DMFX-1/Hardware/README.md

# Hardware
Digital Multi FX Hardware:

DMFX-1 => Motherboard
DMFX-2 => Mezzanine board
Meca => Mechanics
  3D Models => 3D models for electronics 

- Block diagram (image, SVG)
- 3D models (FreeCad, STEP)
- Schematics (Eagle CAD, PDF) 
- PCB layout (Eagle CAD, gerbers)
- BoM (Excel, CSV, text)
