DMFX-1/Hardware/DMFX-2/readme-en.txt

DMFX-2 v1.0
Manufacturing info:

Bill of Materials:              DMFX-2 v1.0_BoM.xls

Assembly drawing Top:           DMFX-2 v1.0_assytop.pdf
Assembly Drawing Bottom:        DMFX-2 v1.0_assybot.pdf

Pick & Place Top:               DMFX-2 v1.0.mnt
Pick & Place Bottom:            DMFX-2 v1.0.mnb

Silkscreen Top:                 DMFX-2 v1.0_silkscreen_top.PLC
Silkscreen Bottom:              DMFX-2 v1.0_silkscreen_bottom.PLS

Solder Paste Top:               DMFX-2 v1.0_paste_top.PMC
Solder Paste Bottom:            DMFX-2 v1.0_paste_bottom.PMS

Solder Mask Top:                DMFX-2 v1.0_soldermask_top.STC
Solder Mask Bottom :            DMFX-2 v1.0_soldermask_bottom.STS

Signal Top layer:               DMFX-2 v1.0_signal_top.CMP
Signal layer 2:                 DMFX-2 v1.0_signal_lay2.COP
Signal layer 3:                 DMFX-2 v1.0_signal_lay3.COP
Signal layer 4:                 DMFX-2 v1.0_signal_lay4.COP
Signal layer 5:                 DMFX-2 v1.0_signal_lay5.COP
Signal Bottom layer:            DMFX-2 v1.0_signal_bottom.SOL

Drilling:                       DMFX-2 v1.0_drilling.DRD
Milling:                        DMFX-2 v1.0_milling.MIL

Photoplotter Info: *.gpi
