DMFX-1/Hardware/DMFX_block diagram.png

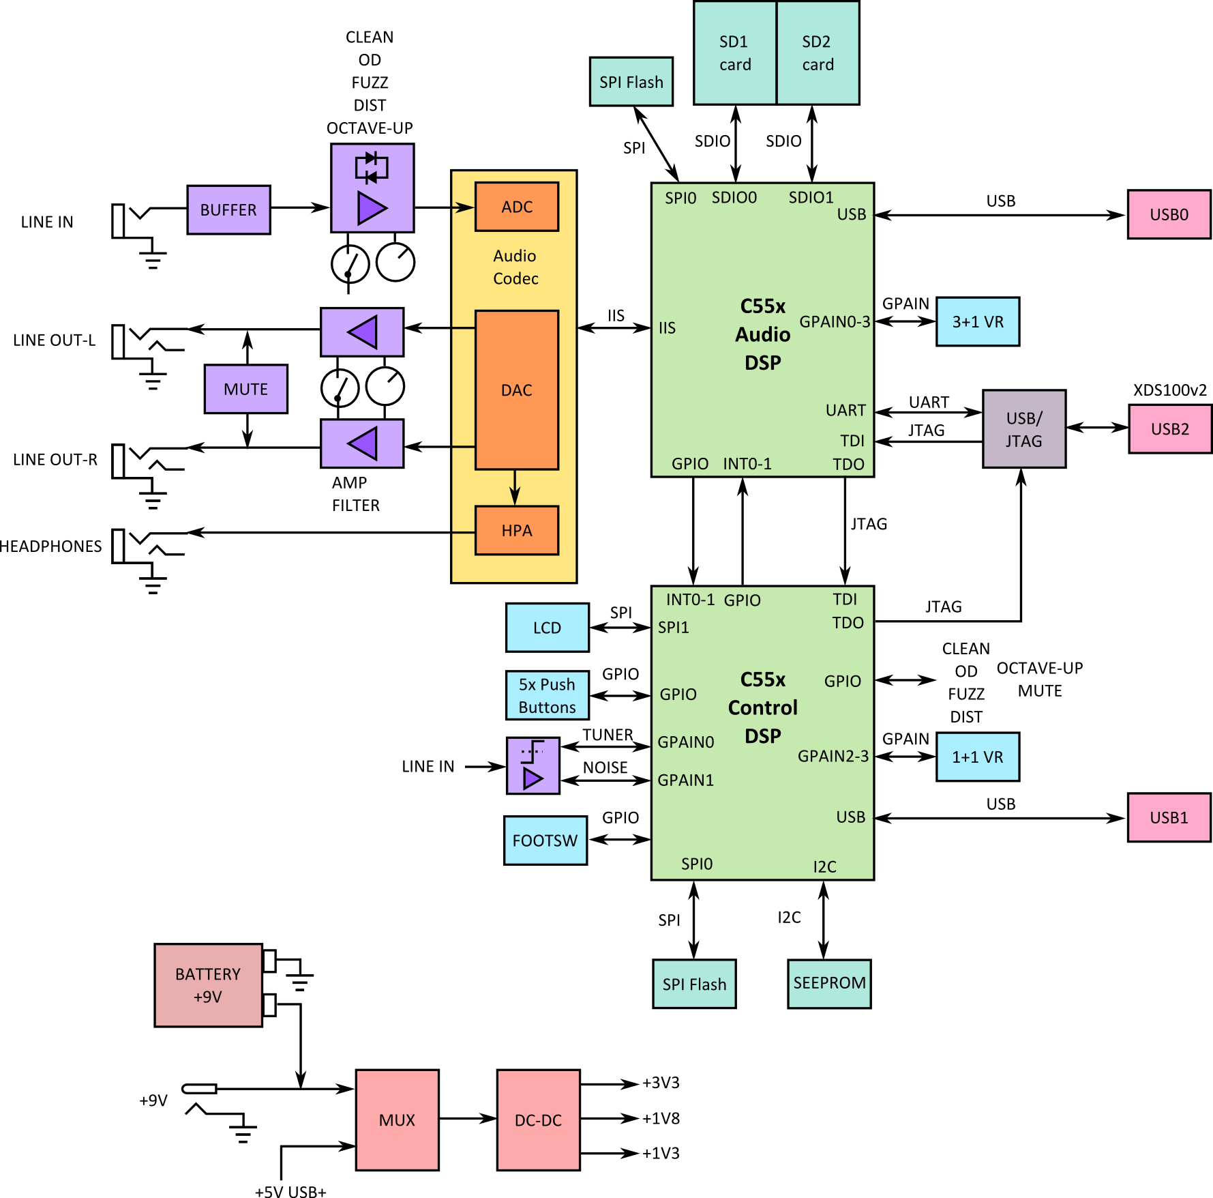
DMFX_block diagram.png
