DMFX-1/Hardware/Meca/3D models/DMFX v1.0-iso1.png

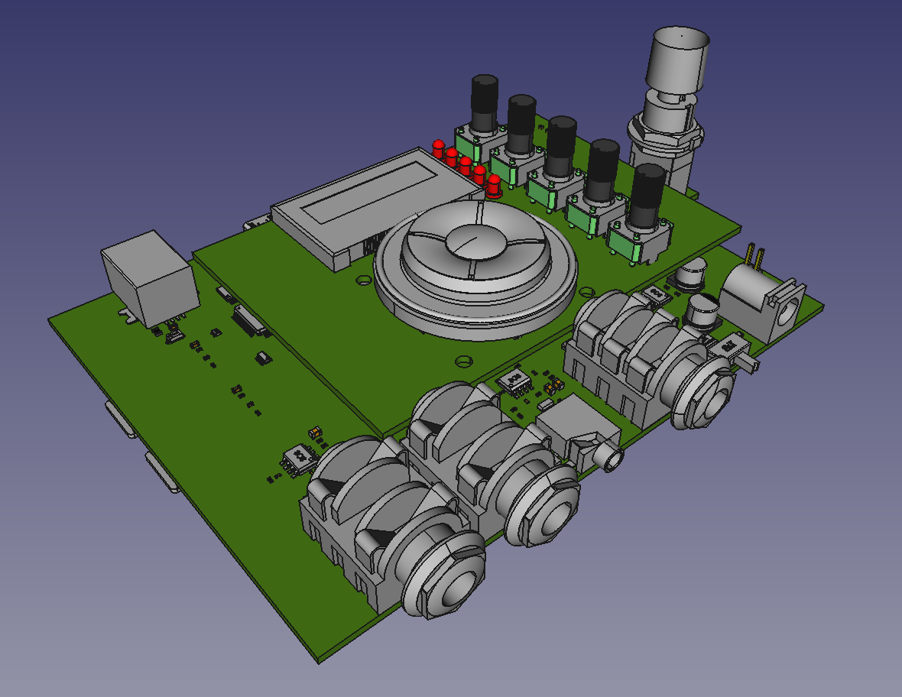
Meca/3D models/DMFX v1.0-iso1.png
