DMFX-1/Hardware/Meca/3D models/DMFX v1.0-iso2.png

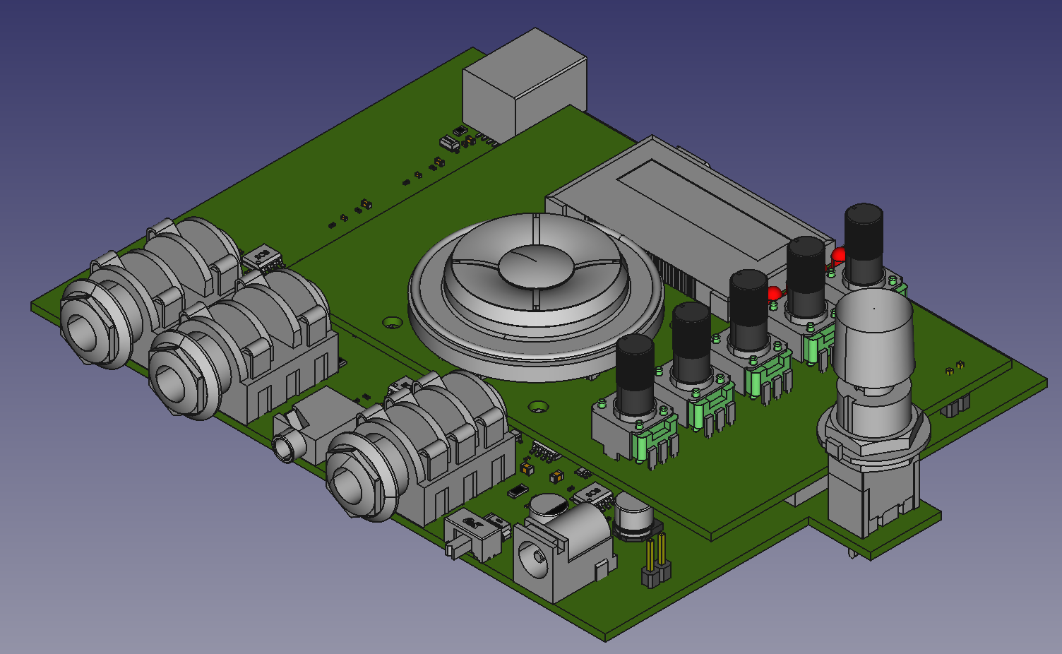
Meca/3D models/DMFX v1.0-iso2.png
