DMFX-1/Hardware/Meca/3D models/DMFX v1.0-left.PNG

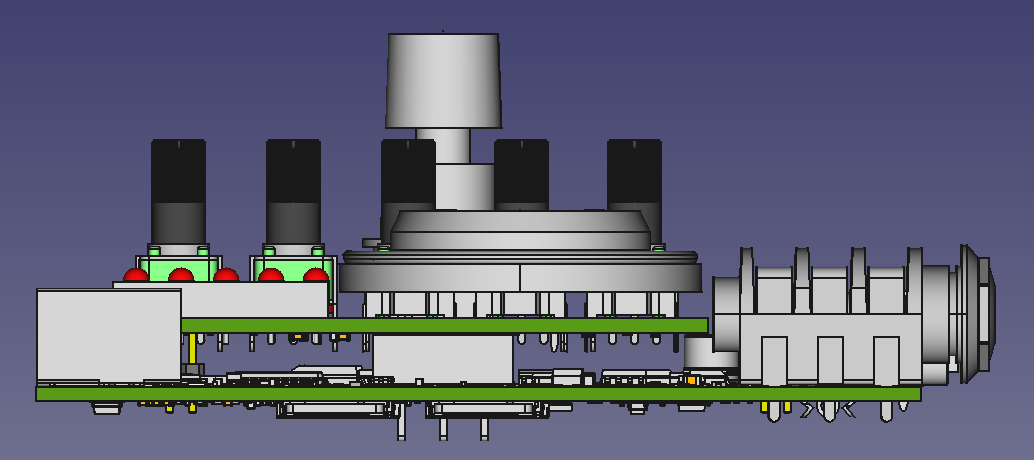
Meca/3D models/DMFX v1.0-left.PNG
