DMFX-1/Hardware/Meca/3D models/DMFX v1.0_rear.PNG

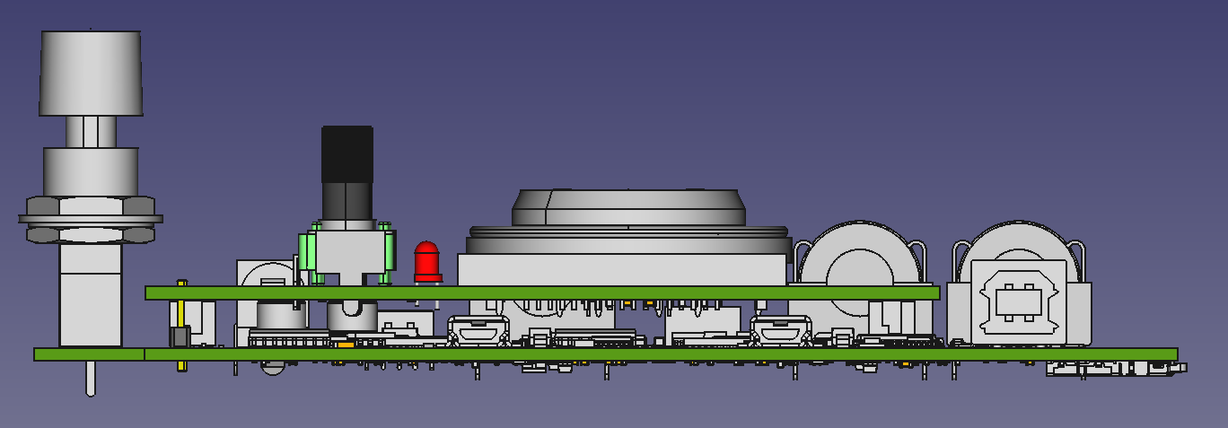
Meca/3D models/DMFX v1.0_rear.PNG
