DMFX-1/Hardware/DFMX-1_2_BoM.xls

Sheet: Eagle BoM
# | Digi-Key Part No. | Manufacturer Name | Mfr Part No. | Customer Reference | Qty1 | Qty2 | Qty3
1 | 160-1140-ND | Lite-On | LTL-4222N | led007 | 5 | 25 | 125
2 | 160-1435-1-ND | Lite-On | LTST-C190KGKT | led005 | 2 | 10 | 50
3 | 160-1456-1-ND | Lite-On | LTST-C230KGKT | led006 | 1 | 5 | 25
4 | 1SMA5920BT3GOSCT-ND | ON Semiconductor | 1SMA5920BT3G | diodez004 | 2 | 10 | 50
5 | 296-13405-1-ND | Texas Instruments | TPS3803-01DCKR | icvdet001 | 1 | 5 | 25
6 | 296-14854-1-ND | Texas Instruments | SN74HC4066DR | icmux002 | 1 | 5 | 25
7 | 296-14908-1-ND | Texas Instruments | SN74LVC1G3157DBVR | icmux001 | 1 | 5 | 25
8 | 296-15807-1-ND | Texas Instruments | TPS73201DBVT | icreg007 | 1 | 5 | 25
9 | 296-21883-1-ND | Texas Instruments | TPD2E001DRLR | tvs002 | 1 | 5 | 25
10 | 296-27589-1-ND | Texas Instruments | CDCLVC1108PWR | icbuf001 | 1 | 5 | 25
11 | 296-29560-ND | Texas Instruments | TMS320C5535AZHH10 | icdsp001 | 2 | 10 | 50
12 | 296-32298-1-ND | Texas Instruments | SN74LVC1G175DBVT | iclog003 | 1 | 5 | 25
13 | 296-32391-1-ND | Texas Instruments | TLV320AIC3204IRHBT | icacdc001 | 1 | 5 | 25
14 | 296-37302-1-ND | Texas Instruments | TPS562209DDCT | icreg006 | 2 | 10 | 50
15 | 296-41312-1-ND | Texas Instruments | LME49721MAX/NOPB | icopamp005 | 5 | 25 | 125
16 | 296-9121-1-ND | Texas Instruments | SN74CBTLV3245APWR | iclog002 | 1 | 5 | 25
17 | 296-9571-1-ND | Texas Instruments | LMV358IDR | icopamp004 | 1 | 5 | 25
18 | 2N7002ET1GOSCT-ND | ON Semiconductor | 2N7002ET1G | mos003 | 3 | 15 | 75
19 | 338-1805-1-ND | CornellDubilier | AVE107M25X16T-F | capelec001 | 2 | 10 | 50
20 | 490-10024-1-ND | Murata | GRM155R70J105KA12D | capcer047 | 22 | 110 | 550
21 | 490-1014-1-ND | Murata | BLM18AG601SN1D | fer007 | 12 | 60 | 300
22 | 490-10487-1-ND | Murata | GRM188R7YA105KA12D | capcer067 | 8 | 40 | 200
23 | 490-10516-1-ND | Murata | GRM21BR71A106KA73L | capcer053 | 9 | 45 | 225
24 | 490-1054-1-ND | Murata | BLM21PG221SN1D | fer005 | 3 | 15 | 75
25 | 490-1056-1-ND | Murata | BLM31PG121SN1L | fer002 | 3 | 15 | 75
26 | 490-10684-1-ND | Murata | GRM1555C1H221FA01D | capcer063 | 3 | 15 | 75
27 | 490-10702-1-ND | Murata | GRM155R71H473KE14D | capcer058 | 1 | 5 | 25
28 | 490-10758-1-ND | Murata | GRM32ER71E226ME15L | capcer066 | 2 | 10 | 50
29 | 490-1312-1-ND | Murata | GRM155R71E103KA01D | capcer050 | 20 | 100 | 500
30 | 490-3242-1-ND | Murata | GRM1555C1H821JA01D | capcer065 | 1 | 5 | 25
31 | 490-3295-1-ND | Murata | GRM188R71C474KA88D | capcer046 | 2 | 10 | 50
32 | 490-3297-1-ND | Murata | GRM188R60J475KE19D | capcer048 | 2 | 10 | 50
33 | 490-4002-1-ND | Murata | BLM15HD601SN1D | fer004 | 1 | 5 | 25
34 | 490-4519-1-ND | Murata | GRM155R60J225ME15D | capcer045 | 1 | 5 | 25
35 | 490-5309-1-ND | Murata | GRM31CR71A226KE15L | capcer056 | 3 | 15 | 75
36 | 490-5418-1-ND | Murata | GRM155R71C224KA12D | capcer062 | 1 | 5 | 25
37 | 490-6186-1-ND | Murata | GRM1555C1H100FA01D | capcer051 | 4 | 20 | 100
38 | 490-6241-1-ND | Murata | GRM1555C1H470FA01D | capcer059 | 1 | 5 | 25
39 | 490-6327-1-ND | Murata | GRM155R71C104JA88D | capcer042 | 91 | 455 | 2275
40 | 490-6345-1-ND | Murata | GRM155R71E333KA88J | capcer057 | 1 | 5 | 25
41 | 490-6349-1-ND | Murata | GRM155R71H102JA01J | capcer043 | 8 | 40 | 200
42 | 490-6356-1-ND | Murata | GRM155R71H183KA12D | capcer054 | 1 | 5 | 25
43 | 490-6359-1-ND | Murata | GRM155R71H222JA01J | capcer044 | 6 | 30 | 150
44 | 490-6365-1-ND | Murata | GRM155R71H822KA88D | capcer049 | 1 | 5 | 25
45 | 490-6985-1-ND | Murata | NFM3DPC223R1H3L | fer001 | 1 | 5 | 25
46 | 490-7201-1-ND | Murata | GRM188R61C106MA73D | capcer052 | 19 | 95 | 475
47 | 490-7303-1-ND | Murata | GRM1555C2A220JA01D | capcer055 | 3 | 15 | 75
48 | 490-7753-1-ND | Murata | GRM1555C1H101FA01J | capcer060 | 10 | 50 | 250
49 | 490-8186-1-ND | Murata | GRM1555C1H151GA01D | capcer061 | 2 | 10 | 50
50 | 490-8262-1-ND | Murata | GRM155R72A681KA01D | capcer064 | 1 | 5 | 25
51 | 490-9703-1-ND | Murata | BLM21AG151SN1D | fer006 | 2 | 10 | 50
52 | 535-9784-1-ND | Abracon LLC | ASDM1-12.000MHZ-LC-T | osc0001 | 1 | 5 | 25
53 | 609-1550-ND | FCI | 87024-610LF | con0019 | 2 | 10 | 50
54 | 609-1553-ND | FCI | 87409-110LF | con015 | 2 | 10 | 50
55 | 609-4700-1-ND | FCI | 10033526-N3212LF | con018 | 2 | 10 | 50
56 | 679-2576-ND | MEC Switches | 5ETH935 | sw0010 | 4 | 20 | 100
57 | 679-2608-ND | MEC Switches | 1ZW0913611806 | sw0007 | 1 | 5 | 25
58 | 679-2609-ND | MEC Switches | 1ZZ09 | sw0008 | 1 | 5 | 25
59 | 679-2610-ND | MEC Switches | 1ZY | sw0007 | 1 | 5 | 25
60 | 679-2612-ND | MEC Switches | 5GTH935 | sw0009 | 1 | 5 | 25
61 | 728-1064-1-ND | Seiko Instruments | SSPT7F-12.5PF20-R | xtal001 | 2 | 10 | 50
62 | 768-1024-1-ND | FTDI | FT2232HL-REEL | icif001 | 1 | 5 | 25
63 | 952-1768-ND | Harwin | M701-370442 | con017 | 1 | 5 | 25
64 | AT24C64D-SSHM-TCT-ND | Atmel | AT24C64D-SSHM-T | icmem001 | 1 | 5 | 25
65 | AT93C46D-TH-TCT-ND | Atmel | AT93C46D-TH-T | icmem003 | 1 | 5 | 25
66 | ATCC-211B-010-107M-TCT-ND | Abracon LLC | ATCC-211B-010-107M-T | captant002 | 2 | 10 | 50
67 | BAT54LT1GOSCT-ND | ON Semiconductor | BAT54LT1G | diodes005 | 1 | 5 | 25
68 | BAT54SLT1GOSCT-ND | ON Semiconductor | BAT54SLT1G | diodes004 | 2 | 10 | 50
69 | CKN9559-ND | C&K Components | OS102011MA1QN1 | sw0006 | 1 | 5 | 25
70 | CP1-3515SJCT-ND | CUI | SJ1-3515-SMT-TR | con016 | 1 | 5 | 25
71 | CP-202A-ND | CUI | PJ-202A | con014 | 1 | 5 | 25
72 | HR1942CT-ND | Hirose | DM3BT-DSF-PEJS | con013 | 2 | 10 | 50
73 | MB2011SB1W03-DA-ND | NKK Switches | MB2011SB1W03-DA | sw0005 | 1 | 5 | 25
74 | MBR0520LT1GOSCT-ND | ON Semiconductor | MBR0520LT1G | diodes006 | 4 | 20 | 100
75 | MMBF4393CT-ND | Fairchild Semiconductor | MMBF4393 | jfet001 | 1 | 5 | 25
76 | MUN2214T1GOSCT-ND | ON Semiconductor | MUN2214T1G | bjtp001 | 6 | 30 | 150
77 | NHD-C12832A1Z-NSW-BBW-3V3-ND | Newhaven Display Intl | NHD-C12832A1Z-NSW-BBW-3V3 | lcd001 | 1 | 5 | 25
78 | P0.0ACT-ND | Panasonic | ERJ-6GEY0R00V | res104 | 5 | 25 | 125
79 | P0.0JCT-ND | Panasonic | ERJ-2GE0R00X | res074 | 40 | 200 | 1000
80 | P1.00KLCT-ND | Panasonic | ERJ-2RKF1001X | res077 | 9 | 45 | 225
81 | P1.00MLCT-ND | Panasonic | ERJ-2RKF1004X | res076 | 2 | 10 | 50
82 | P1.30KLCT-ND | Panasonic | ERJ-2RKF1301X | res075 | 2 | 10 | 50
83 | P10.0KLCT-ND | Panasonic | ERJ-2RKF1002X | res083 | 64 | 320 | 1600
84 | P10.0LCT-ND | Panasonic | ERJ-2RKF10R0X | res082 | 8 | 40 | 200
85 | P100KLCT-ND | Panasonic | ERJ-2RKF1003X | res095 | 16 | 80 | 400
86 | P100LCT-ND | Panasonic | ERJ-2RKF1000X | res094 | 1 | 5 | 25
87 | P12.0KLCT-ND | Panasonic | ERJ-2RKF1202X | res084 | 8 | 40 | 200
88 | P13.7KLCT-ND | Panasonic | ERJ-2RKF1372X | res085 | 1 | 5 | 25
89 | P15.0KLCT-ND | Panasonic | ERJ-2RKF1502X | res086 | 1 | 5 | 25
90 | P18.0KLCT-ND | Panasonic | ERJ-2RKF1802X | res087 | 1 | 5 | 25
91 | P180KLCT-ND | Panasonic | ERJ-2RKF1803X | res096 | 3 | 15 | 75
92 | P2.00KLCT-ND | Panasonic | ERJ-2RKF2001X | res079 | 2 | 10 | 50
93 | P2.20KLCT-ND | Panasonic | ERJ-2RKF2201X | res078 | 3 | 15 | 75
94 | P20.5KLCT-ND | Panasonic | ERJ-2RKF2052X | res088 | 1 | 5 | 25
95 | P22.0KLCT-ND | Panasonic | ERJ-2RKF2202X | res089 | 2 | 10 | 50
96 | P220KLCT-ND | Panasonic | ERJ-2RKF2203X | res098 | 2 | 10 | 50
97 | P220LCT-ND | Panasonic | ERJ-2RKF2200X | res097 | 8 | 40 | 200
98 | P243KLCT-ND | Panasonic | ERJ-2RKF2433X | res099 | 1 | 5 | 25
99 | P33.0KLCT-ND | Panasonic | ERJ-2RKF3302X | res091 | 1 | 5 | 25
100 | P33.0LCT-ND | Panasonic | ERJ-2RKF33R0X | res105 | 8 | 40 | 200
101 | P33.2KLCT-ND | Panasonic | ERJ-2RKF3322X | res090 | 1 | 5 | 25
102 | P330LCT-ND | Panasonic | ERJ-2RKF3300X | res100 | 2 | 10 | 50
103 | P3C3503-ND | Panasonic | EVU-F2AF30B54 | pot010 | 5 | 25 | 125
104 | P4.70KHCT-ND | Panasonic | ERJ-3EKF4701V | res027 | 1 | 5 | 25
105 | P4.70KLCT-ND | Panasonic | ERJ-2RKF4701X | res080 | 7 | 35 | 175
106 | P47.0KLCT-ND | Panasonic | ERJ-2RKF4702X | res092 | 4 | 20 | 100
107 | P470LCT-ND | Panasonic | ERJ-2RKF4700X | res101 | 2 | 10 | 50
108 | P56.0KLCT-ND | Panasonic | ERJ-2RKF5602X | res093 | 1 | 5 | 25
109 | P560LCT-ND | Panasonic | ERJ-2RKF5600X | res102 | 1 | 5 | 25
110 | P680KLCT-ND | Panasonic | ERJ-2RKF6803X | res103 | 1 | 5 | 25
111 | P8.20KLCT-ND | Panasonic | ERJ-2RKF8201X | res081 | 2 | 10 | 50
112 | S1G-FDICT-ND | Diodes Inc. | S1G-13-F | diode0005 | 1 | 5 | 25
113 | SRN3015-2R2MCT-ND | Bourns | SRN3015-2R2M | ind005 | 1 | 5 | 25
114 | SRN3015-3R3MCT-ND | Bourns | SRN3015-3R3M | ind006 | 1 | 5 | 25
115 | W25Q64FVSFIG-ND | Winbond Electronics | W25Q64FVSFIG | icmem002 | 2 | 10 | 50

Sheet: Digikey BoM
Index | Quantité | Référence | Description | Prix unitaire | Montant
1 | 2 | 296-29560-ND (http://www.digikey.fr/scripts/DkSearch/dksus.dll?Detail&itemSeq=175391608&uq=635716863592282284) | IC DSP FIXED-POINT 144BGA | 12.80000 | 25.6 | TRUE | 25.6
2 | 2 | 728-1064-1-ND (http://www.digikey.fr/scripts/DkSearch/dksus.dll?Detail&itemSeq=175391607&uq=635716863592282284) | CRYSTAL 32.7680KHZ 12.5PF SMD | 0.62000 | 1.24 | TRUE | 1.24
3 | 1 | 296-9571-1-ND (http://www.digikey.fr/scripts/DkSearch/dksus.dll?Detail&itemSeq=175391604&uq=635716863592282284) | IC OPAMP GP 1MHZ RRO 8SOIC | 0.78000 | 0.78 | TRUE | 0.78
4 | 5 | 296-41312-1-ND (http://www.digikey.fr/scripts/DkSearch/dksus.dll?Detail&itemSeq=175391601&uq=635716863592282284) | IC OPAMP AUDIO 20MHZ RRO 8SOIC | 1.83000 | 9.15 | TRUE | 9.15
5 | 1 | MB2011SB1W03-DA-ND (http://www.digikey.fr/scripts/DkSearch/dksus.dll?Detail&itemSeq=175391597&uq=635716863592282284) | SWITCH PUSHBUTTON SPDT 6A 125V | 7.23000 | 7.23 | TRUE | 7.23
6 | 1 | 296-9121-1-ND (http://www.digikey.fr/scripts/DkSearch/dksus.dll?Detail&itemSeq=175391596&uq=635716863592282284) | IC LV OCTAL FET BUS SW 20-TSSOP | 0.92000 | 0.92 | TRUE | 0.92
7 | 1 | 296-32391-1-ND (http://www.digikey.fr/scripts/DkSearch/dksus.dll?Detail&itemSeq=175391590&uq=635716863592282284) | IC STEREO AUDIO CODEC 1.8V 32QFN | 6.42000 | 6.42 | TRUE | 6.42
8 | 1 | 296-27589-1-ND (http://www.digikey.fr/scripts/DkSearch/dksus.dll?Detail&itemSeq=175391611&uq=635716863592282284) | IC CLK BUFFER 1:8 250MHZ 16TSSOP | 4.44000 | 4.44 | TRUE | 4.44
9 | 1 | 535-9784-1-ND (http://www.digikey.fr/scripts/DkSearch/dksus.dll?Detail&itemSeq=175391609&uq=635716863592282284) | OSC MEMS 12.000MHZ CMOS SMD | 1.80000 | 1.8 | TRUE | 1.8
10 | 1 | 296-14908-1-ND (http://www.digikey.fr/scripts/DkSearch/dksus.dll?Detail&itemSeq=175391605&uq=635716863592282284) | IC SWITCH SPDT SOT23-6 | 0.38000 | 0.38 | TRUE | 0.38
11 | 2 | 296-37302-1-ND (http://www.digikey.fr/scripts/DkSearch/dksus.dll?Detail&itemSeq=175391602&uq=635716863592282284) | IC REG BUCK ADJ 2A SYNC SOT-23-6 | 1.57000 | 3.14 | TRUE | 3.14
12 | 1 | 296-15807-1-ND (http://www.digikey.fr/scripts/DkSearch/dksus.dll?Detail&itemSeq=175391598&uq=635716863592282284) | IC REG LDO ADJ 0.25A SOT23-5 | 1.65000 | 1.65 | TRUE | 1.65
13 | 1 | AT24C64D-SSHM-TCT-ND (http://www.digikey.fr/scripts/DkSearch/dksus.dll?Detail&itemSeq=175391593&uq=635716863592282284) | IC EEPROM 64KBIT 1MHZ 8SOIC | 0.57000 | 0.57 | TRUE | 0.57
14 | 2 | W25Q64FVSFIG-ND (http://www.digikey.fr/scripts/DkSearch/dksus.dll?Detail&itemSeq=175391589&uq=635716863592282284) | IC FLASH 64MBIT 104MHZ 16SOIC | 1.10000 | 2.2 | TRUE | 2.2
15 | 1 | 296-32298-1-ND (http://www.digikey.fr/scripts/DkSearch/dksus.dll?Detail&itemSeq=175391587&uq=635716863592282284) | IC D-TYPE POS TRG SNGL SOT23-6 | 0.82000 | 0.82 | TRUE | 0.82
16 | 1 | 296-21883-1-ND (http://www.digikey.fr/scripts/DkSearch/dksus.dll?Detail&itemSeq=175391610&uq=635716863592282284) | TVS DIODE 5.5VWM 100VC SOT5 | 0.60000 | 0.6 | TRUE | 0.6
17 | 1 | 768-1024-1-ND (http://www.digikey.fr/scripts/DkSearch/dksus.dll?Detail&itemSeq=175391606&uq=635716863592282284) | IC USB HS DUAL UART/FIFO 64-LQFP | 6.57000 | 6.57 | TRUE | 6.57
18 | 1 | 296-13405-1-ND (http://www.digikey.fr/scripts/DkSearch/dksus.dll?Detail&itemSeq=175391603&uq=635716863592282284) | IC VOLT DETECTOR ADJ/1.5V SC70-5 | 0.85000 | 0.85 | TRUE | 0.85
19 | 1 | AT93C46D-TH-TCT-ND (http://www.digikey.fr/scripts/DkSearch/dksus.dll?Detail&itemSeq=175391600&uq=635716863592282284) | IC EEPROM 1KBIT 2MHZ 8TSSOP | 0.29000 | 0.29 | TRUE | 0.29
20 | 1 | CKN9559-ND (http://www.digikey.fr/scripts/DkSearch/dksus.dll?Detail&itemSeq=175391594&uq=635716863592282284) | SWITCH SLIDE SPDT 100MA 12V | 0.42000 | 0.42 | TRUE | 0.42
21 | 6 | MUN2214T1GOSCT-ND (http://www.digikey.fr/scripts/DkSearch/dksus.dll?Detail&itemSeq=175391592&uq=635716863592282284) | TRANS PREBIAS NPN 230MW SC59 | 0.16000 | 0.96 | TRUE | 0.96
22 | 3 | 2N7002ET1GOSCT-ND (http://www.digikey.fr/scripts/DkSearch/dksus.dll?Detail&itemSeq=175391588&uq=635716863592282284) | MOSFET N-CH 60V 260MA SOT-23 | 0.15000 | 0.45 | TRUE | 0.45
23 | 1 | MMBF4393CT-ND (http://www.digikey.fr/scripts/DkSearch/dksus.dll?Detail&itemSeq=175391583&uq=635716863592282284) | JFET N-CH 30V 350MW SOT23 | 0.55000 | 0.55 | TRUE | 0.55
24 | 1 | 490-4002-1-ND (http://www.digikey.fr/scripts/DkSearch/dksus.dll?Detail&itemSeq=175391599&uq=635716863592282284) | FILTER CHIP 600 OHM 300MA 0402 | 0.23000 | 0.23 | TRUE | 0.23
25 | 3 | 490-1054-1-ND (http://www.digikey.fr/scripts/DkSearch/dksus.dll?Detail&itemSeq=175391595&uq=635716863592282284) | FERRITE CHIP 220 OHM 0805 | 0.11000 | 0.33 | TRUE | 0.33
26 | 2 | HR1942CT-ND (http://www.digikey.fr/scripts/DkSearch/dksus.dll?Detail&itemSeq=175391591&uq=635716863592282284) | CONN MICRO SD CARD PUSH-PUSH R/A | 2.50000 | 5 | TRUE | 5
27 | 1 | CP-202A-ND (http://www.digikey.fr/scripts/DkSearch/dksus.dll?Detail&itemSeq=175391585&uq=635716863592282284) | CONN POWER JACK 2.1MM PCB | 0.91000 | 0.91 | TRUE | 0.91
28 | 2 | 609-1553-ND (http://www.digikey.fr/scripts/DkSearch/dksus.dll?Detail&itemSeq=175391584&uq=635716863592282284) | CONN HEADER 20POS .050 VERT SMD | 2.07000 | 4.14 | TRUE | 4.14
29 | 1 | CP1-3515SJCT-ND (http://www.digikey.fr/scripts/DkSearch/dksus.dll?Detail&itemSeq=175391582&uq=635716863592282284) | CONN JACK STEREO 5POS 3.5MM SMD | 1.68000 | 1.68 | TRUE | 1.68
30 | 1 | 952-1768-ND (http://www.digikey.fr/scripts/DkSearch/dksus.dll?Detail&itemSeq=175391578&uq=635716863592282284) | 00B B SINGLE SMT HORIZ CONNECTOR | 1.33000 | 1.33 | TRUE | 1.33
31 | 2 | 609-4700-1-ND (http://www.digikey.fr/scripts/DkSearch/dksus.dll?Detail&itemSeq=175391575&uq=635716863592282284) | CONN MINI USB RCPT RA TYPE B SMD | 0.70000 | 1.4 | TRUE | 1.4
32 | 1 | 296-14854-1-ND (http://www.digikey.fr/scripts/DkSearch/dksus.dll?Detail&itemSeq=175391586&uq=635716863592282284) | IC SWITCH QUAD 1X1 14SOIC | 0.46000 | 0.46 | TRUE | 0.46
33 | 3 | 490-1056-1-ND (http://www.digikey.fr/scripts/DkSearch/dksus.dll?Detail&itemSeq=175391580&uq=635716863592282284) | FERRITE CHIP 120 OHM 3500MA 1206 | 0.30000 | 0.9 | TRUE | 0.9
34 | 4 | 490-9703-1-ND (http://www.digikey.fr/scripts/DkSearch/dksus.dll?Detail&itemSeq=175391577&uq=635716863592282284) | FERRITE CHIP 150 OHM 0805 | 0.15000 | 0.6 | TRUE | 0.6
35 | 16 | 490-1014-1-ND (http://www.digikey.fr/scripts/DkSearch/dksus.dll?Detail&itemSeq=175391573&uq=635716863592282284) | FERRITE CHIP 600 OHM 500MA 0603 | 0.07700 | 1.23 | TRUE | 1.232
36 | 2 | 160-1435-1-ND (http://www.digikey.fr/scripts/DkSearch/dksus.dll?Detail&itemSeq=175391581&uq=635716863592282284) | LED GREEN CLEAR 0603 SMD | 0.27000 | 0.54 | TRUE | 0.54
37 | 1 | 160-1456-1-ND (http://www.digikey.fr/scripts/DkSearch/dksus.dll?Detail&itemSeq=175391576&uq=635716863592282284) | LED GREEN CLEAR 1206 REV MT SMD | 0.36000 | 0.36 | TRUE | 0.36
38 | 1 | S1G-FDICT-ND (http://www.digikey.fr/scripts/DkSearch/dksus.dll?Detail&itemSeq=175391570&uq=635716863592282284) | DIODE GEN PURP 400V 1A SMA | 0.26000 | 0.26 | TRUE | 0.26
39 | 2 | BAT54SLT1GOSCT-ND (http://www.digikey.fr/scripts/DkSearch/dksus.dll?Detail&itemSeq=175391567&uq=635716863592282284) | DIODE ARRAY SCHOTTKY 30V SOT23-3 | 0.20000 | 0.4 | TRUE | 0.4
40 | 1 | BAT54LT1GOSCT-ND (http://www.digikey.fr/scripts/DkSearch/dksus.dll?Detail&itemSeq=175391579&uq=635716863592282284) | DIODE SCHOTTKY 30V 200MA SOT23-3 | 0.20000 | 0.2 | TRUE | 0.2
41 | 4 | MBR0520LT1GOSCT-ND (http://www.digikey.fr/scripts/DkSearch/dksus.dll?Detail&itemSeq=175391574&uq=635716863592282284) | DIODE SCHOTTKY 20V 500MA SOD123 | 0.34000 | 1.36 | TRUE | 1.36
42 | 2 | 1SMA5920BT3GOSCT-ND (http://www.digikey.fr/scripts/DkSearch/dksus.dll?Detail&itemSeq=175391569&uq=635716863592282284) | DIODE ZENER 6.2V 1.5W SMA | 0.44000 | 0.88 | TRUE | 0.88
43 | 1 | 490-6985-1-ND (http://www.digikey.fr/scripts/DkSearch/dksus.dll?Detail&itemSeq=175391565&uq=635716863592438285) | FILTER LC HIGH FREQ 22000PF 1206 | 0.64000 | 0.64 | TRUE | 0.64
44 | 60 | P0.0JCT-ND (http://www.digikey.fr/scripts/DkSearch/dksus.dll?Detail&itemSeq=175391571&uq=635716863592438285) | RES SMD 0.0 OHM JUMPER 1/10W | 0.01360 | 0.82 | TRUE | 0.816
45 | 2 | P1.30KLCT-ND (http://www.digikey.fr/scripts/DkSearch/dksus.dll?Detail&itemSeq=175391566&uq=635716863592438285) | RES SMD 1.3K OHM 1% 1/10W 0402 | 0.10000 | 0.2 | TRUE | 0.2
46 | 2 | P1.00MLCT-ND (http://www.digikey.fr/scripts/DkSearch/dksus.dll?Detail&itemSeq=175391563&uq=635716863592438285) | RES SMD 1M OHM 1% 1/10W 0402 | 0.10000 | 0.2 | TRUE | 0.2
47 | 50 | P1.00KLCT-ND (http://www.digikey.fr/scripts/DkSearch/dksus.dll?Detail&itemSeq=175391559&uq=635716863592438285) | RES SMD 1K OHM 1% 1/10W 0402 | 0.01460 | 0.73 | TRUE | 0.73
48 | 3 | P2.20KLCT-ND (http://www.digikey.fr/scripts/DkSearch/dksus.dll?Detail&itemSeq=175391568&uq=635716863592438285) | RES SMD 2.2K OHM 1% 1/10W 0402 | 0.10000 | 0.3 | TRUE | 0.3
49 | 2 | P2.00KLCT-ND (http://www.digikey.fr/scripts/DkSearch/dksus.dll?Detail&itemSeq=175391564&uq=635716863592438285) | RES SMD 2K OHM 1% 1/10W 0402 | 0.10000 | 0.2 | TRUE | 0.2
50 | 50 | P4.70KLCT-ND (http://www.digikey.fr/scripts/DkSearch/dksus.dll?Detail&itemSeq=175391561&uq=635716863592438285) | RES SMD 4.7K OHM 1% 1/10W 0402 | 0.01460 | 0.73 | TRUE | 0.73
51 | 2 | P8.20KLCT-ND (http://www.digikey.fr/scripts/DkSearch/dksus.dll?Detail&itemSeq=175391557&uq=635716863592438285) | RES SMD 8.2K OHM 1% 1/10W 0402 | 0.10000 | 0.2 | TRUE | 0.2
52 | 50 | P10.0LCT-ND (http://www.digikey.fr/scripts/DkSearch/dksus.dll?Detail&itemSeq=175391562&uq=635716863592438285) | RES SMD 10 OHM 1% 1/10W 0402 | 0.01460 | 0.73 | TRUE | 0.73
53 | 64 | P10.0KLCT-ND (http://www.digikey.fr/scripts/DkSearch/dksus.dll?Detail&itemSeq=175391558&uq=635716863592438285) | RES SMD 10K OHM 1% 1/10W 0402 | 0.01460 | 0.88 | TRUE | 0.9344
54 | 50 | P12.0KLCT-ND (http://www.digikey.fr/scripts/DkSearch/dksus.dll?Detail&itemSeq=175391553&uq=635716863592438285) | RES SMD 12K OHM 1% 1/10W 0402 | 0.01460 | 0.73 | TRUE | 0.73
55 | 1 | P13.7KLCT-ND (http://www.digikey.fr/scripts/DkSearch/dksus.dll?Detail&itemSeq=175391549&uq=635716863592438285) | RES SMD 13.7K OHM 1% 1/10W 0402 | 0.10000 | 0.1 | TRUE | 0.1
56 | 1 | P15.0KLCT-ND (http://www.digikey.fr/scripts/DkSearch/dksus.dll?Detail&itemSeq=175391560&uq=635716863592438285) | RES SMD 15K OHM 1% 1/10W 0402 | 0.10000 | 0.1 | TRUE | 0.1
57 | 1 | P18.0KLCT-ND (http://www.digikey.fr/scripts/DkSearch/dksus.dll?Detail&itemSeq=175391554&uq=635716863592438285) | RES SMD 18K OHM 1% 1/10W 0402 | 0.10000 | 0.1 | TRUE | 0.1
58 | 1 | P20.5KLCT-ND (http://www.digikey.fr/scripts/DkSearch/dksus.dll?Detail&itemSeq=175391550&uq=635716863592438285) | RES SMD 20.5K OHM 1% 1/10W 0402 | 0.10000 | 0.1 | TRUE | 0.1
59 | 2 | P22.0KLCT-ND (http://www.digikey.fr/scripts/DkSearch/dksus.dll?Detail&itemSeq=175391546&uq=635716863592438285) | RES SMD 22K OHM 1% 1/10W 0402 | 0.10000 | 0.2 | TRUE | 0.2
60 | 1 | P33.2KLCT-ND (http://www.digikey.fr/scripts/DkSearch/dksus.dll?Detail&itemSeq=175391556&uq=635716863592438285) | RES SMD 33.2K OHM 1% 1/10W 0402 | 0.10000 | 0.1 | TRUE | 0.1
61 | 1 | P33.0KLCT-ND (http://www.digikey.fr/scripts/DkSearch/dksus.dll?Detail&itemSeq=175391552&uq=635716863592438285) | RES SMD 33K OHM 1% 1/10W 0402 | 0.10000 | 0.1 | TRUE | 0.1
62 | 4 | P47.0KLCT-ND (http://www.digikey.fr/scripts/DkSearch/dksus.dll?Detail&itemSeq=175391548&uq=635716863592438285) | RES SMD 47K OHM 1% 1/10W 0402 | 0.10000 | 0.4 | TRUE | 0.4
63 | 1 | P56.0KLCT-ND (http://www.digikey.fr/scripts/DkSearch/dksus.dll?Detail&itemSeq=175391545&uq=635716863592438285) | RES SMD 56K OHM 1% 1/10W 0402 | 0.10000 | 0.1 | TRUE | 0.1
64 | 1 | P100LCT-ND (http://www.digikey.fr/scripts/DkSearch/dksus.dll?Detail&itemSeq=175391555&uq=635716863592438285) | RES SMD 100 OHM 1% 1/10W 0402 | 0.10000 | 0.1 | TRUE | 0.1
65 | 50 | P100KLCT-ND (http://www.digikey.fr/scripts/DkSearch/dksus.dll?Detail&itemSeq=175391551&uq=635716863592438285) | RES SMD 100K OHM 1% 1/10W 0402 | 0.01460 | 0.73 | TRUE | 0.73
66 | 3 | P180KLCT-ND (http://www.digikey.fr/scripts/DkSearch/dksus.dll?Detail&itemSeq=175391544&uq=635716863592438285) | RES SMD 180K OHM 1% 1/10W 0402 | 0.10000 | 0.3 | TRUE | 0.3
67 | 50 | P220LCT-ND (http://www.digikey.fr/scripts/DkSearch/dksus.dll?Detail&itemSeq=175391541&uq=635716863592438285) | RES SMD 220 OHM 1% 1/10W 0402 | 0.10000 | 0.3 | TRUE | 5
68 | 2 | P220KLCT-ND (http://www.digikey.fr/scripts/DkSearch/dksus.dll?Detail&itemSeq=175391547&uq=635716863592438285) | RES SMD 220K OHM 1% 1/10W 0402 | 0.10000 | 0.2 | TRUE | 0.2
69 | 1 | P243KLCT-ND (http://www.digikey.fr/scripts/DkSearch/dksus.dll?Detail&itemSeq=175391543&uq=635716863592438285) | RES SMD 243K OHM 1% 1/10W 0402 | 0.10000 | 0.1 | TRUE | 0.1
70 | 2 | P330LCT-ND (http://www.digikey.fr/scripts/DkSearch/dksus.dll?Detail&itemSeq=175391539&uq=635716863592438285) | RES SMD 330 OHM 1% 1/10W 0402 | 0.10000 | 0.2 | TRUE | 0.2
71 | 2 | P470LCT-ND (http://www.digikey.fr/scripts/DkSearch/dksus.dll?Detail&itemSeq=175391535&uq=635716863592438285) | RES SMD 470 OHM 1% 1/10W 0402 | 0.10000 | 0.2 | TRUE | 0.2
72 | 2 | P560LCT-ND (http://www.digikey.fr/scripts/DkSearch/dksus.dll?Detail&itemSeq=175391537&uq=635716863592438285) | RES SMD 560 OHM 1% 1/10W 0402 | 0.10000 | 0.2 | TRUE | 0.2
73 | 1 | P680KLCT-ND (http://www.digikey.fr/scripts/DkSearch/dksus.dll?Detail&itemSeq=175391533&uq=635716863592438285) | RES SMD 680K OHM 1% 1/10W 0402 | 0.10000 | 0.1 | TRUE | 0.1
74 | 1 | P4.70KHCT-ND (http://www.digikey.fr/scripts/DkSearch/dksus.dll?Detail&itemSeq=175391542&uq=635716863592438285) | RES SMD 4.7K OHM 1% 1/10W 0603 | 0.10000 | 0.1 | TRUE | 0.1
75 | 6 | P0.0ACT-ND (http://www.digikey.fr/scripts/DkSearch/dksus.dll?Detail&itemSeq=175391538&uq=635716863592438285) | RES SMD 0.0 OHM JUMPER 1/8W 0805 | 0.10000 | 0.6 | TRUE | 0.6
76 | 100 | 490-6327-1-ND (http://www.digikey.fr/scripts/DkSearch/dksus.dll?Detail&itemSeq=175391534&uq=635716863592438285) | CAP CER 0.1UF 16V 5% X7R 0402 | 0.01400 | 1.4 | TRUE | 1.4
77 | 10 | 490-6349-1-ND (http://www.digikey.fr/scripts/DkSearch/dksus.dll?Detail&itemSeq=175391530&uq=635716863592438285) | CAP CER 1000PF 50V 5% X7R 0402 | 0.01200 | 0.12 | TRUE | 0.12
78 | 10 | 490-6359-1-ND (http://www.digikey.fr/scripts/DkSearch/dksus.dll?Detail&itemSeq=175391540&uq=635716863592438285) | CAP CER 2200PF 50V 5% X7R 0402 | 0.01600 | 0.16 | TRUE | 0.16
79 | 1 | 490-4519-1-ND (http://www.digikey.fr/scripts/DkSearch/dksus.dll?Detail&itemSeq=175391536&uq=635716863592438285) | CAP CER 2.2UF 6.3V 20% X5R 0402 | 0.24000 | 0.24 | TRUE | 0.24
80 | 2 | 490-3295-1-ND (http://www.digikey.fr/scripts/DkSearch/dksus.dll?Detail&itemSeq=175391532&uq=635716863592438285) | CAP CER 0.47UF 16V 10% X7R 0603 | 0.21000 | 0.42 | TRUE | 0.42
81 | 50 | 490-10024-1-ND (http://www.digikey.fr/scripts/DkSearch/dksus.dll?Detail&itemSeq=175391528&uq=635716863592438285) | CAP CER 1UF 6.3V 10% 0402 | 0.04020 | 2.01 | TRUE | 2.01
82 | 1 | SRN3015-2R2MCT-ND (http://www.digikey.fr/scripts/DkSearch/dksus.dll?Detail&itemSeq=175391531&uq=635716863592438285) | FIXED IND 2.2UH 1.8A 72 MOHM SMD | 0.35000 | 0.35 | TRUE | 0.35
83 | 1 | SRN3015-3R3MCT-ND (http://www.digikey.fr/scripts/DkSearch/dksus.dll?Detail&itemSeq=175391527&uq=635716863592438285) | FIXED IND 3.3UH 1.6A 112 MOHM | 0.35000 | 0.35 | TRUE | 0.35
84 | 2 | 490-3297-1-ND (http://www.digikey.fr/scripts/DkSearch/dksus.dll?Detail&itemSeq=175391529&uq=635716863592438285) | CAP CER 4.7UF 6.3V 10% X5R 0603 | 0.24000 | 0.48 | TRUE | 0.48
85 | 1 | 490-6365-1-ND (http://www.digikey.fr/scripts/DkSearch/dksus.dll?Detail&itemSeq=175391525&uq=635716863592438285) | CAP CER 8200PF 50V 10% X7R 0402 | 0.10000 | 0.1 | TRUE | 0.1
86 | 20 | 490-1312-1-ND (http://www.digikey.fr/scripts/DkSearch/dksus.dll?Detail&itemSeq=175391526&uq=635716863592438285) | CAP CER 10000PF 25V 10% X7R 0402 | 0.02200 | 0.44 | TRUE | 0.44
87 | 10 | 490-6186-1-ND (http://www.digikey.fr/scripts/DkSearch/dksus.dll?Detail&itemSeq=175391521&uq=635716863592438285) | CAP CER 10PF 50V 1% NP0 0402 | 0.04200 | 0.42 | TRUE | 0.42
88 | 25 | 490-7201-1-ND (http://www.digikey.fr/scripts/DkSearch/dksus.dll?Detail&itemSeq=175391524&uq=635716863592438285) | CAP CER 10UF 16V 20% X5R 0603 | 0.14000 | 3.5 | TRUE | 3.5
89 | 10 | 490-10516-1-ND (http://www.digikey.fr/scripts/DkSearch/dksus.dll?Detail&itemSeq=175391520&uq=635716863592438285) | CAP CER 10UF 10V 10% X7R 0805 | 0.12400 | 1.24 | TRUE | 1.24
90 | 1 | 490-6356-1-ND (http://www.digikey.fr/scripts/DkSearch/dksus.dll?Detail&itemSeq=175391522&uq=635716863592438285) | CAP CER 0.018UF 50V 10% X7R 0402 | 0.10000 | 0.1 | TRUE | 0.1
91 | 3 | 490-7303-1-ND (http://www.digikey.fr/scripts/DkSearch/dksus.dll?Detail&itemSeq=175391517&uq=635716863592594286) | CAP CER 22PF 100V 5% NP0 0402 | 0.10000 | 0.3 | TRUE | 0.3
92 | 5 | 490-5309-1-ND (http://www.digikey.fr/scripts/DkSearch/dksus.dll?Detail&itemSeq=175391523&uq=635716863592594286) | CAP CER 22UF 10V 10% X7R 1206 | 0.50000 | 2.5 | TRUE | 2.5
93 | 50 | P33.0LCT-ND (http://www.digikey.fr/scripts/DkSearch/dksus.dll?Detail&itemSeq=175391519&uq=635716863592594286) | RES SMD 33 OHM 1% 1/10W 0402 | 0.01460 | 0.73 | TRUE | 0.73
94 | 1 | 490-6345-1-ND (http://www.digikey.fr/scripts/DkSearch/dksus.dll?Detail&itemSeq=175391518&uq=635716863592594286) | CAP CER 0.033UF 25V 10% X7R 0402 | 0.10000 | 0.1 | TRUE | 0.1
95 | 1 | 490-10702-1-ND (http://www.digikey.fr/scripts/DkSearch/dksus.dll?Detail&itemSeq=175391515&uq=635716863592594286) | CAP CER 0.047UF 50V 10% X7R 0402 | 0.10000 | 0.1 | TRUE | 0.1
96 | 1 | 490-6241-1-ND (http://www.digikey.fr/scripts/DkSearch/dksus.dll?Detail&itemSeq=175391516&uq=635716863592594286) | CAP CER 47PF 50V 1% NP0 0402 | 0.10000 | 0.1 | TRUE | 0.1
97 | 10 | 490-7753-1-ND (http://www.digikey.fr/scripts/DkSearch/dksus.dll?Detail&itemSeq=175391512&uq=635716863592594286) | CAP CER 100PF 50V 1% NP0 0402 | 0.05300 | 0.53 | TRUE | 0.53
98 | 2 | ATCC-211B-010-107M-TCT-ND (http://www.digikey.fr/scripts/DkSearch/dksus.dll?Detail&itemSeq=175391514&uq=635716863592594286) | TANT CAP 100.0UF 10.0V 20% | 1.11000 | 2.22 | TRUE | 2.22
99 | 2 | 338-1805-1-ND (http://www.digikey.fr/scripts/DkSearch/dksus.dll?Detail&itemSeq=175391513&uq=635716863592594286) | CAP ALUM 100UF 20% 25V SMD | 0.41000 | 0.82 | TRUE | 0.82
100 | 2 | 490-8186-1-ND (http://www.digikey.fr/scripts/DkSearch/dksus.dll?Detail&itemSeq=175391509&uq=635716863592594286) | CAP CER 150PF 50V 2% NP0 0402 | 0.10000 | 0.2 | TRUE | 0.2
101 | 1 | 490-5418-1-ND (http://www.digikey.fr/scripts/DkSearch/dksus.dll?Detail&itemSeq=175391511&uq=635716863592594286) | CAP CER 0.22UF 16V 10% X7R 0402 | 0.13000 | 0.13 | TRUE | 0.13
102 | 3 | 490-10684-1-ND (http://www.digikey.fr/scripts/DkSearch/dksus.dll?Detail&itemSeq=175391508&uq=635716863592594286) | CAP CER 220PF 50V 1% NP0 0402 | 0.11000 | 0.11 | TRUE | 0.33
103 | 1 | 490-8262-1-ND (http://www.digikey.fr/scripts/DkSearch/dksus.dll?Detail&itemSeq=175391507&uq=635716863592594286) | CAP CER 680PF 100V 10% X7R 0402 | 0.10000 | 0.1 | TRUE | 0.1
104 | 1 | 490-3242-1-ND (http://www.digikey.fr/scripts/DkSearch/dksus.dll?Detail&itemSeq=175391505&uq=635716863592594286) | CAP CER 820PF 50V 5% NP0 0402 | 0.14000 | 0.14 | TRUE | 0.14
105 | 2 | 490-10758-1-ND (http://www.digikey.fr/scripts/DkSearch/dksus.dll?Detail&itemSeq=175391510&uq=635716863592594286) | CAP CER 22UF 25V 20% X7R 1210 | 1.14000 | 2.28 | TRUE | 2.28
106 | 10 | 490-10487-1-ND (http://www.digikey.fr/scripts/DkSearch/dksus.dll?Detail&itemSeq=175391506&uq=635716863592594286) | CAP CER 1UF 35V 10% X7R 0603 | 0.21700 | 2.17 | TRUE | 2.17
107 | 5 | 160-1140-ND (http://www.digikey.fr/scripts/DkSearch/dksus.dll?Detail&itemSeq=175391504&uq=635716863592594286) | LED 3MM HI-EFF RED TRANSPARENT | 0.32000 | 1.6 | TRUE | 1.6
108 | 1 | NHD-C12832A1Z-NSW-BBW-3V3-ND (http://www.digikey.fr/scripts/DkSearch/dksus.dll?Detail&itemSeq=175391503&uq=635716863592594286) | LCD COG GRAPHIC 128X32 | 10.78000 | 10.78 | TRUE | 10.78
109 | 2 | 609-1550-ND (http://www.digikey.fr/scripts/DkSearch/dksus.dll?Detail&itemSeq=175391502&uq=635716863592594286) | CONN RCPT 20POS DL .050 VERT SMD | 3.00000 | 6 | TRUE | 6
110 | 1 | 679-2608-ND (http://www.digikey.fr/scripts/DkSearch/dksus.dll?Detail&itemSeq=175391501&uq=635716863592594286) | CAP TACTILE ROUND BLACK | 6.48000 | 6.48 | TRUE | 6.48
111 | 1 | 679-2610-ND (http://www.digikey.fr/scripts/DkSearch/dksus.dll?Detail&itemSeq=175391498&uq=635716863592594286) | SEALING SUPPORT | 1.51000 | 1.51 | TRUE | 1.51
112 | 1 | 679-2609-ND (http://www.digikey.fr/scripts/DkSearch/dksus.dll?Detail&itemSeq=175391499&uq=635716863592594286) | SILICONE SEALING | 0.75000 | 0.75 | TRUE | 0.75
113 | 1 | 679-2612-ND (http://www.digikey.fr/scripts/DkSearch/dksus.dll?Detail&itemSeq=175391500&uq=635716863592594286) | SWITCH TACTILE SPST-NO 0.05A 24V | 2.48000 | 2.48 | TRUE | 2.48
114 | 4 | 679-2576-ND (http://www.digikey.fr/scripts/DkSearch/dksus.dll?Detail&itemSeq=175391497&uq=635716863592594286) | SWITCH TACTILE SPST-NO 0.05A 24V | 2.40000 | 9.6 | TRUE | 9.6
115 | 5 | P3C3503-ND (http://www.digikey.fr/scripts/DkSearch/dksus.dll?Detail&itemSeq=175391496&uq=635716863592594286) | POT 50K OHM 1/20W LINEAR | 0.88000 | 4.4 | TRUE | 4.4
 |  |  |  |  | 177.49 | TRUE | 182.4624
 |  |  | PCB DMFX1-1 v1.0 estimation |  | 5
 |  |  | PCB DMFX1-2 v1.0 estimation |  | 0.658
 |  |  | BoM estimation |  | 44.3725
 |  |  | Total |  | 50.0305
 |  |  | Digikey DMFX1 v1.0 BoM |  | 340.36
 |  |  | PCB circuits DMFX1-1 v1.0 |  | 335.63
 |  |  | PCB circuits DMFX1-2 v1.0 |  | 76.43
 |  |  | Total |  | 752.42
 |  |  | Total estimation 1k | 15 | 50.16133333
 |  |  | Digikey DMFX1 v1.0 BoM estimation 1k | 8 | 42.545
 |  |  | PCB circuits DMFX1-1 v1.0 estimation 1k | 20 | 16.7815
 |  |  | PCB circuits DMFX1-2 v1.0 estimation 1k | 20 | 3.8215
 |  |  | Total estimation 1k |  | 63.148
