DMFX-1/Hardware/DMFX-2/DMFX-2 v1.0.sch.pdf

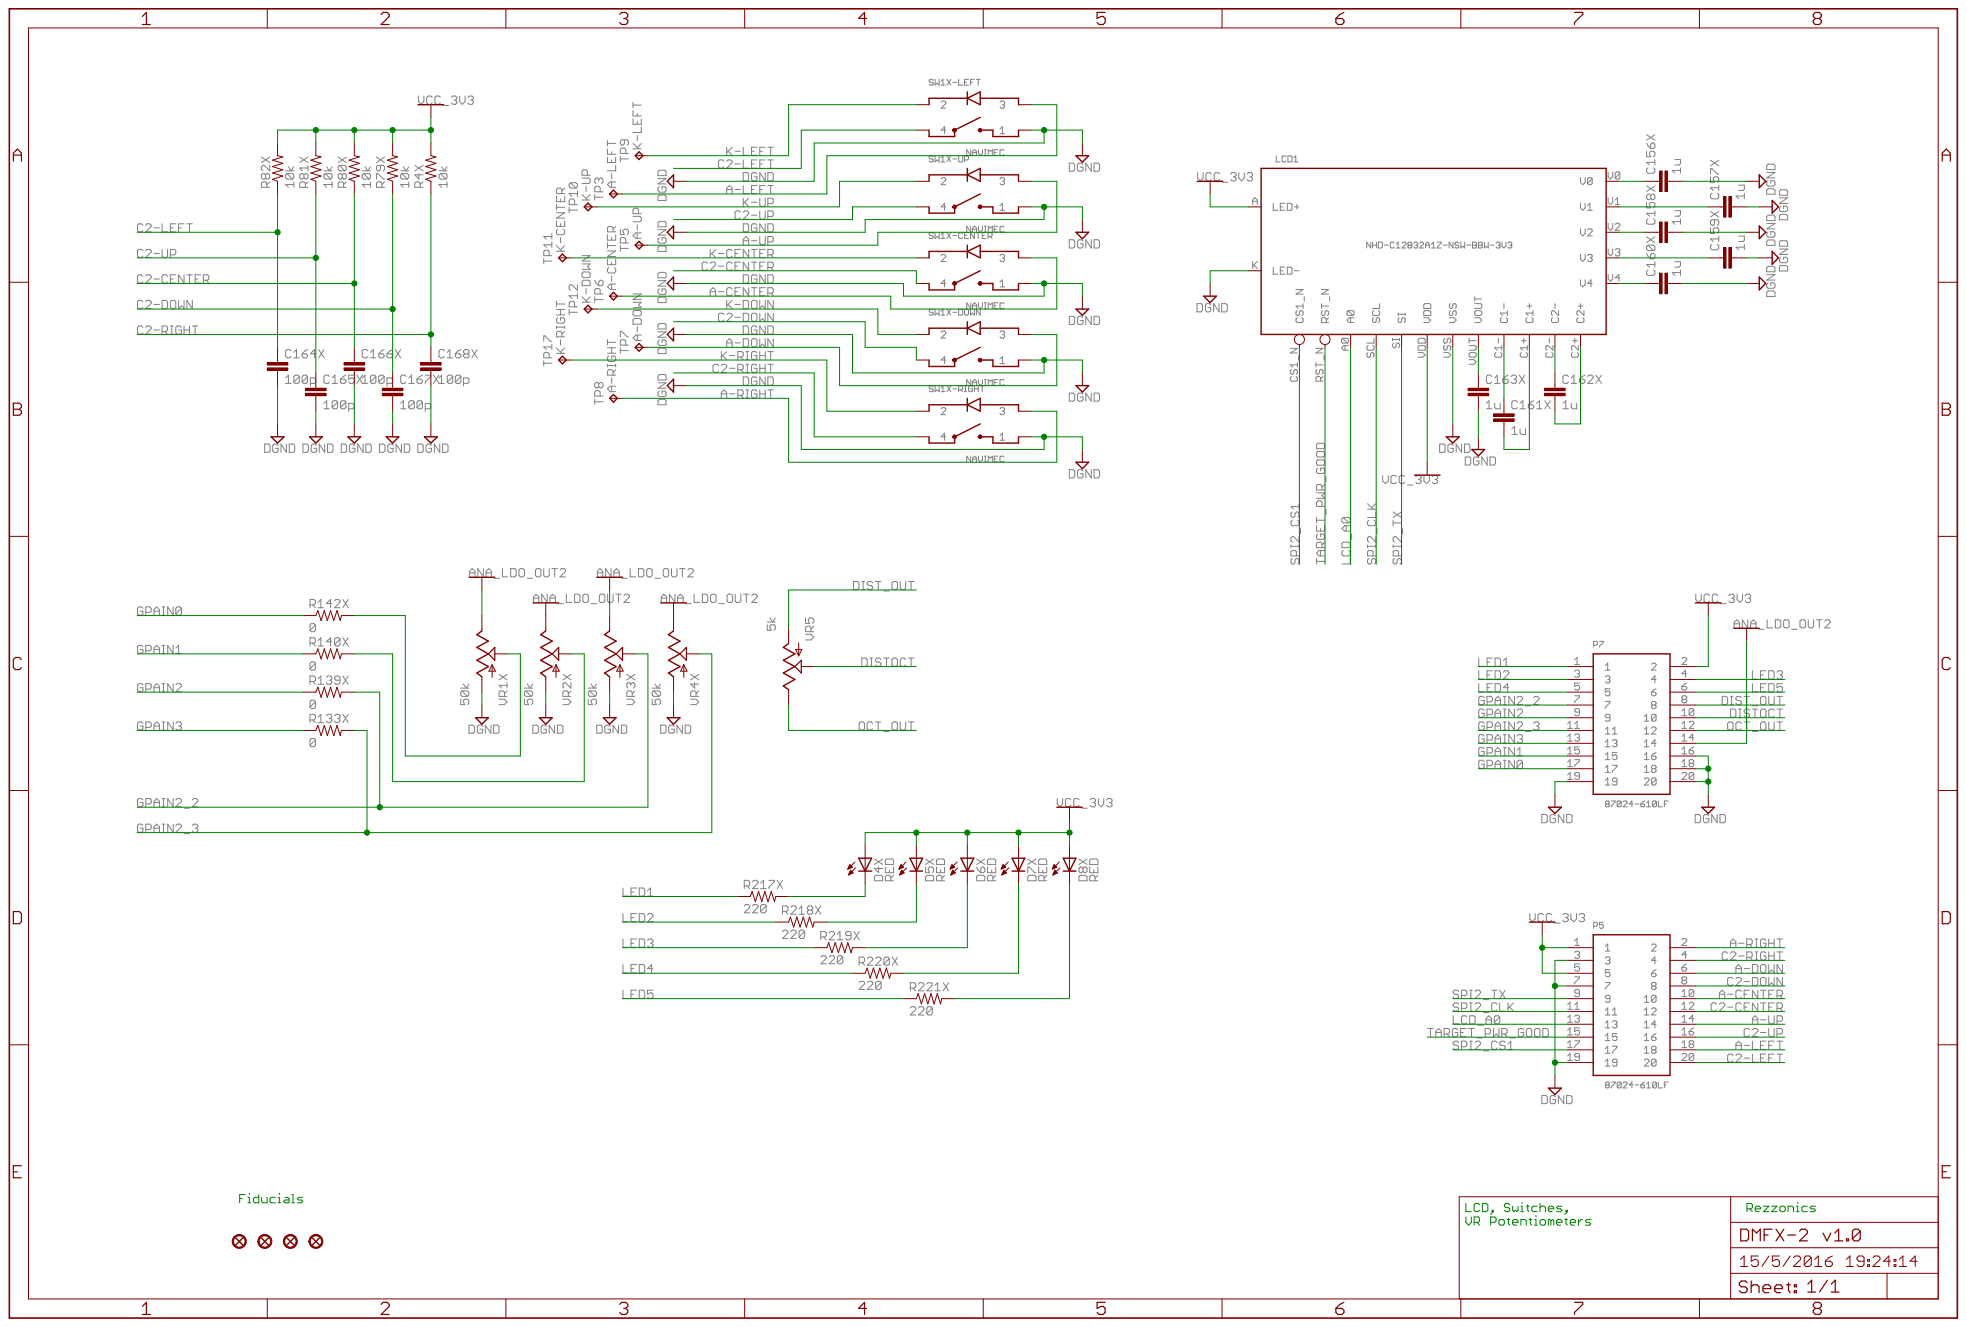
[picture p25: page 1]
