DMFX-1/Hardware/DMFX-2/DMFX-2 v1.0_assybot.pdf

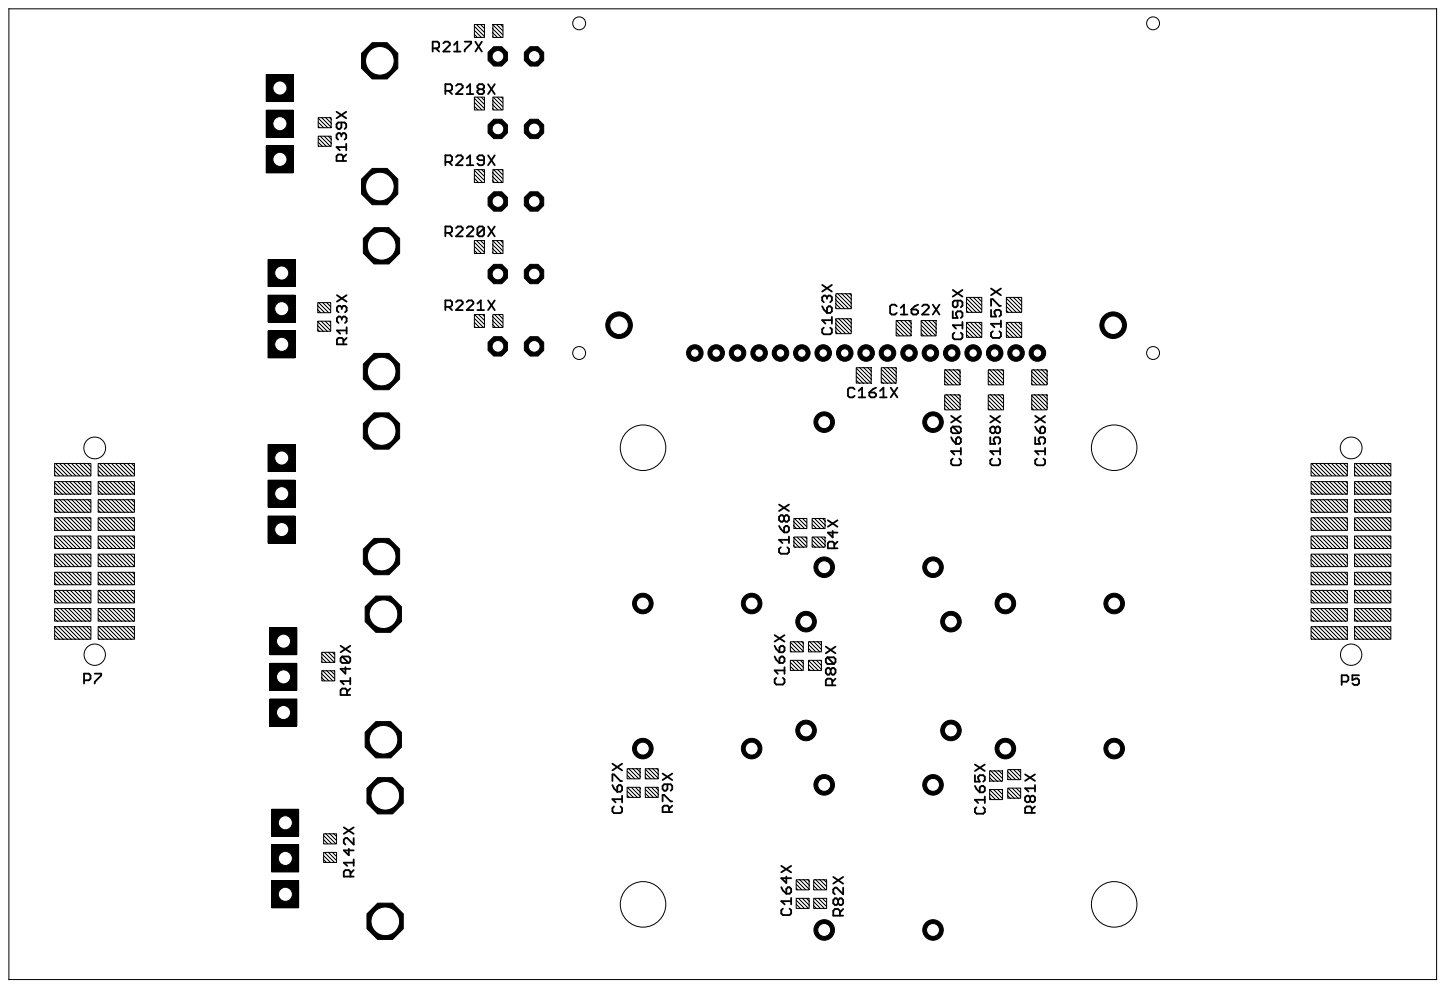
[picture p26: page 1]
