DMFX-1/Hardware/DMFX-2/DMFX-2 v1.0_assytop.pdf

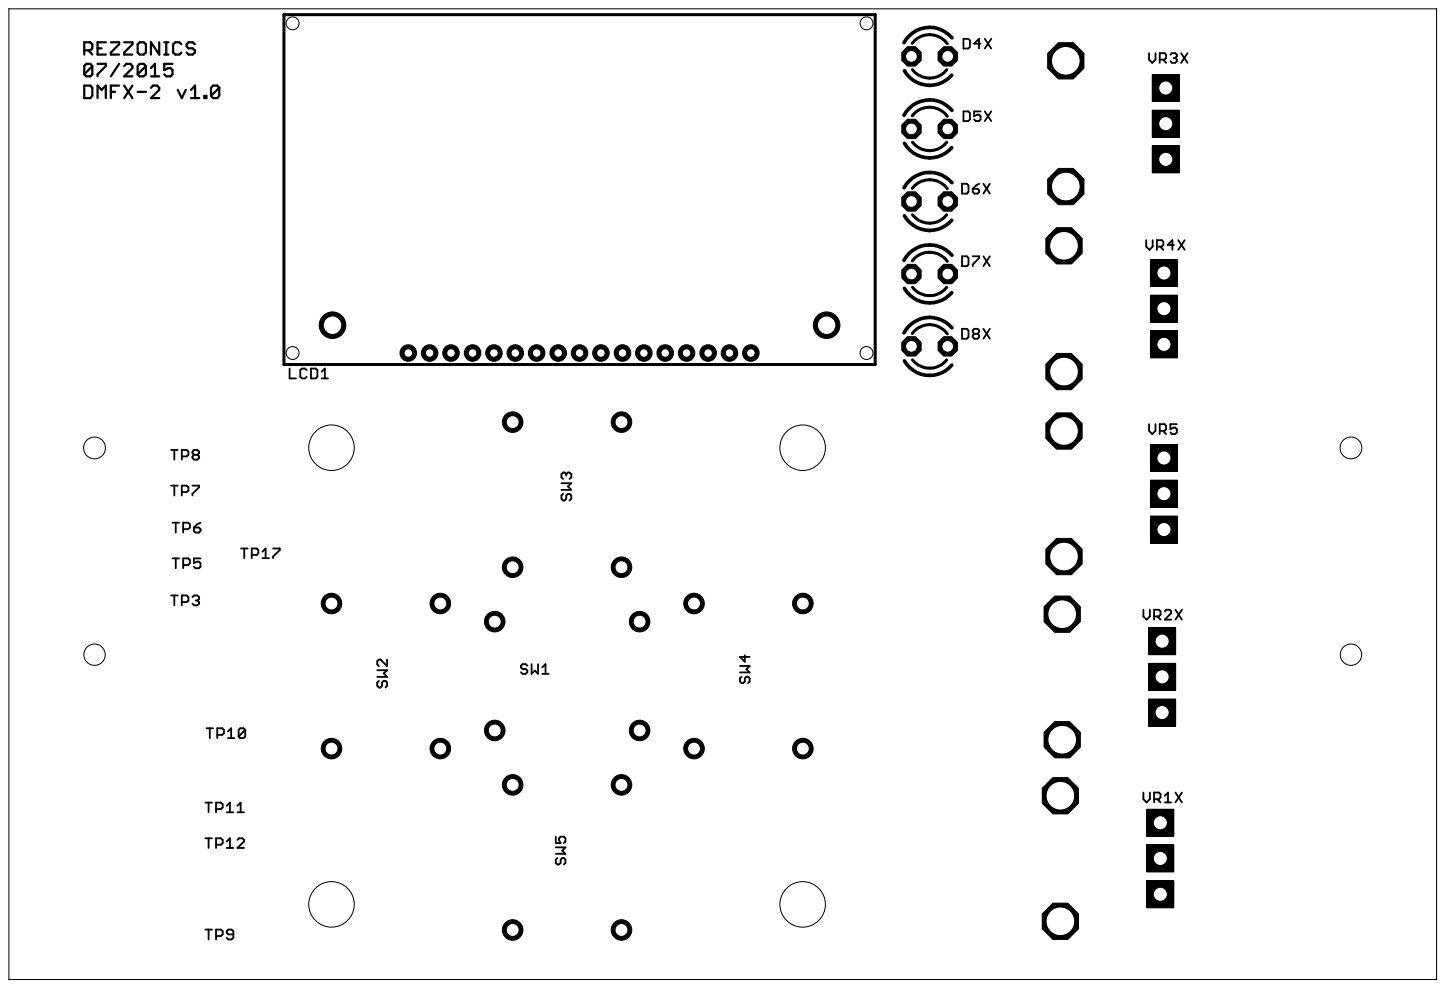
[picture p27: page 1]
