DMFX-1/Hardware/DMFX-1/DMFX-1 v1.0_assybot.pdf

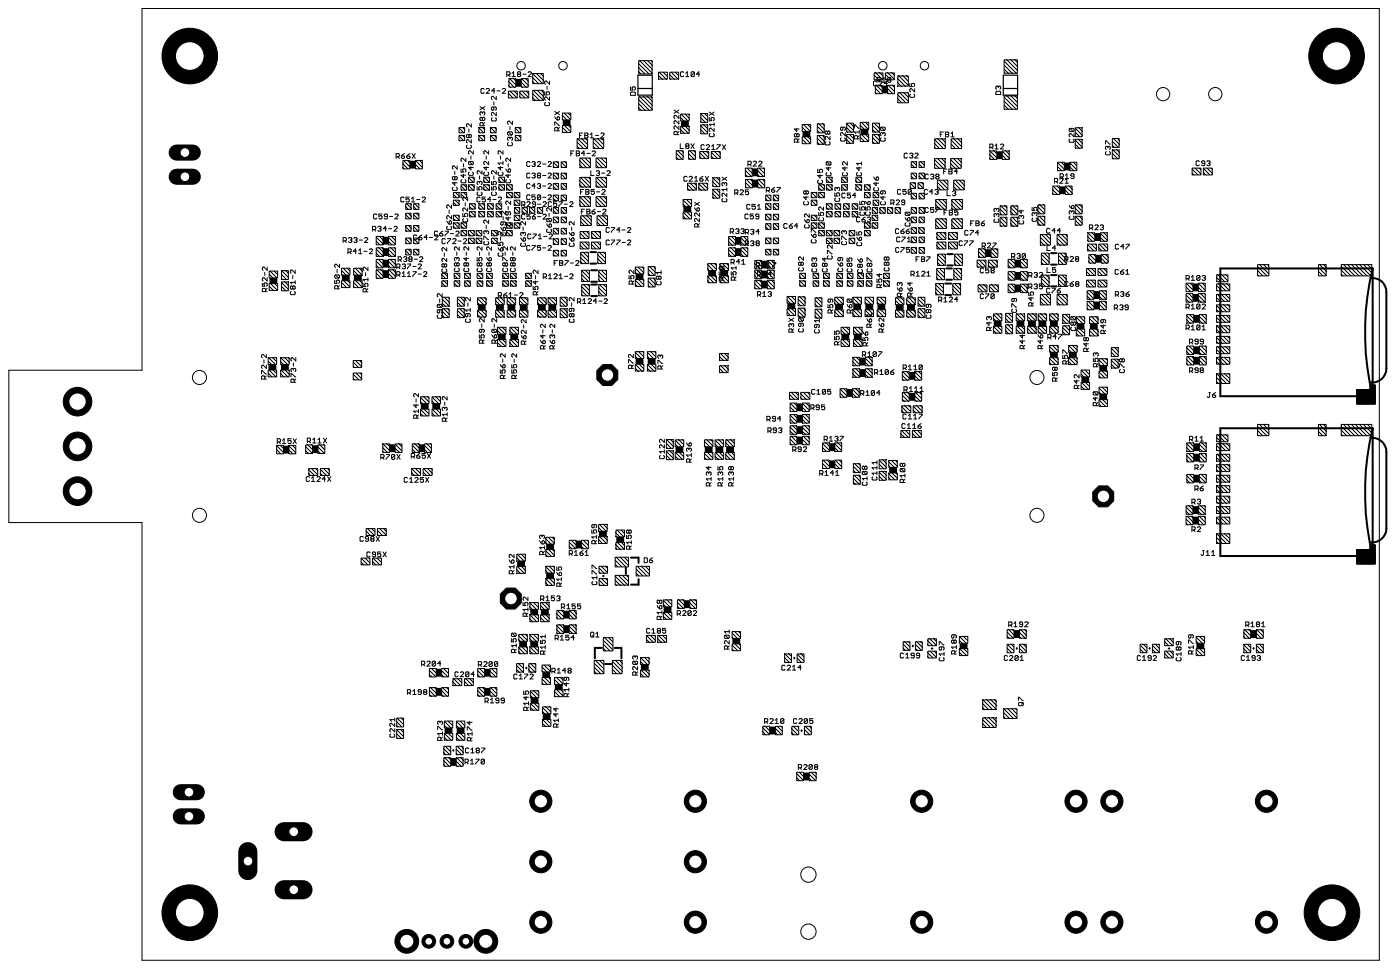
[picture p28: page 1]
