DMFX-1/Hardware/DMFX-1/DMFX-1 v1.0_assytop.pdf

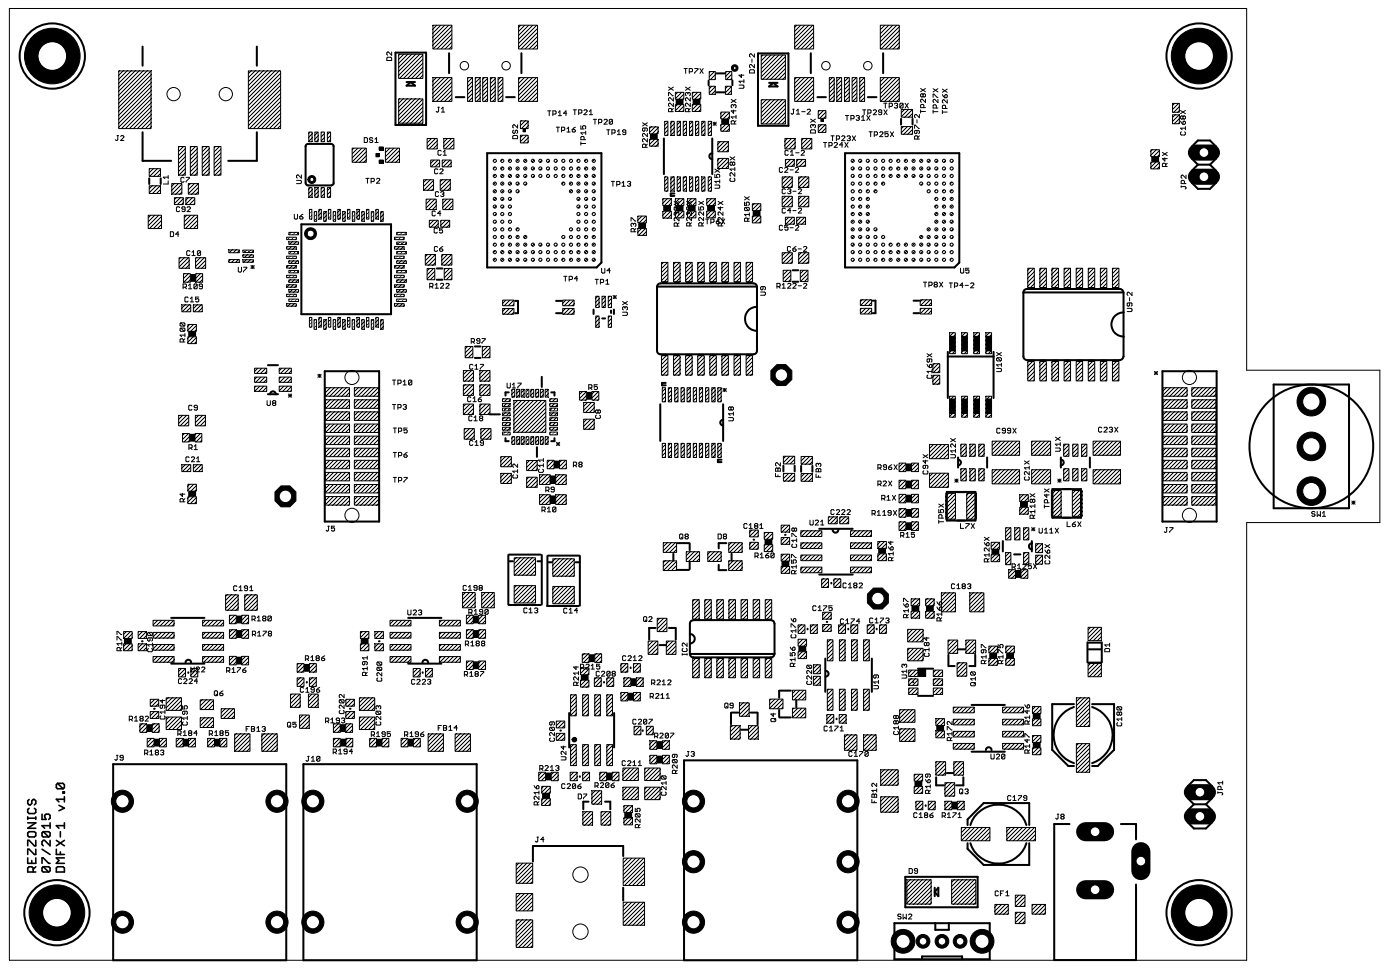
[picture p29: page 1]
