DMFX-1/Hardware/DMFX-2/DMFX-2 v1.0.brd

## EAGLE design DMFX-2/DMFX-2 v1.0.brd (2016-05-15)

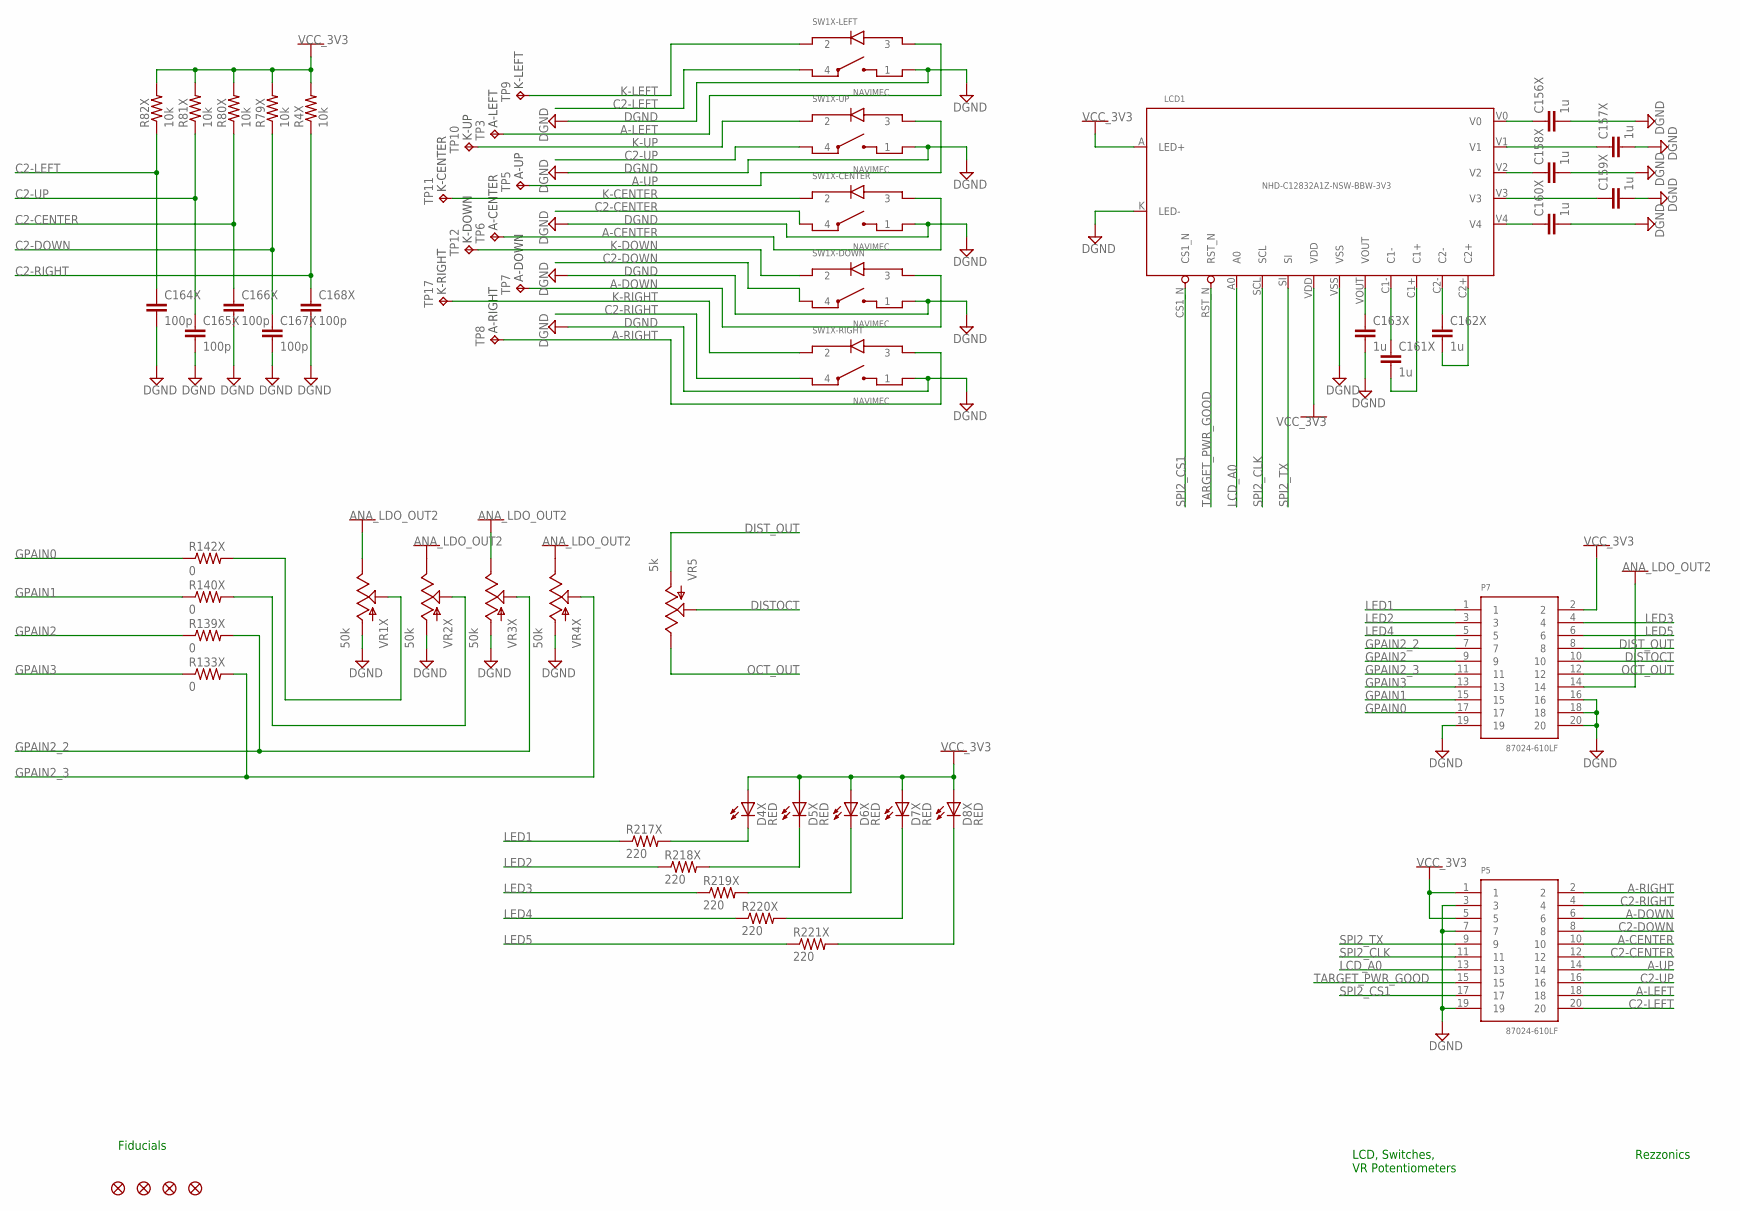
[picture p53: schematic DMFX-2 v1.0.sch]

Parts:
C156X, C157X, C158X, C159X, C160X, C161X, C162X, C163X: 1u; C0603K; MPN GRM188R7YA105KA12D
C164X, C165X, C166X, C167X, C168X: 100p; C0402; MPN GRM1555C1H101FA01J
D4X, D5X, D6X, D7X, D8X: RED; LED3MM; MPN LTL-4222N
JP2, JP4, JP5, JP9: FIDUCIAL1X2.5; FIDUCIAL-1X2.5; MPN *
LCD1: NHD-C12832A1Z-NSW-BBW-3V3; NHD-C12832A1Z; MPN NHD-C12832A1Z-NSW-BBW-3V3
P5, P7: 87024-610LF; 87022-110LF; MPN 87024-610LF
R4X, R79X, R80X, R81X, R82X: 10k; 0402-RES; MPN ERJ-2RKF1002X
R133X, R139X, R140X, R142X: 0; 0402-RES; MPN ERJ-2GE0R00X
R217X, R218X, R219X, R220X, R221X: 220; 0402-RES; MPN ERJ-2RKF2200X
SW1X: NAVIMEC; 1ZW0913611806; MPN 1ZW0913611806
TP3, TP5, TP6, TP7, TP8, TP9, TP10, TP11, TP12, TP17: TPTP12R; TP12R; MPN *
VR1X, VR2X, VR3X, VR4X: 50k; ALPS_POT; MPN EVU-F2AF30B54
VR5: 5k; ALPS_POT; MPN EVU-F2AF30B53

Connections:
A-CENTER: P5.10, SW1X.CENTER$3 (3), TP6.TP
A-DOWN: P5.6, SW1X.DOWN$3 (3), TP7.TP
A-LEFT: P5.18, SW1X.LEFT$3 (3), TP3.TP
A-RIGHT: P5.2, SW1X.RIGHT$3 (3), TP8.TP
A-UP: P5.14, SW1X.UP$3 (3), TP5.TP
ANA_LDO_OUT2: P7.14, VR1X.P$1 (E), VR2X.P$1 (E), VR3X.P$1 (E), VR4X.P$1 (E)
C2-CENTER: C166X.1, P5.12, R80X.1, SW1X.CENTER$4 (4)
C2-DOWN: C167X.1, P5.8, R79X.1, SW1X.DOWN$4 (4)
C2-LEFT: C164X.1, P5.20, R82X.1, SW1X.LEFT$4 (4)
C2-RIGHT: C168X.1, P5.4, R4X.1, SW1X.RIGHT$4 (4)
C2-UP: C165X.1, P5.16, R81X.1, SW1X.UP$4 (4)
DGND: C156X.2, C157X.2, C158X.2, C159X.2, C160X.2, C163X.2, C164X.2, C165X.2, C166X.2, C167X.2, C168X.2, LCD1.K (LED-), LCD1.VSS, P5.3, P5.7, P5.19, P7.16, P7.18, P7.19, P7.20, SW1X.CENTER$1 (1), SW1X.DOWN$1 (1), SW1X.LEFT$1 (1), SW1X.RIGHT$1 (1), SW1X.UP$1 (1), VR1X.P$3 (A), VR2X.P$3 (A), VR3X.P$3 (A), VR4X.P$3 (A)
DISTOCT: P7.10, VR5.P$2 (S)
DIST_OUT: P7.8, VR5.P$3 (A)
GPAIN0: P7.17, R142X.1
GPAIN1: P7.15, R140X.1
GPAIN2: P7.9, R139X.1
GPAIN2_0: R142X.2, VR1X.P$2 (S)
GPAIN2_1: R140X.2, VR2X.P$2 (S)
GPAIN2_2: P7.7, R139X.2, VR3X.P$2 (S)
GPAIN2_3: P7.11, R133X.2, VR4X.P$2 (S)
GPAIN3: P7.13, R133X.1
K-CENTER: SW1X.CENTER$2 (2), TP11.TP
K-DOWN: SW1X.DOWN$2 (2), TP12.TP
K-LEFT: SW1X.LEFT$2 (2), TP9.TP
K-RIGHT: SW1X.RIGHT$2 (2), TP17.TP
K-UP: SW1X.UP$2 (2), TP10.TP
LCD_A0: LCD1.A0, P5.13
LCD_C1+: C161X.2, LCD1.C1+
LCD_C1-: C161X.1, LCD1.C1-
LCD_C2+: C162X.2, LCD1.C2+
LCD_C2-: C162X.1, LCD1.C2-
LCD_V0: C156X.1, LCD1.V0
LCD_V1: C157X.1, LCD1.V1
LCD_V2: C158X.1, LCD1.V2
LCD_V3: C159X.1, LCD1.V3
LCD_V4: C160X.1, LCD1.V4
LCD_VOUT: C163X.1, LCD1.VOUT
LED1: P7.1, R217X.1
LED2: P7.3, R218X.1
LED3: P7.4, R219X.1
LED4: P7.5, R220X.1
LED5: P7.6, R221X.1
unnamed: D4X.K (C), R217X.2
unnamed: D5X.K (C), R218X.2
unnamed: D6X.K (C), R219X.2
unnamed: D7X.K (C), R220X.2
unnamed: D8X.K (C), R221X.2
OCT_OUT: P7.12, VR5.P$1 (E)
SPI2_CLK: LCD1.SCL, P5.11
SPI2_CS1: LCD1.CS1_N, P5.17
SPI2_TX: LCD1.SI, P5.9
TARGET_PWR_GOOD: LCD1.RST_N, P5.15
VCC_3V3: D4X.A, D5X.A, D6X.A, D7X.A, D8X.A, LCD1.A (LED+), LCD1.VDD, P5.1, P5.5, P7.2, R4X.2, R79X.2, R80X.2, R81X.2, R82X.2

Notes on the sheet:
Rezzonics
LCD, Switches, VR Potentiometers
Fiducials

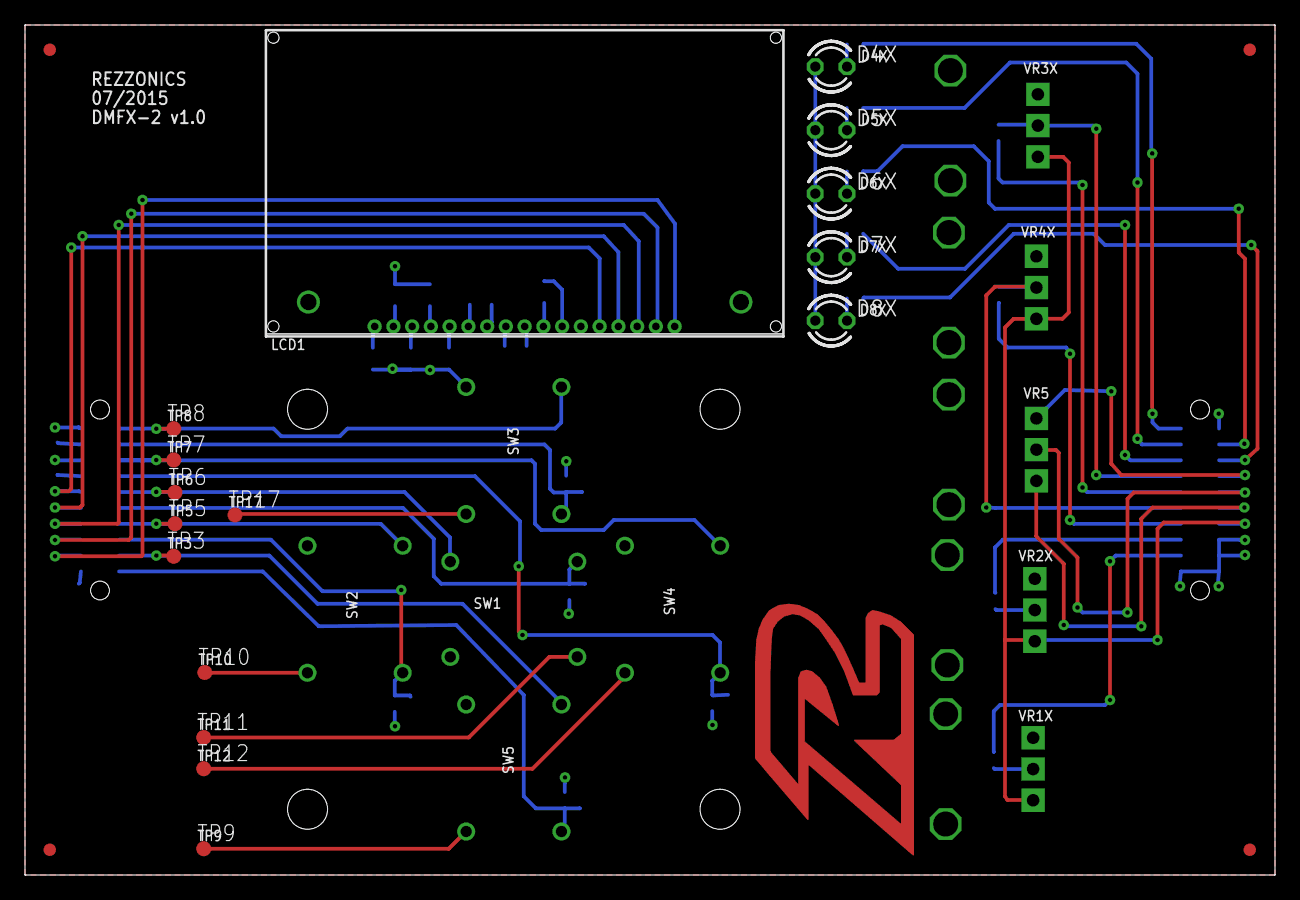
[picture p54: board DMFX-2 v1.0.brd from above]

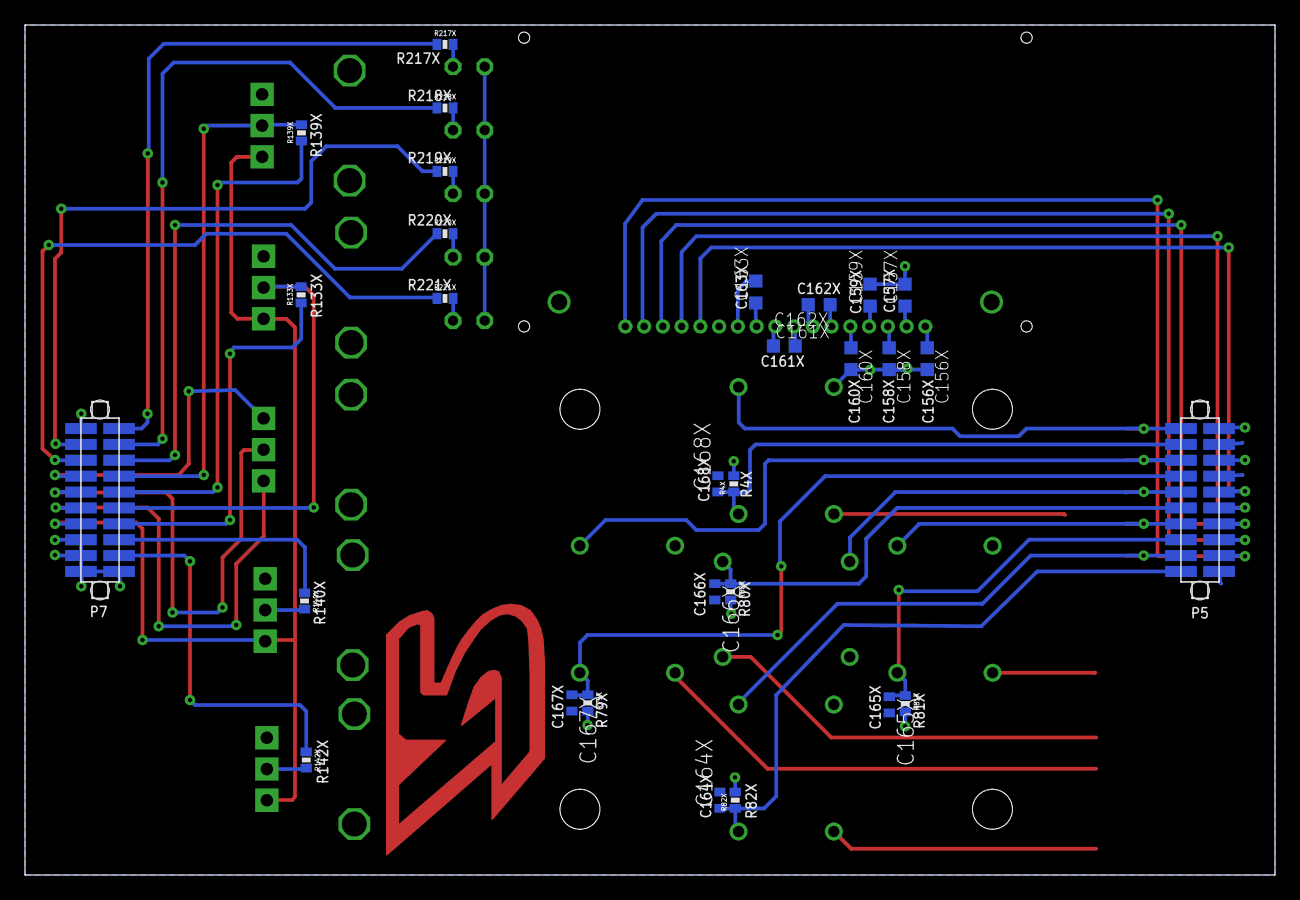
[picture p55: board DMFX-2 v1.0.brd from below]

Board: 2 copper layers, 100.0 x 68.0 mm, 56 parts (29 on the bottom side), 54 nets.

Other parts of the board:
U$1: REZZLOGO
