DMFX-1/Hardware/DMFX-1/DMFX-1 v1.2.brd

## EAGLE design DMFX-1/DMFX-1 v1.2.brd (2016-05-15)

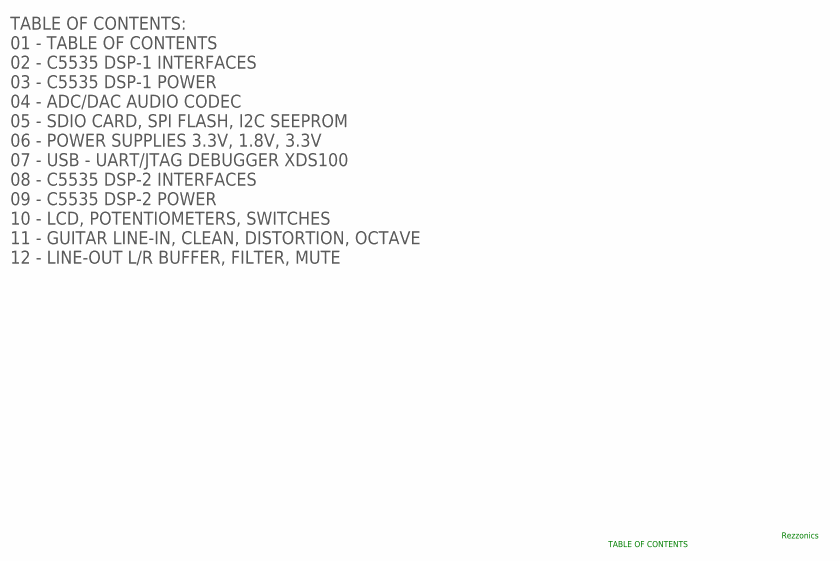
[picture p56: schematic DMFX-1 v1.2.sch, sheet 1]

Notes on the sheet:
TABLE OF CONTENTS: 01 - TABLE OF CONTENTS 02 - C5535 DSP-1 INTERFACES 03 - C5535 DSP-1 POWER 04 - ADC/DAC AUDIO CODEC 05 - SDIO CARD, SPI FLASH, I2C SEEPROM 06 - POWER SUPPLIES 3.3V, 1.8V, 3.3V 07 - USB - UART/JTAG DEBUGGER XDS100 08 - C5535 DSP-2 INTERFACES 09 - C5535 DSP-2 POWER 10 - LCD, POTENTI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
Rezzonics
TABLE OF CONTENTS

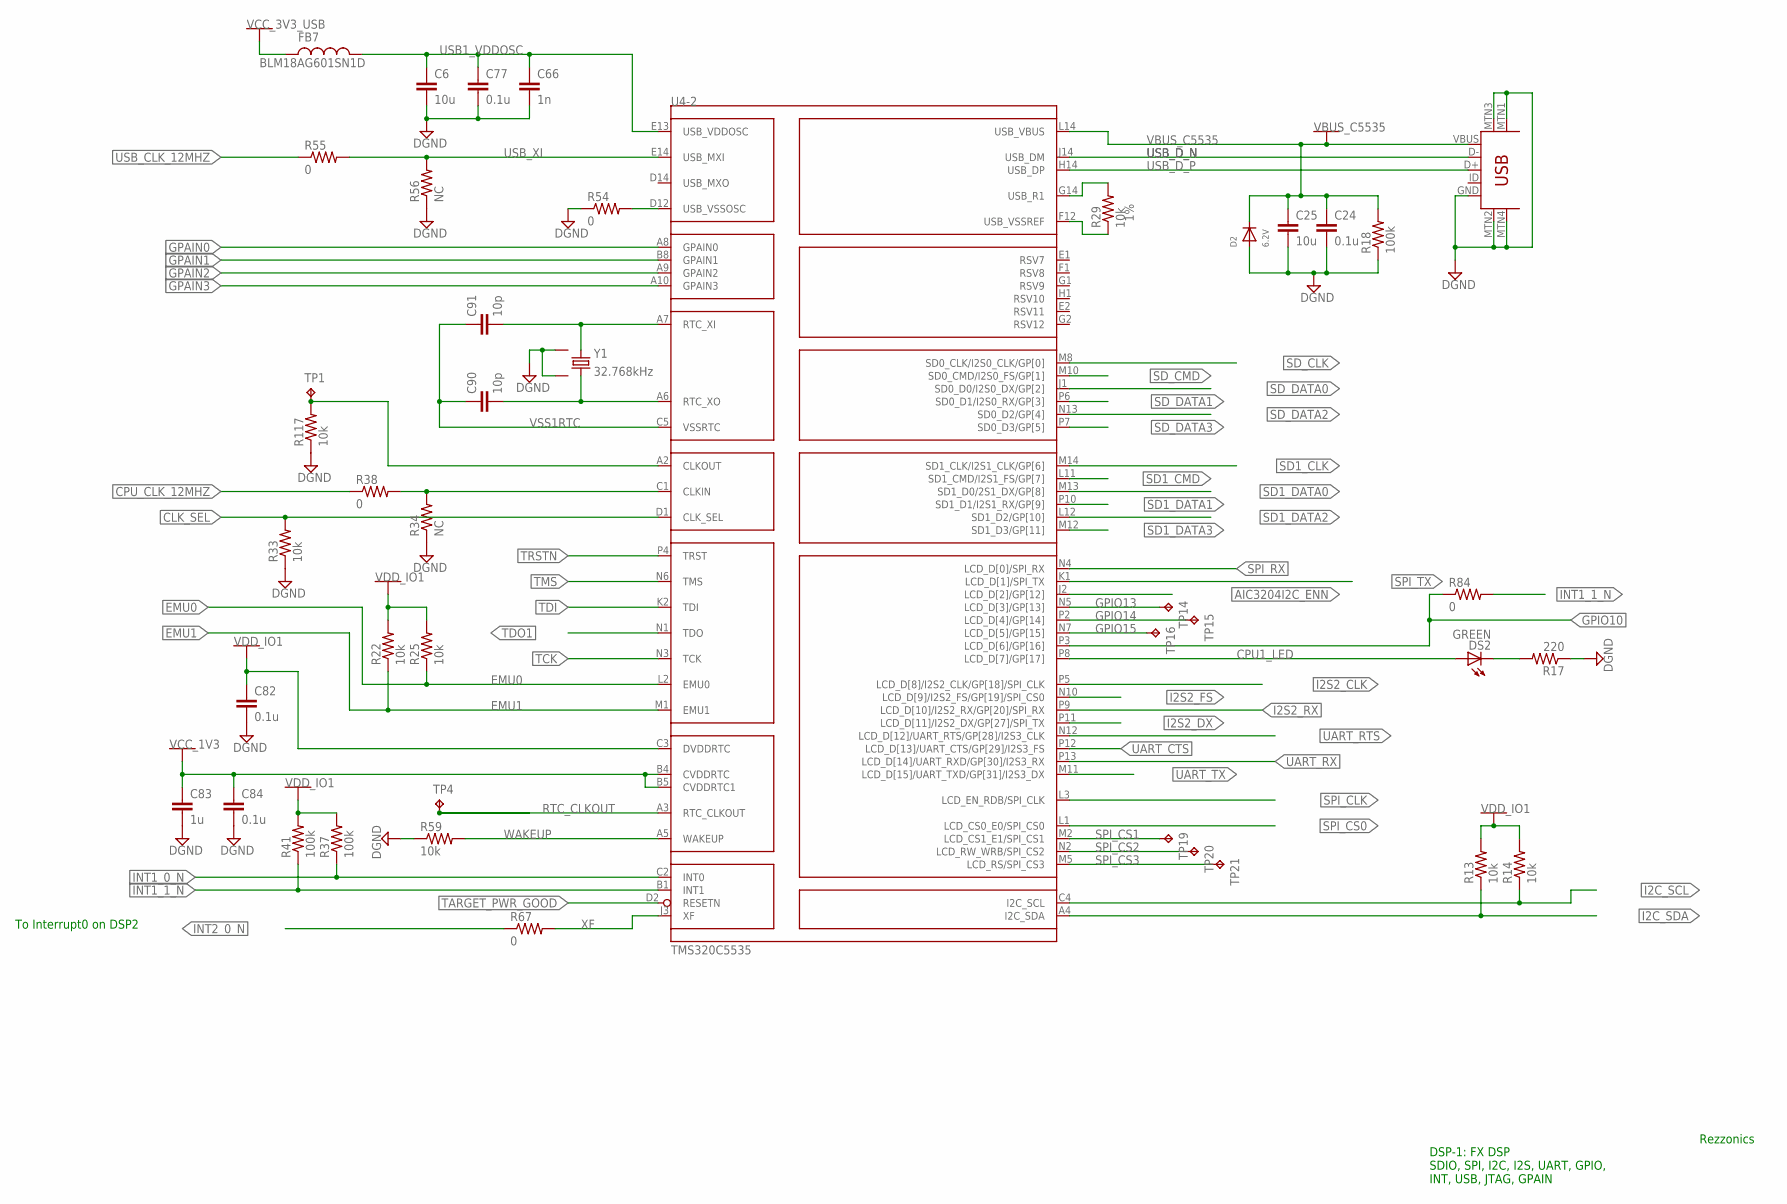
[picture p57: schematic DMFX-1 v1.2.sch, sheet 2]

Parts:
C6, C25: 10u; C0603K; MPN GRM188R61C106MA73D
C24, C77: 0.1u; C0402K; MPN GRM155R71C104JA88D
C66: 1n; 0402; MPN GRM155R71H102JA01J
C82, C84: 0.1u; 0402; MPN GRM155R71C104JA88D
C83: 1u; 0402; MPN GRM155R70J105KA12D
C90, C91: 10p; C0402K; MPN GRM1555C1H100FA01D
D2: 6.2V; SMADIODE; MPN 1SMA5920BT3G
DS2: GREEN; CHIPLED_0603; MPN LTST-C190KGKT
FB7: BLM18AG601SN1D; 0805; MPN BLM21AG151SN1D
J1: USB-MINIB-5PIN; USB-MINIB; MPN 10033526-N3212LF
R13, R14, R22, R25, R33, R59, R117: 10k; 0402-RES; MPN ERJ-2RKF1002X
R17: 220; 0402-RES; MPN ERJ-2RKF2200X
R18, R37, R41: 100k; 0402-RES; MPN ERJ-2RKF1003X
R29: 10k; 0402; TOLERANCE 1%; MPN ERJ-2RKF1002X
R34: NC; 0402; MPN *
R38, R54, R67: 0; 0402; MPN ERJ-2GE0R00X
R55, R84: 0; 0402-RES; MPN ERJ-2GE0R00X
R56: NC; 0402-RES; MPN *
TP1, TP4, TP14, TP15, TP16, TP19, TP20, TP21: TPTP06R; TP06R; MPN *
U4: TMS320C5535; PBGA144; MPN TMS320C5535AZHH10
Y1: 32.768kHz; CRYSTAL-32KHZ-SMD_EPSON_MC146; MPN SSPT7F-12.5PF20-R

Connections:
AIC3204I2C_ENN: U4.J2 (LCD_D[2]/GP[12]); also elsewhere on the board
CLK_SEL: R33.2, U4.D1 (CLK_SEL)
CPU1_LED: DS2.A, U4.P8 (LCD_D[7]/GP[17])
CPU_CLK_12MHZ: R38.1; also elsewhere on the board
DGND: C6.2, C24.2, C25.2, C66.2, C77.2, C82.2, C83.2, C84.2, D2.A, J1.GND, J1.MTN1 (MTN2), J1.MTN2 (MTN3), J1.MTN3 (MTN1), J1.MTN4, R17.1, R18.1, R33.1, R34.1, R54.1, R56.1, R59.1, R117.1, Y1.NC1 (3), Y1.NC2 (4); also elsewhere on the board
EMU0: R25.1, U4.L2 (EMU0); also elsewhere on the board
EMU1: R22.1, U4.M1 (EMU1); also elsewhere on the board
GPAIN0: U4.A8 (GPAIN0); also elsewhere on the board
GPAIN1: U4.B8 (GPAIN1); also elsewhere on the board
GPAIN2: U4.A9 (GPAIN2); also elsewhere on the board
GPAIN3: U4.A10 (GPAIN3); also elsewhere on the board
GPIO10: R84.1, U4.P3 (LCD_D[6]/GP[16])
GPIO13: TP14.TP, U4.N5 (LCD_D[3]/GP[13])
GPIO14: TP15.TP, U4.P2 (LCD_D[4]/GP[14])
GPIO15: TP16.TP, U4.N7 (LCD_D[5]/GP[15])
I2C_SCL: R14.1, U4.C4 (I2C_SCL); also elsewhere on the board
I2C_SDA: R13.1, U4.A4 (I2C_SDA); also elsewhere on the board
I2S2_CLK: U4.P5 (LCD_D[8]/I2S2_CLK/GP[18]/SPI_CLK); also elsewhere on the board
I2S2_DX: U4.P11 (LCD_D[11]/I2S2_DX/GP[27]/SPI_TX); also elsewhere on the board
I2S2_FS: U4.N10 (LCD_D[9]/I2S2_FS/GP[19]/SPI_CS0); also elsewhere on the board
I2S2_RX: U4.P9 (LCD_D[10]/I2S2_RX/GP[20]/SPI_RX); also elsewhere on the board
INT1_0_N: R37.1, U4.C2 (INT0); also elsewhere on the board
INT1_1_N: R41.1, R84.2, U4.B1 (INT1)
INT2_0_N: R67.1; also elsewhere on the board
unnamed: C91.2, U4.A7 (RTC_XI), Y1.P$2 (2)
unnamed: C90.2, U4.A6 (RTC_XO), Y1.P$1 (1)
unnamed: R117.2, TP1.TP, U4.A2 (CLKOUT)
unnamed: R34.2, R38.2, U4.C1 (CLKIN)
unnamed: DS2.C, R17.2
unnamed: R29.2, U4.G14 (USB_R1)
RTC_CLKOUT: TP4.TP, U4.A3 (RTC_CLKOUT)
SD1_CLK: U4.M14 (SD1_CLK/I2S1_CLK/GP[6]); also elsewhere on the board
SD1_CMD: U4.L11 (SD1_CMD/I2S1_FS/GP[7]); also elsewhere on the board
SD1_DATA0: U4.M13 (SD1_D0/2S1_DX/GP[8]); also elsewhere on the board
SD1_DATA1: U4.P10 (SD1_D1/I2S1_RX/GP[9]); also elsewhere on the board
SD1_DATA2: U4.L12 (SD1_D2/GP[10]); also elsewhere on the board
SD1_DATA3: U4.M12 (SD1_D3/GP[11]); also elsewhere on the board
SD_CLK: U4.M8 (SD0_CLK/I2S0_CLK/GP[0]); also elsewhere on the board
SD_CMD: U4.M10 (SD0_CMD/I2S0_FS/GP[1]); also elsewhere on the board
SD_DATA0: U4.J1 (SD0_D0/I2S0_DX/GP[2]); also elsewhere on the board
SD_DATA1: U4.P6 (SD0_D1/I2S0_RX/GP[3]); also elsewhere on the board
SD_DATA2: U4.N13 (SD0_D2/GP[4]); also elsewhere on the board
SD_DATA3: U4.P7 (SD0_D3/GP[5]); also elsewhere on the board
SPI_CLK: U4.L3 (LCD_EN_RDB/SPI_CLK); also elsewhere on the board
SPI_CS0: U4.L1 (LCD_CS0_E0/SPI_CS0); also elsewhere on the board
SPI_CS1: TP19.TP, U4.M2 (LCD_CS1_E1/SPI_CS1)
SPI_CS2: TP20.TP, U4.N2 (LCD_RW_WRB/SPI_CS2)
SPI_CS3: TP21.TP, U4.M5 (LCD_RS/SPI_CS3)
SPI_RX: U4.N4 (LCD_D[0]/SPI_RX); also elsewhere on the board
SPI_TX: U4.K1 (LCD_D[1]/SPI_TX); also elsewhere on the board
TARGET_PWR_GOOD: U4.D2 (RESETN); also elsewhere on the board
TCK: U4.N3 (TCK); also elsewhere on the board
TDI: U4.K2 (TDI); also elsewhere on the board
TDO1: U4.N1 (TDO); also elsewhere on the board
TMS: U4.N6 (TMS); also elsewhere on the board
TRSTN: U4.P4 (TRST); also elsewhere on the board
UART_CTS: U4.P12 (LCD_D[13]/UART_CTS/GP[29]/I2S3_FS); also elsewhere on the board
UART_RTS: U4.N12 (LCD_D[12]/UART_RTS/GP[28]/I2S3_CLK); also elsewhere on the board
UART_RX: U4.P13 (LCD_D[14]/UART_RXD/GP[30]/I2S3_RX); also elsewhere on the board
UART_TX: U4.M11 (LCD_D[15]/UART_TXD/GP[31]/I2S3_DX); also elsewhere on the board
USB1_VDDOSC: C6.1, C66.1, C77.1, FB7.2, U4.E13 (USB_VDDOSC)
USB1_VSSOSC: R54.2, U4.D12 (USB_VSSOSC)
USB1_VSSREF: R29.1, U4.F12 (USB_VSSREF)
USB_CLK_12MHZ: R55.1; also elsewhere on the board
USB_D_N: J1.D-, U4.J14 (USB_DM)
USB_D_P: J1.D+, U4.H14 (USB_DP)
USB_XI: R55.2, R56.2, U4.E14 (USB_MXI)
VBUS_C5535: C24.1, C25.1, D2.C, J1.VBUS, R18.2, U4.L14 (USB_VBUS); also elsewhere on the board
VCC_1V3: C83.1, C84.1, U4.B4 (CVDDRTC), U4.B5 (CVDDRTC1); also elsewhere on the board
VCC_3V3_USB: FB7.1; also elsewhere on the board
VDD_IO1: C82.1, R13.2, R14.2, R22.2, R25.2, R37.2, R41.2, U4.C3 (DVDDRTC); also elsewhere on the board
VSS1RTC: C90.1, C91.1, U4.C5 (VSSRTC)
WAKEUP: R59.2, U4.A5 (WAKEUP)
XF: R67.2, U4.J3 (XF)

Notes on the sheet:
To Interrupt0 on DSP2
Rezzonics
DSP-1: FX DSP SDIO, SPI, I2C, I2S, UART, GPIO, INT, USB, JTAG, GPAIN

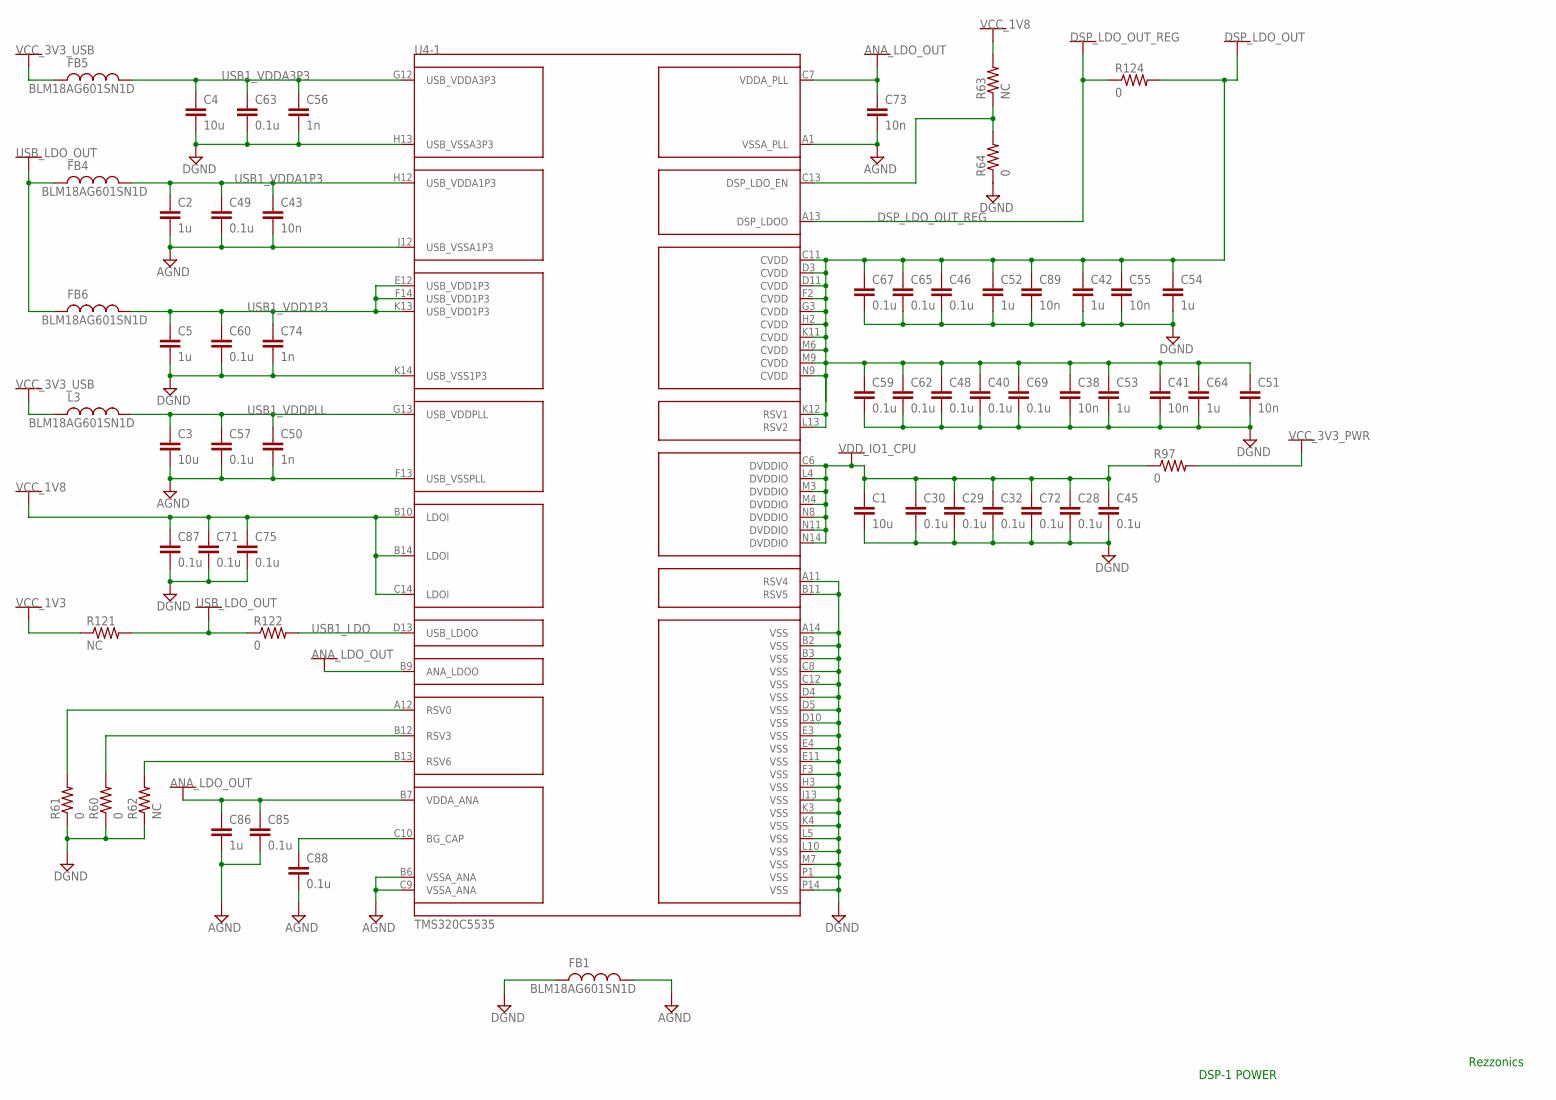
[picture p58: schematic DMFX-1 v1.2.sch, sheet 3]

Parts:
C1, C3, C4: 10u; C0603K; MPN GRM188R61C106MA73D
C2, C5: 1u; C0402K; MPN GRM155R70J105KA12D
C28, C29, C30: 0.1u; C0402K; MPN GRM155R71C104JA88D
C32, C40, C45, C46, C48, C49, C57, C59, C60, C62, C63, C65, C67, C69, C71, C72, C75, C85, C87, C88: 0.1u; 0402; MPN GRM155R71C104JA88D
C38, C41, C43, C51, C55, C73: 10n; 0402; MPN GRM155R71E103KA01D
C42, C52, C53, C54, C64, C86: 1u; 0402; MPN GRM155R70J105KA12D
C50, C56: 1n; 0402; MPN GRM155R71H102JA01J
C74: 1n; C0402K; MPN GRM155R71H102JA01J
C89: 10n; C0402K; MPN GRM155R71E103KA01D
FB1, FB4, FB5, FB6: BLM18AG601SN1D; 0603; MPN BLM18AG601SN1D
L3: BLM18AG601SN1D; 0603; MPN BLM18AG601SN1D
R60, R61, R64: 0; 0402-RES; MPN ERJ-2GE0R00X
R62, R63: NC; 0402-RES; MPN *
R97: 0; 0805; MPN ERJ-2GE0R00X
R121: NC; 0805; MPN *
R122, R124: 0; 0805; MPN ERJ-6GEY0R00V
U4: TMS320C5535; PBGA144; MPN TMS320C5535AZHH10

Connections:
AGND: C2.2, C3.2, C43.2, C49.2, C50.2, C57.2, C73.2, C85.2, C86.2, C88.2, FB1.2, U4.A1 (VSSA_PLL), U4.B6 (VSSA_ANA), U4.C9 (VSSA_ANA), U4.F13 (USB_VSSPLL), U4.J12 (USB_VSSA1P3); also elsewhere on the board
ANA_LDO_OUT: C73.1, C85.1, C86.1, U4.B7 (VDDA_ANA), U4.B9 (ANA_LDOO), U4.C7 (VDDA_PLL)
DGND: C1.2, C4.2, C5.2, C28.2, C29.2, C30.2, C32.2, C38.2, C40.2, C41.2, C42.2, C45.2, C46.2, C48.2, C51.2, C52.2, C53.2, C54.2, C55.2, C56.2, C59.2, C60.2, C62.2, C63.2, C64.2, C65.2, C67.2, C69.2, C71.2, C72.2, C74.2, C75.2, C87.2, C89.2, FB1.1, R60.1, R61.1, R62.1, R64.1, U4.A11 (RSV4), U4.A14 (VSS), U4.B2 (VSS), U4.B3 (VSS), U4.B11 (RSV5), U4.C8 (VSS), U4.C12 (VSS), U4.D4 (VSS), U4.D5 (VSS), U4.D10 (VSS), U4.E3 (VSS), U4.E4 (VSS), U4.E11 (VSS), U4.F3 (VSS), U4.H3 (VSS), U4.H13 (USB_VSSA3P3), U4.J13 (VSS), U4.K3 (VSS), U4.K4 (VSS), U4.K14 (USB_VSS1P3), U4.L5 (VSS), U4.L10 (VSS), U4.M7 (VSS), U4.P1 (VSS), U4.P14 (VSS); also elsewhere on the board
DSP_LDO_OUT: C38.1, C40.1, C41.1, C42.1, C46.1, C48.1, C51.1, C52.1, C53.1, C54.1, C55.1, C59.1, C62.1, C64.1, C65.1, C67.1, C69.1, C89.1, R124.2, U4.C11 (CVDD), U4.D3 (CVDD), U4.D11 (CVDD), U4.F2 (CVDD), U4.G3 (CVDD), U4.H2 (CVDD), U4.K11 (CVDD), U4.K12 (RSV1), U4.L13 (RSV2), U4.M6 (CVDD), U4.M9 (CVDD), U4.N9 (CVDD)
DSP_LDO_OUT_REG: R124.1, U4.A13 (DSP_LDOO)
unnamed: R63.1, R64.2, U4.C13 (DSP_LDO_EN)
unnamed: R61.2, U4.A12 (RSV0)
unnamed: R60.2, U4.B12 (RSV3)
unnamed: R62.2, U4.B13 (RSV6)
unnamed: C88.1, U4.C10 (BG_CAP)
USB1_LDO: R122.2, U4.D13 (USB_LDOO)
USB1_VDD1P3: C5.1, C60.1, C74.1, FB6.2, U4.E12 (USB_VDD1P3), U4.F14 (USB_VDD1P3), U4.K13 (USB_VDD1P3)
USB1_VDDA1P3: C2.1, C43.1, C49.1, FB4.2, U4.H12 (USB_VDDA1P3)
USB1_VDDA3P3: C4.1, C56.1, C63.1, FB5.2, U4.G12 (USB_VDDA3P3)
USB1_VDDPLL: C3.1, C50.1, C57.1, L3.2, U4.G13 (USB_VDDPLL)
USB_LDO_OUT: FB4.1, FB6.1, R121.2, R122.1
VCC_1V3: R121.1; also elsewhere on the board
VCC_1V8: C71.1, C75.1, C87.1, R63.2, U4.B10 (LDOI), U4.B14 (LDOI), U4.C14 (LDOI); also elsewhere on the board
VCC_3V3_PWR: R97.2; also elsewhere on the board
VCC_3V3_USB: FB5.1, L3.1; also elsewhere on the board
VDD_IO1_CPU: C1.1, C28.1, C29.1, C30.1, C32.1, C45.1, C72.1, R97.1, U4.C6 (DVDDIO), U4.L4 (DVDDIO), U4.M3 (DVDDIO), U4.M4 (DVDDIO), U4.N8 (DVDDIO), U4.N11 (DVDDIO), U4.N14 (DVDDIO)

Notes on the sheet:
DSP-1 POWER
Rezzonics

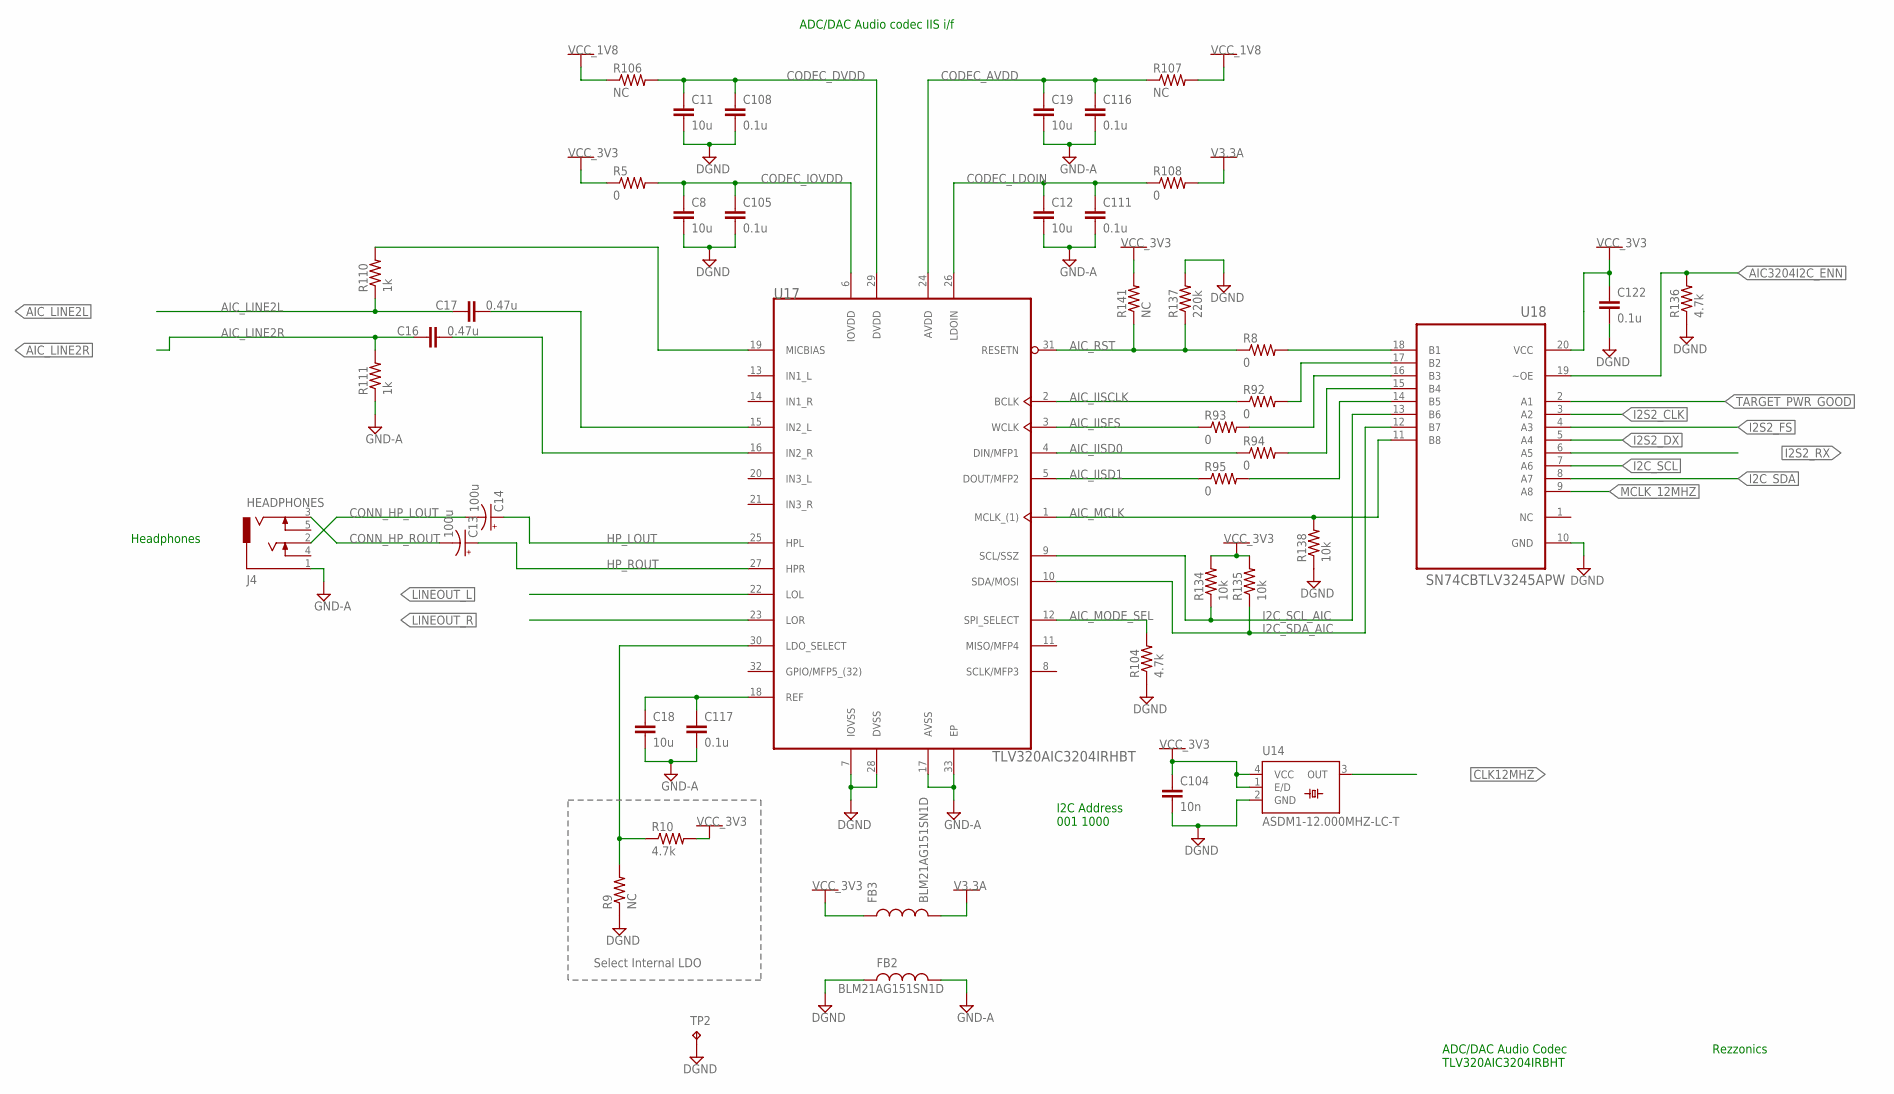
[picture p59: schematic DMFX-1 v1.2.sch, sheet 4]

Parts:
C8, C11, C12, C18, C19: 10u; C0603K; MPN GRM188R61C106MA73D
C13, C14: 100u; 1411; MPN ATCC-211B-010-107M-T
C16, C17: 0.47u; C0603K; MPN GRM188R71C474KA88D
C104: 10n; C0402K; MPN GRM155R71E103KA01D
C105, C108, C111, C116, C117, C122: 0.1u; C0402K; MPN GRM155R71C104JA88D
FB2, FB3: BLM21AG151SN1D; 0805; MPN BLM21AG151SN1D
J4: HEADPHONES; AUDIO-JACK-3.5MM-SMD; MPN SJ1-3515-SMT-TR
R5, R8, R92, R93, R94, R95, R108: 0; 0402-RES; MPN ERJ-2GE0R00X
R9: NC; 0603-RES; MPN *
R10: 4.7k; 0603-RES; MPN ERJ-3EKF4701V
R104, R136: 4.7k; 0402-RES; MPN ERJ-2RKF4701X
R106, R107, R141: NC; 0402-RES; MPN *
R110, R111: 1k; 0402-RES; MPN ERJ-2RKF1001X
R134, R135, R138: 10k; 0402-RES; MPN ERJ-2RKF1002X
R137: 220k; 0402-RES; MPN ERJ-2RKF2203X
TP2: TPTP06R; TP06R; MPN *
U14: ASDM1-12.000MHZ-LC-T; ASDM1; MPN ASDM1-12.000MHZ-LC-T
U17: TLV320AIC3204IRHBT; QFN50P500X500X100-33N; MPN TLV320AIC3204IRHBT
U18: SN74CBTLV3245APW; SOP65P640X120-20N; MPN SN74CBTLV3245APWR

Connections:
AIC3204I2C_ENN: R136.2, U18.19 (~OE); also elsewhere on the board
AIC_IISCLK: R92.1, U17.2 (BCLK)
AIC_IISD0: R94.1, U17.4 (DIN/MFP1)
AIC_IISD1: R95.1, U17.5 (DOUT/MFP2)
AIC_IISFS: R93.1, U17.3 (WCLK)
AIC_LINE2L: C17.1, R110.1; also elsewhere on the board
AIC_LINE2R: C16.1, R111.2; also elsewhere on the board
AIC_MCLK: R138.2, U17.1 (MCLK_(1)), U18.11 (B8)
AIC_MODE_SEL: R104.2, U17.12 (SPI_SELECT)
AIC_RST: R8.1, R137.1, R141.1, U17.31 (RESETN)
CLK12MHZ: U14.3 (OUT); also elsewhere on the board
CODEC_AVDD: C19.1, C116.1, R107.1, U17.24 (AVDD)
CODEC_DVDD: C11.1, C108.1, R106.2, U17.29 (DVDD)
CODEC_IOVDD: C8.1, C105.1, R5.2, U17.6 (IOVDD)
CODEC_LDOIN: C12.1, C111.1, R108.1, U17.26 (LDOIN)
CONN_HP_LOUT: C14.-, J4.2 (T)
CONN_HP_ROUT: C13.-, J4.3 (R)
DGND: C8.2, C11.2, C104.2, C105.2, C108.2, C122.2, FB2.1, R9.1, R104.1, R136.1, R137.2, R138.1, TP2.TP, U14.2 (GND), U17.7 (IOVSS), U17.28 (DVSS), U18.10 (GND); also elsewhere on the board
GND-A: C12.2, C18.2, C19.2, C111.2, C116.2, C117.2, FB2.2, J4.1 (S), R111.1, U17.17 (AVSS), U17.33 (EP); also elsewhere on the board
HP_LOUT: C14.+, U17.25 (HPL)
HP_ROUT: C13.+, U17.27 (HPR)
I2C_SCL: U18.7 (A6); also elsewhere on the board
I2C_SCL_AIC: R134.1, U17.9 (SCL/SSZ), U18.13 (B6)
I2C_SDA: U18.8 (A7); also elsewhere on the board
I2C_SDA_AIC: R135.1, U17.10 (SDA/MOSI), U18.12 (B7)
I2S2_CLK: U18.3 (A2); also elsewhere on the board
I2S2_DX: U18.5 (A4); also elsewhere on the board
I2S2_FS: U18.4 (A3); also elsewhere on the board
I2S2_RX: U18.6 (A5); also elsewhere on the board
LINEOUT_L: U17.22 (LOL); also elsewhere on the board
LINEOUT_R: U17.23 (LOR); also elsewhere on the board
MCLK_12MHZ: U18.9 (A8); also elsewhere on the board
unnamed: C17.2, U17.15 (IN2_L)
unnamed: C16.2, U17.16 (IN2_R)
unnamed: R9.2, R10.1, U17.30 (LDO_SELECT)
unnamed: C18.1, C117.1, U17.18 (REF)
unnamed: R8.2, U18.18 (B1)
unnamed: R92.2, U18.17 (B2)
unnamed: R93.2, U18.16 (B3)
unnamed: R94.2, U18.15 (B4)
unnamed: R95.2, U18.14 (B5)
unnamed: R110.2, U17.19 (MICBIAS)
TARGET_PWR_GOOD: U18.2 (A1); also elsewhere on the board
V3.3A: FB3.2, R108.2; also elsewhere on the board
VCC_1V8: R106.1, R107.2; also elsewhere on the board
VCC_3V3: C104.1, C122.1, FB3.1, R5.1, R10.2, R134.2, R135.2, R141.2, U14.1 (E/D), U14.4 (VCC), U18.20 (VCC); also elsewhere on the board

Notes on the sheet:
Select Internal LDO
Headphones
I2C Address 001 1000
ADC/DAC Audio codec IIS i/f
Rezzonics
ADC/DAC Audio Codec TLV320AIC3204IRBHT
