DMFX-1/Hardware/DMFX-1/DMFX-1 v1.2.brd

## EAGLE design DMFX-1/DMFX-1 v1.2.brd (continued)

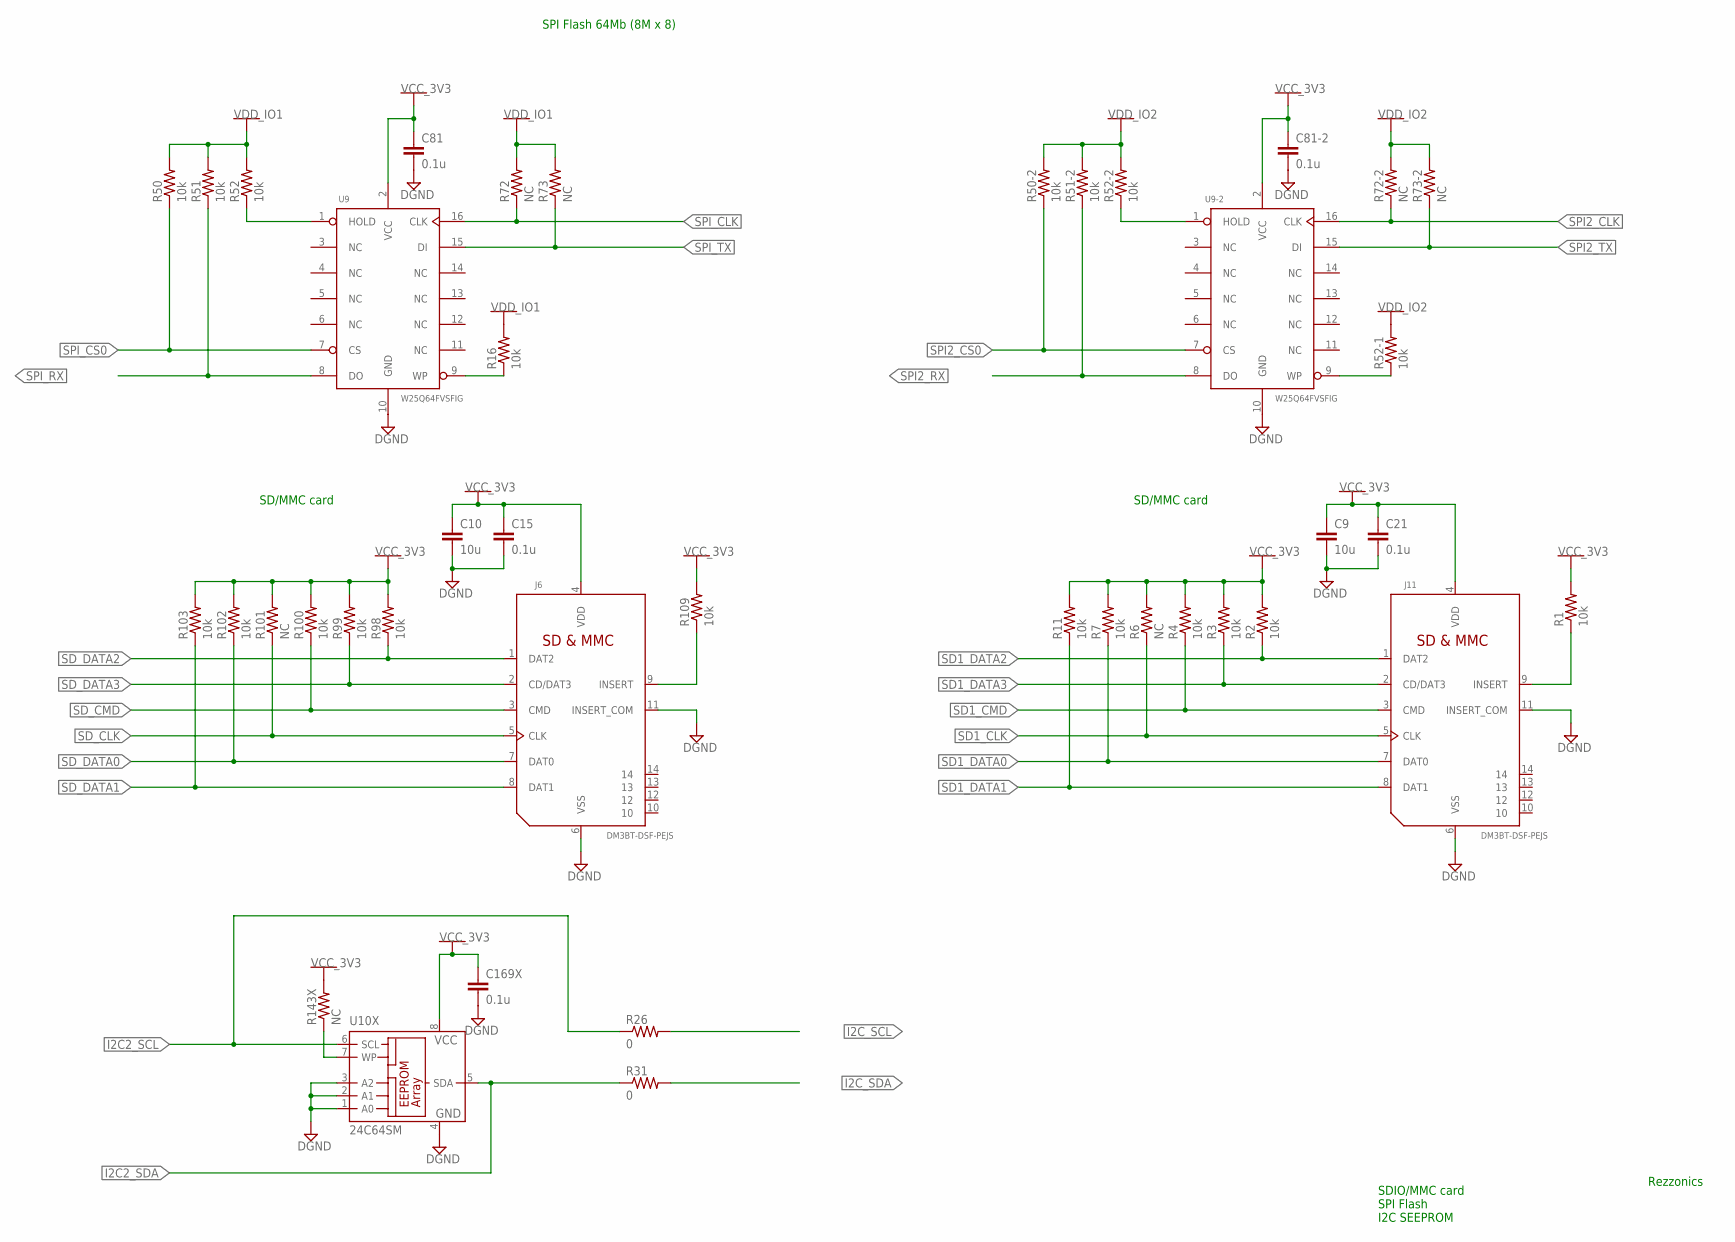
[picture p60: schematic DMFX-1 v1.2.sch, sheet 5]

Parts:
C9, C10: 10u; C0603K; MPN GRM188R61C106MA73D
C15, C21, C81, C81-2, C169X: 0.1u; C0402K; MPN GRM155R71C104JA88D
J6, J11: DM3BT-DSF-PEJS; MICROSD_RBT; MPN DM3BT-DSF-PEJS
R1, R2, R3, R4, R7, R11, R16, R50, R50-2, R51, R51-2, R52, R52-1, R52-2, R98, R99, R100, R102, R103, R109: 10k; 0402-RES; MPN ERJ-2RKF1002X
R6, R72, R72-2, R73, R73-2, R101: NC; 0402-RES; MPN *
R26, R31: 0; 0402-RES; MPN ERJ-2GE0R00X
R143X: NC; 0402-RES
U9, U9-2: W25Q64FVSFIG; SO16L; MPN W25Q64FVSFIG
U10X: 24C64SM; SO-08M; MPN AT24C64D-SSHM-T

Connections:
DGND: C9.2, C10.2, C15.2, C21.2, C81.2, C81-2.2, C169X.2, J6.6 (VSS), J6.11 (INSERT_COM), J11.6 (VSS), J11.11 (INSERT_COM), U9.10 (GND), U9-2.10 (GND), U10X.1 (A0), U10X.2 (A1), U10X.3 (A2), U10X.4 (GND); also elsewhere on the board
I2C2_SCL: R26.1, U10X.6 (SCL); also elsewhere on the board
I2C2_SDA: R31.1, U10X.5 (SDA); also elsewhere on the board
I2C_SCL: R26.2; also elsewhere on the board
I2C_SDA: R31.2; also elsewhere on the board
unnamed: J11.9 (INSERT), R1.1
unnamed: R16.1, U9.9 (WP)
unnamed: R52-1.1, U9-2.9 (WP)
unnamed: R52.1, U9.1 (HOLD)
unnamed: J6.9 (INSERT), R109.1
unnamed: R52-2.1, U9-2.1 (HOLD)
unnamed: R143X.1, U10X.7 (WP)
SD1_CLK: J11.5 (CLK), R6.1; also elsewhere on the board
SD1_CMD: J11.3 (CMD), R4.1; also elsewhere on the board
SD1_DATA0: J11.7 (DAT0), R7.1; also elsewhere on the board
SD1_DATA1: J11.8 (DAT1), R11.1; also elsewhere on the board
SD1_DATA2: J11.1 (DAT2), R2.1; also elsewhere on the board
SD1_DATA3: J11.2 (CD/DAT3), R3.1; also elsewhere on the board
SD_CLK: J6.5 (CLK), R101.1; also elsewhere on the board
SD_CMD: J6.3 (CMD), R100.1; also elsewhere on the board
SD_DATA0: J6.7 (DAT0), R102.1; also elsewhere on the board
SD_DATA1: J6.8 (DAT1), R103.1; also elsewhere on the board
SD_DATA2: J6.1 (DAT2), R98.1; also elsewhere on the board
SD_DATA3: J6.2 (CD/DAT3), R99.1; also elsewhere on the board
SPI2_CLK: R72-2.1, U9-2.16 (CLK); also elsewhere on the board
SPI2_CS0: R50-2.1, U9-2.7 (CS); also elsewhere on the board
SPI2_RX: R51-2.1, U9-2.8 (DO); also elsewhere on the board
SPI2_TX: R73-2.1, U9-2.15 (DI); also elsewhere on the board
SPI_CLK: R72.1, U9.16 (CLK); also elsewhere on the board
SPI_CS0: R50.1, U9.7 (CS); also elsewhere on the board
SPI_RX: R51.1, U9.8 (DO); also elsewhere on the board
SPI_TX: R73.1, U9.15 (DI); also elsewhere on the board
VCC_3V3: C9.1, C10.1, C15.1, C21.1, C81.1, C81-2.1, C169X.1, J6.4 (VDD), J11.4 (VDD), R1.2, R2.2, R3.2, R4.2, R6.2, R7.2, R11.2, R98.2, R99.2, R100.2, R101.2, R102.2, R103.2, R109.2, R143X.2, U9.2 (VCC), U9-2.2 (VCC), U10X.8 (VCC); also elsewhere on the board
VDD_IO1: R16.2, R50.2, R51.2, R52.2, R72.2, R73.2; also elsewhere on the board
VDD_IO2: R50-2.2, R51-2.2, R52-1.2, R52-2.2, R72-2.2, R73-2.2; also elsewhere on the board

Notes on the sheet:
SD/MMC card
SPI Flash 64Mb (8M x 8)
Rezzonics
SDIO/MMC card SPI Flash I2C SEEPROM

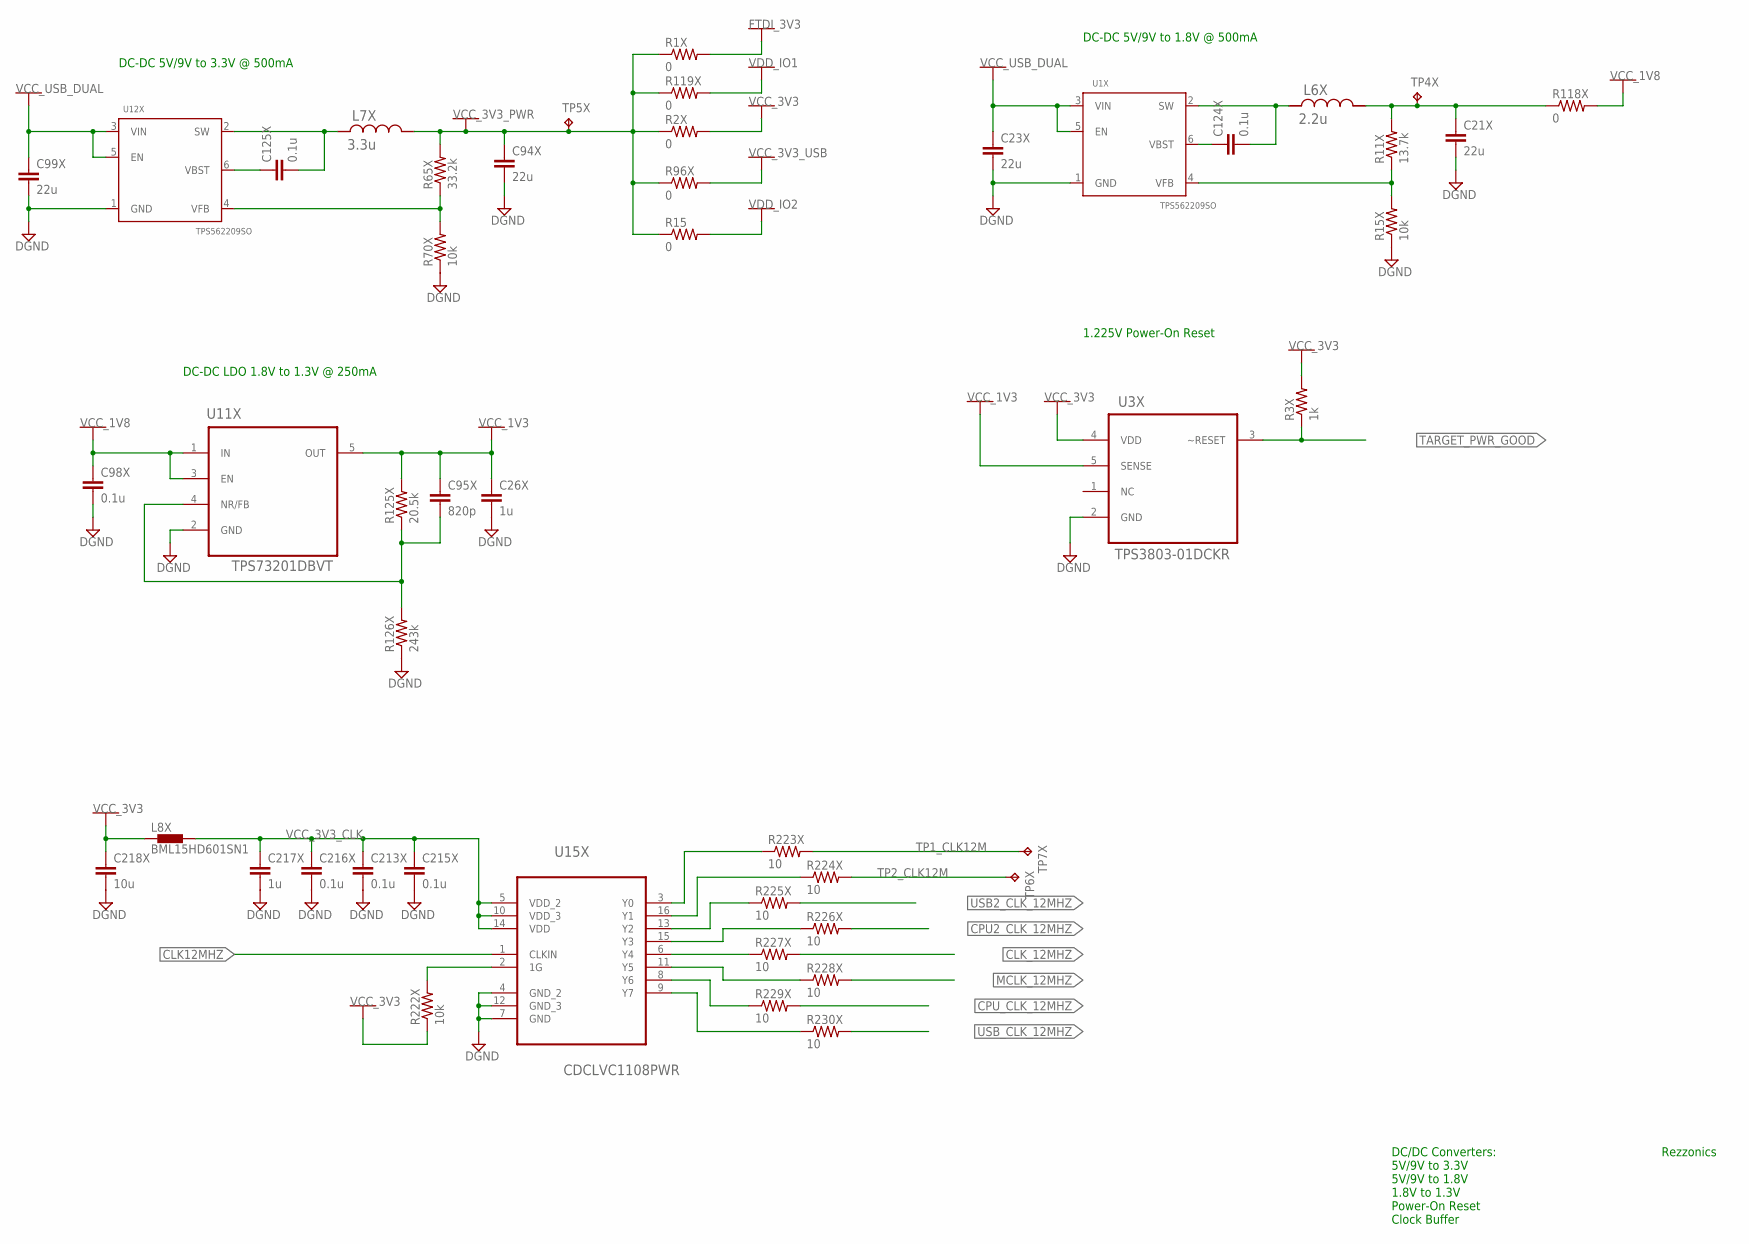
[picture p61: schematic DMFX-1 v1.2.sch, sheet 6]

Parts:
C21X, C94X: 22u; C1206K; MPN GRM31CR71A226KE15L
C23X, C99X: 22u; C1210K; MPN GRM32ER71E226ME15L
C26X, C217X: 1u; C0402K; MPN GRM155R70J105KA12D
C95X: 820p; C0402K; MPN GRM1555C1H821JA01D
C98X, C124X, C125X, C213X, C215X, C216X: 0.1u; C0402K; MPN GRM155R71C104JA88D
C218X: 10u; C0603K; MPN GRM188R61C106MA73D
L6X: 2.2u; SRN3015; MPN SRN3015-2R2M
L7X: 3.3u; SRN3015; MPN SRN3015-3R3M
L8X: BML15HD601SN1; 0402; MPN BLM15HD601SN1D
R1X, R2X, R15, R96X, R118X, R119X: 0; 0402-RES; MPN ERJ-2GE0R00X
R3X: 1k; 0402-RES; MPN ERJ-2RKF1001X
R11X: 13.7k; 0402-RES; MPN ERJ-2RKF1372X
R15X, R70X, R222X: 10k; 0402-RES; MPN ERJ-2RKF1002X
R65X: 33.2k; 0402-RES; MPN ERJ-2RKF3322X
R125X: 20.5k; 0402-RES; MPN ERJ-2RKF2052X
R126X: 243k; 0402-RES; MPN ERJ-2RKF2433X
R223X, R224X, R225X, R226X, R227X, R228X, R229X, R230X: 10; 0402-RES; MPN ERJ-2RKF10R0X
TP4X, TP5X, TP6X, TP7X: TPTP06R; TP06R; MPN *
U1X, U12X: TPS562209SO; SOT95P280X145-6N; MPN TPS562209DDCT
U3X: TPS3803-01DCKR; SOT65P210X110-5N; MPN TPS3803-01DCKR
U11X: TPS73201DBVT; SOT95P280X145-5N; MPN TPS73201DBVT
U15X: CDCLVC1108PWR; SOP65P640X120-16N; MPN CDCLVC1108PWR

Connections:
CLK12MHZ: U15X.1 (CLKIN); also elsewhere on the board
CLK_12MHZ: R227X.2; also elsewhere on the board
CPU2_CLK_12MHZ: R226X.2; also elsewhere on the board
CPU_CLK_12MHZ: R229X.2; also elsewhere on the board
DGND: C21X.2, C23X.2, C26X.2, C94X.2, C98X.2, C99X.2, C213X.2, C215X.2, C216X.2, C217X.2, C218X.2, R15X.1, R70X.1, R126X.1, U1X.1 (GND), U3X.2 (GND), U11X.2 (GND), U12X.1 (GND), U15X.4 (GND_2), U15X.7 (GND), U15X.12 (GND_3); also elsewhere on the board
FTDI_3V3: R1X.2; also elsewhere on the board
MCLK_12MHZ: R228X.2; also elsewhere on the board
unnamed: C95X.2, R125X.1, R126X.2, U11X.4 (NR/FB)
unnamed: C125X.1, U12X.6 (VBST)
unnamed: C125X.2, L7X.2, U12X.2 (SW)
unnamed: R65X.1, R70X.2, U12X.4 (VFB)
unnamed: C124X.1, U1X.6 (VBST)
unnamed: C124X.2, L6X.2, U1X.2 (SW)
unnamed: C21X.1, L6X.1, R11X.2, R118X.1, TP4X.TP
unnamed: R11X.1, R15X.2, U1X.4 (VFB)
unnamed: R223X.1, U15X.3 (Y0)
unnamed: R224X.1, U15X.16 (Y1)
unnamed: R225X.1, U15X.13 (Y2)
unnamed: R222X.2, U15X.2 (1G)
unnamed: R226X.1, U15X.15 (Y3)
unnamed: R227X.1, U15X.6 (Y4)
unnamed: R228X.1, U15X.11 (Y5)
unnamed: R229X.1, U15X.8 (Y6)
unnamed: R230X.1, U15X.9 (Y7)
TARGET_PWR_GOOD: R3X.1, U3X.3 (~RESET); also elsewhere on the board
TP1_CLK12M: R223X.2, TP7X.TP
TP2_CLK12M: R224X.2, TP6X.TP
USB2_CLK_12MHZ: R225X.2; also elsewhere on the board
USB_CLK_12MHZ: R230X.2; also elsewhere on the board
VCC_1V3: C26X.1, C95X.1, R125X.2, U3X.5 (SENSE), U11X.5 (OUT); also elsewhere on the board
VCC_1V8: C98X.1, R118X.2, U11X.1 (IN), U11X.3 (EN); also elsewhere on the board
VCC_3V3: C218X.1, L8X.1, R2X.2, R3X.2, R222X.1, U3X.4 (VDD); also elsewhere on the board
VCC_3V3_CLK: C213X.1, C215X.1, C216X.1, C217X.1, L8X.2, U15X.5 (VDD_2), U15X.10 (VDD_3), U15X.14 (VDD)
VCC_3V3_PWR: C94X.1, L7X.1, R1X.1, R2X.1, R15.1, R65X.2, R96X.1, R119X.1, TP5X.TP; also elsewhere on the board
VCC_3V3_USB: R96X.2; also elsewhere on the board
VCC_USB_DUAL: C23X.1, C99X.1, U1X.3 (VIN), U1X.5 (EN), U12X.3 (VIN), U12X.5 (EN); also elsewhere on the board
VDD_IO1: R119X.2; also elsewhere on the board
VDD_IO2: R15.2; also elsewhere on the board

Notes on the sheet:
DC-DC 5V/9V to 3.3V @ 500mA
DC-DC 5V/9V to 1.8V @ 500mA
1.225V Power-On Reset
DC-DC LDO 1.8V to 1.3V @ 250mA
Rezzonics
DC/DC Converters: 5V/9V to 3.3V 5V/9V to 1.8V 1.8V to 1.3V Power-On Reset Clock Buffer

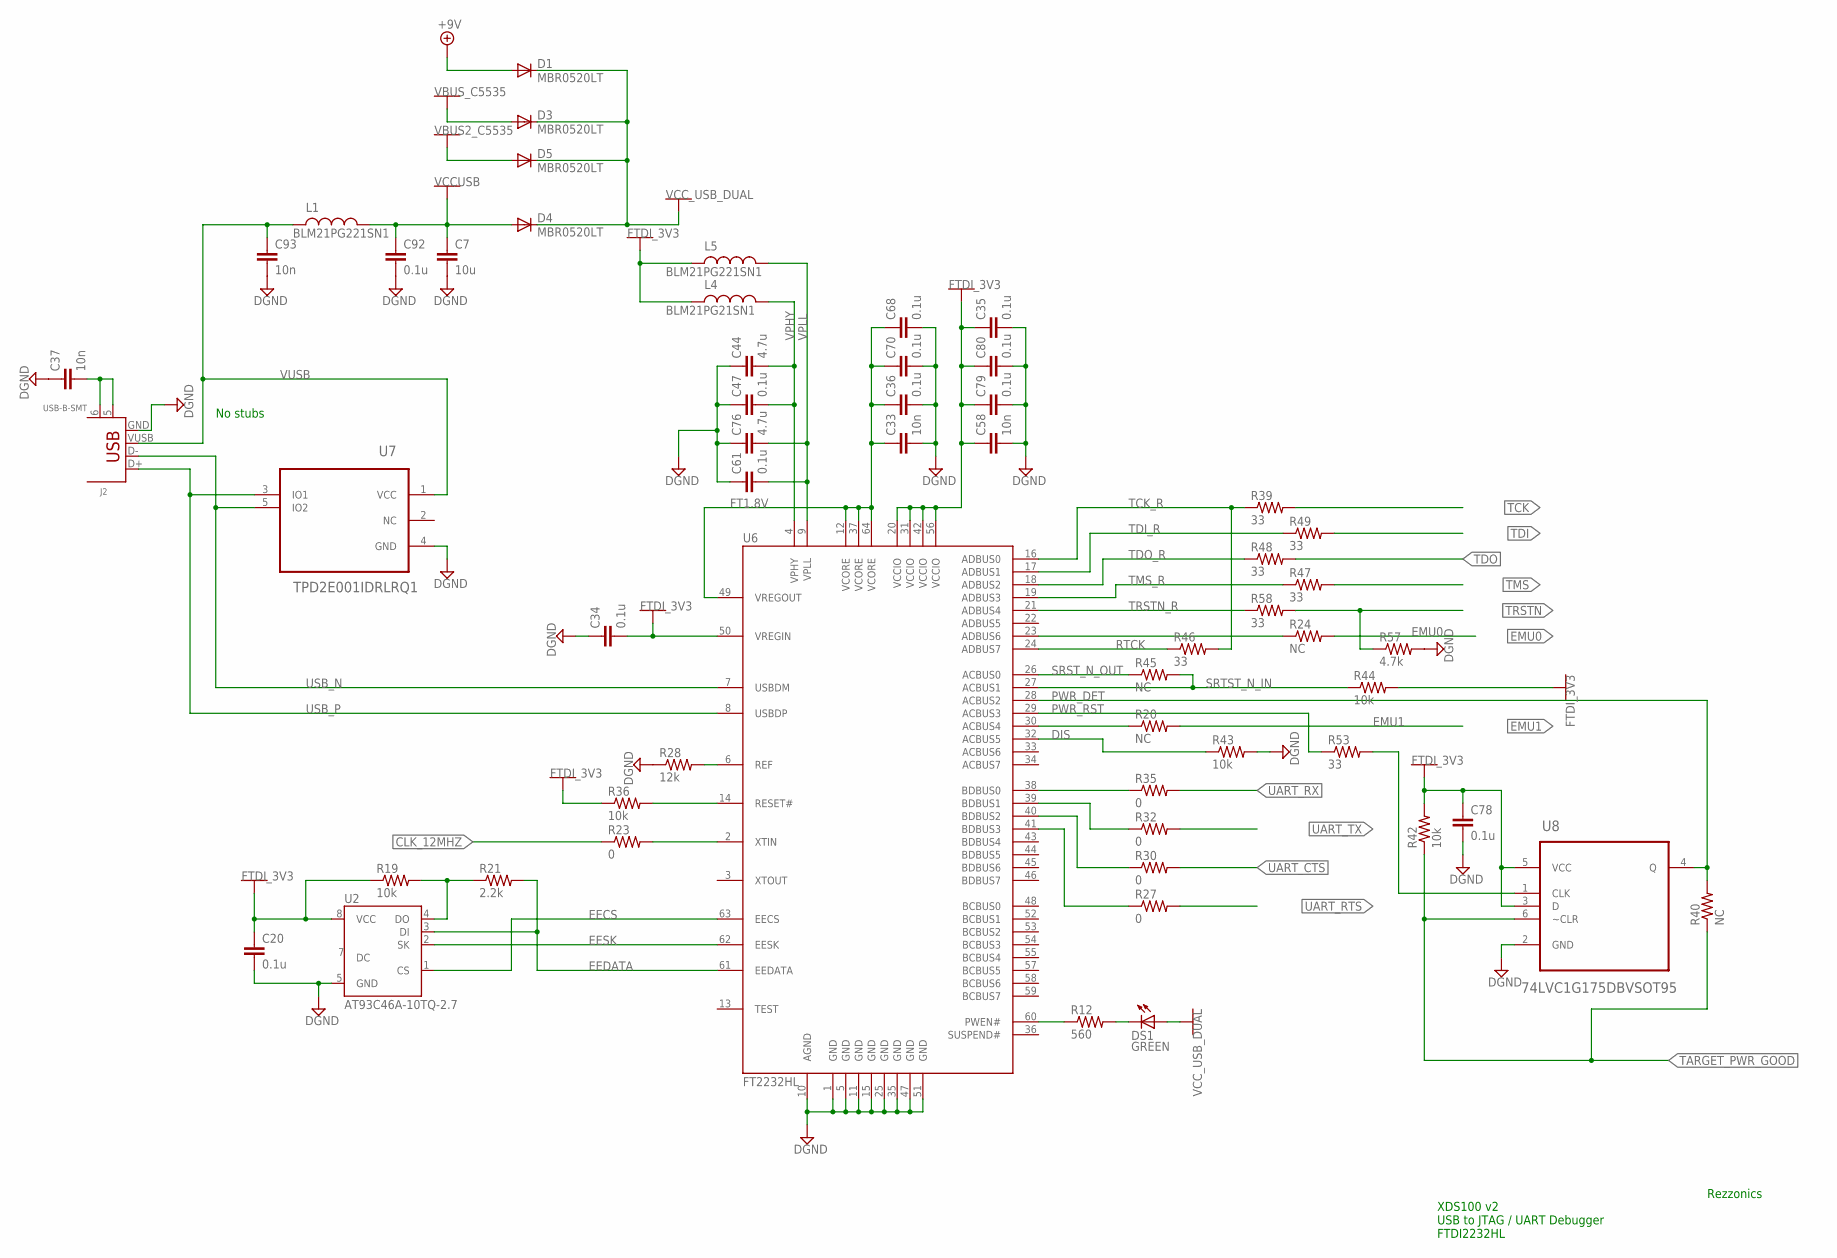
[picture p62: schematic DMFX-1 v1.2.sch, sheet 7]

Parts:
C7: 10u; C0603K; MPN GRM188R61C106MA73D
C20, C34, C35, C36, C47, C61, C68, C70, C78, C79, C80, C92: 0.1u; C0402K; MPN GRM155R71C104JA88D
C33, C37, C58, C93: 10n; C0402K; MPN GRM155R71E103KA01D
C44, C76: 4.7u; C0603K; MPN GRM188R60J475KE19D
D1, D3, D4, D5: MBR0520LT; SOD123; MPN MBR0520LT1G
DS1: GREEN; CHIPLED_1206; MPN LTST-C230KGKT
J2: USB-B-SMT; MPN M701-370442
L1, L5: BLM21PG221SN1; 0805; MPN BLM21PG221SN1D
L4: BLM21PG21SN1; 0805; MPN BLM21PG221SN1D
R12: 560; 0402-RES; MPN ERJ-2RKF2200X
R19, R36, R42, R43, R44: 10k; 0402-RES; MPN ERJ-2RKF1002X
R20, R24: NC; 0402-RES
R21: 2.2k; 0402-RES; MPN ERJ-2RKF2201X
R23, R27, R30, R32, R35: 0; 0402-RES; MPN ERJ-2GE0R00X
R28: 12k; 0402-RES; MPN ERJ-2RKF1202X
R39, R46, R47, R48, R49, R53, R58: 33; 0402-RES; MPN ERJ-2RKF33R0X
R40, R45: NC; 0402-RES; MPN *
R57: 4.7k; 0402-RES; MPN ERJ-2RKF4701X
U2: AT93C46A-10TQ-2.7; TSSOP8; MPN AT93C46D-TH-T
U6: FT2232HL; LQFP-10X10-64; MPN FT2232HL-REEL
U7: TPD2E001IDRLRQ1; SOT50P160X60-5N; MPN TPD2E001DRLR
U8: 74LVC1G175DBVSOT95; SOT95P280X145-6N; MPN SN74LVC1G175DBVT

Connections:
CLK_12MHZ: R23.1; also elsewhere on the board
DGND: C7.2, C20.2, C33.2, C34.1, C35.2, C36.2, C37.1, C44.1, C47.1, C58.2, C61.1, C68.2, C70.2, C76.1, C78.2, C79.2, C80.2, C92.2, C93.2, J2.GND, R28.1, R43.2, R57.2, U2.5 (GND), U6.1 (GND), U6.5 (GND), U6.10 (AGND), U6.11 (GND), U6.15 (GND), U6.25 (GND), U6.35 (GND), U6.47 (GND), U6.51 (GND), U7.4 (GND), U8.2 (GND); also elsewhere on the board
DIS: R43.1, U6.32 (ACBUS5)
EECS: U2.1 (CS), U6.63 (EECS)
EEDATA: R21.2, U2.3 (DI), U6.61 (EEDATA)
EESK: U2.2 (SK), U6.62 (EESK)
EMU0: R24.2; also elsewhere on the board
EMU1: R20.2; also elsewhere on the board
FT1.8V: C33.1, C36.1, C68.1, C70.1, U6.12 (VCORE), U6.37 (VCORE), U6.49 (VREGOUT), U6.64 (VCORE)
FTDI_3V3: C20.1, C34.2, C35.1, C58.1, C78.1, C79.1, C80.1, L4.1, L5.1, R19.1, R36.1, R42.2, R44.2, U2.8 (VCC), U6.20 (VCCIO), U6.31 (VCCIO), U6.42 (VCCIO), U6.50 (VREGIN), U6.56 (VCCIO), U8.3 (D), U8.5 (VCC); also elsewhere on the board
unnamed: R20.1, U6.30 (ACBUS4)
unnamed: R24.1, U6.23 (ADBUS6)
unnamed: R36.2, U6.14 (RESET#)
unnamed: R23.2, U6.2 (XTIN)
unnamed: R28.2, U6.6 (REF)
unnamed: R19.2, R21.1, U2.4 (DO)
unnamed: DS1.C, R12.2
unnamed: R12.1, U6.60 (PWEN#)
unnamed: C37.2, J2.5, J2.6
unnamed: R53.2, U8.1 (CLK)
unnamed: R35.1, U6.38 (BDBUS0)
unnamed: R32.1, U6.39 (BDBUS1)
unnamed: R30.1, U6.40 (BDBUS2)
unnamed: R27.1, U6.41 (BDBUS3)
PWR_DET: R40.2, U6.28 (ACBUS2), U8.4 (Q)
PWR_RST: R53.1, U6.29 (ACBUS3)
RTCK: R46.1, U6.24 (ADBUS7)
SRST_N_OUT: R45.1, U6.26 (ACBUS0)
SRTST_N_IN: R44.1, R45.2, U6.27 (ACBUS1)
TARGET_PWR_GOOD: R40.1, R42.1, U8.6 (~CLR); also elsewhere on the board
TCK: R39.2; also elsewhere on the board
TCK_R: R39.1, R46.2, U6.16 (ADBUS0)
TDI: R49.2; also elsewhere on the board
TDI_R: R49.1, U6.17 (ADBUS1)
TDO: R48.2; also elsewhere on the board
TDO_R: R48.1, U6.18 (ADBUS2)
TMS: R47.2; also elsewhere on the board
TMS_R: R47.1, U6.19 (ADBUS3)
TRSTN: R57.1, R58.2; also elsewhere on the board
TRSTN_R: R58.1, U6.21 (ADBUS4)
UART_CTS: R30.2; also elsewhere on the board
UART_RTS: R27.2; also elsewhere on the board
UART_RX: R35.2; also elsewhere on the board
UART_TX: R32.2; also elsewhere on the board
USB_N: J2.D-, U6.7 (USBDM), U7.5 (IO2)
USB_P: J2.D+, U6.8 (USBDP), U7.3 (IO1)
V3.3AA: D1.A; also elsewhere on the board
VBUS2_C5535: D5.A; also elsewhere on the board
VBUS_C5535: D3.A; also elsewhere on the board
VCCUSB: C7.1, C92.1, D4.A, L1.2
VCC_USB_DUAL: D1.C, D3.C, D4.C, D5.C, DS1.A; also elsewhere on the board
VPHY: C44.2, C47.2, L4.2, U6.4 (VPHY)
VPLL: C61.2, C76.2, L5.2, U6.9 (VPLL)
VUSB: C93.1, J2.VUSB (VBUS), L1.1, U7.1 (VCC)

Notes on the sheet:
No stubs
Rezzonics
XDS100 v2 USB to JTAG / UART Debugger FTDI2232HL

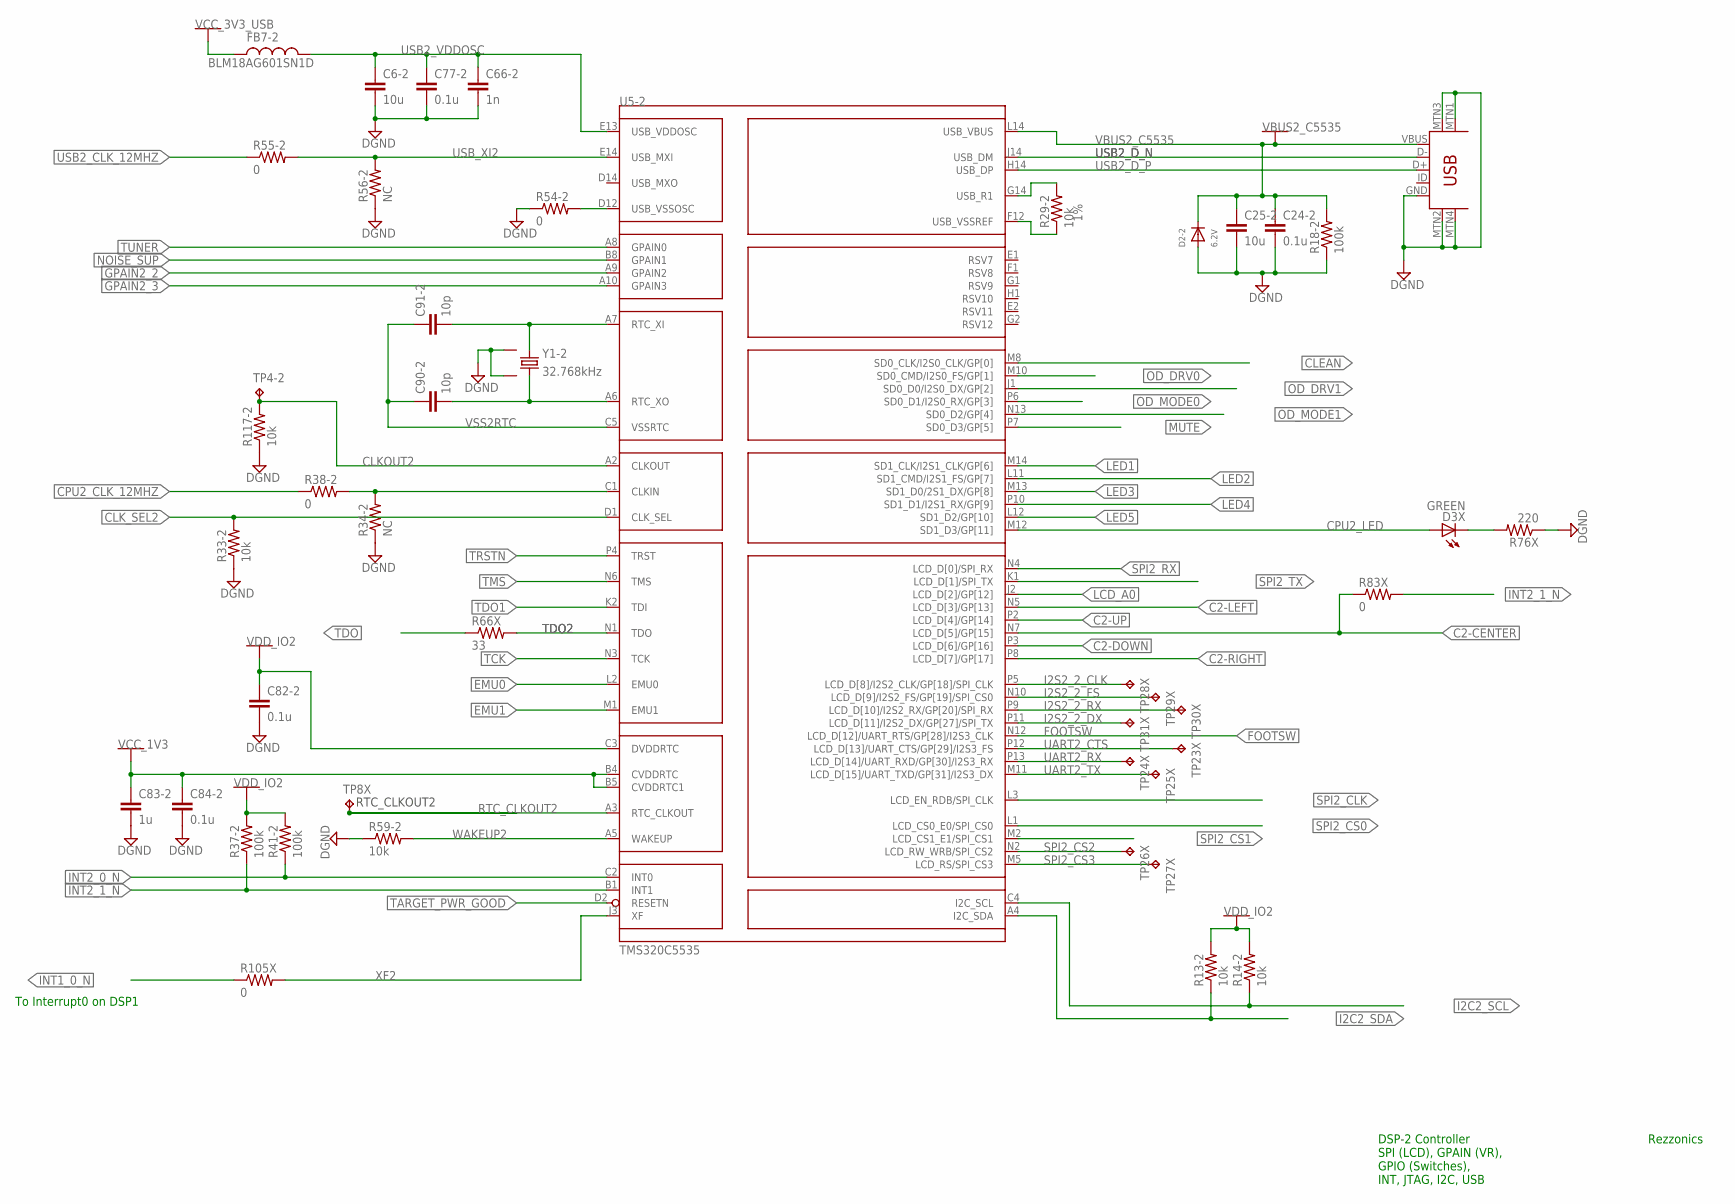
[picture p63: schematic DMFX-1 v1.2.sch, sheet 8]

Parts:
C6-2, C25-2: 10u; C0603K; MPN GRM188R61C106MA73D
C24-2, C77-2: 0.1u; C0402K; MPN GRM155R71C104JA88D
C66-2: 1n; 0402; MPN GRM155R71H102JA01J
C82-2, C84-2: 0.1u; 0402; MPN GRM155R71C104JA88D
C83-2: 1u; 0402; MPN GRM155R70J105KA12D
C90-2, C91-2: 10p; C0402K; MPN GRM1555C1H100FA01D
D2-2: 6.2V; SMADIODE; MPN 1SMA5920BT3G
D3X: GREEN; CHIPLED_0603; MPN LTST-C190KGKT
FB7-2: BLM18AG601SN1D; 0805; MPN BLM21AG151SN1D
J1-2: USB-MINIB-5PIN; USB-MINIB; MPN 10033526-N3212LF
R13-2, R14-2, R33-2, R59-2, R117-2: 10k; 0402-RES; MPN ERJ-2RKF1002X
R18-2, R37-2, R41-2: 100k; 0402-RES; MPN ERJ-2RKF1003X
R29-2: 10k; 0402; TOLERANCE 1%; MPN ERJ-2RKF1002X
R34-2: NC; 0402; MPN *
R38-2, R54-2, R83X: 0; 0402; MPN ERJ-2GE0R00X
R55-2, R105X: 0; 0402-RES; MPN ERJ-2GE0R00X
R56-2: NC; 0402-RES; MPN *
R66X: 33; 0402-RES; MPN ERJ-2RKF33R0X
R76X: 220; 0402-RES; MPN ERJ-2RKF2200X
TP4-2, TP8X, TP23X, TP24X, TP25X, TP26X, TP27X, TP28X, TP29X, TP30X, TP31X: TPTP06R; TP06R; MPN *
U5: TMS320C5535; PBGA144; MPN TMS320C5535AZHH10
Y1-2: 32.768kHz; CRYSTAL-32KHZ-SMD_EPSON_MC146; MPN SSPT7F-12.5PF20-R

Connections:
C2-CENTER: R83X.1, U5.N7 (LCD_D[5]/GP[15]); also elsewhere on the board
C2-DOWN: U5.P3 (LCD_D[6]/GP[16]); also elsewhere on the board
C2-LEFT: U5.N5 (LCD_D[3]/GP[13]); also elsewhere on the board
C2-RIGHT: U5.P8 (LCD_D[7]/GP[17]); also elsewhere on the board
C2-UP: U5.P2 (LCD_D[4]/GP[14]); also elsewhere on the board
CLEAN: U5.M8 (SD0_CLK/I2S0_CLK/GP[0]); also elsewhere on the board
CLKOUT2: R117-2.2, TP4-2.TP, U5.A2 (CLKOUT)
CLK_SEL2: R33-2.2, U5.D1 (CLK_SEL)
CPU2_CLK_12MHZ: R38-2.1; also elsewhere on the board
CPU2_LED: D3X.A, U5.M12 (SD1_D3/GP[11])
DGND: C6-2.2, C24-2.2, C25-2.2, C66-2.2, C77-2.2, C82-2.2, C83-2.2, C84-2.2, D2-2.A, J1-2.GND, J1-2.MTN1 (MTN2), J1-2.MTN2 (MTN3), J1-2.MTN3 (MTN1), J1-2.MTN4, R18-2.1, R33-2.1, R34-2.1, R54-2.1, R56-2.1, R59-2.1, R76X.1, R117-2.1, Y1-2.NC1 (3), Y1-2.NC2 (4); also elsewhere on the board
EMU0: U5.L2 (EMU0); also elsewhere on the board
EMU1: U5.M1 (EMU1); also elsewhere on the board
FOOTSW: U5.N12 (LCD_D[12]/UART_RTS/GP[28]/I2S3_CLK); also elsewhere on the board
GPAIN2_2: U5.A9 (GPAIN2); also elsewhere on the board
GPAIN2_3: U5.A10 (GPAIN3); also elsewhere on the board
I2C2_SCL: R14-2.1, U5.C4 (I2C_SCL); also elsewhere on the board
I2C2_SDA: R13-2.1, U5.A4 (I2C_SDA); also elsewhere on the board
I2S2_2_CLK: TP28X.TP, U5.P5 (LCD_D[8]/I2S2_CLK/GP[18]/SPI_CLK)
I2S2_2_DX: TP31X.TP, U5.P11 (LCD_D[11]/I2S2_DX/GP[27]/SPI_TX)
I2S2_2_FS: TP29X.TP, U5.N10 (LCD_D[9]/I2S2_FS/GP[19]/SPI_CS0)
I2S2_2_RX: TP30X.TP, U5.P9 (LCD_D[10]/I2S2_RX/GP[20]/SPI_RX)
INT1_0_N: R105X.1; also elsewhere on the board
INT2_0_N: R41-2.1, U5.C2 (INT0); also elsewhere on the board
INT2_1_N: R37-2.1, R83X.2, U5.B1 (INT1)
LCD_A0: U5.J2 (LCD_D[2]/GP[12]); also elsewhere on the board
LED1: U5.M14 (SD1_CLK/I2S1_CLK/GP[6]); also elsewhere on the board
LED2: U5.L11 (SD1_CMD/I2S1_FS/GP[7]); also elsewhere on the board
LED3: U5.M13 (SD1_D0/2S1_DX/GP[8]); also elsewhere on the board
LED4: U5.P10 (SD1_D1/I2S1_RX/GP[9]); also elsewhere on the board
LED5: U5.L12 (SD1_D2/GP[10]); also elsewhere on the board
MUTE: U5.P7 (SD0_D3/GP[5]); also elsewhere on the board
unnamed: C91-2.2, U5.A7 (RTC_XI), Y1-2.P$2 (2)
unnamed: C90-2.2, U5.A6 (RTC_XO), Y1-2.P$1 (1)
unnamed: R34-2.2, R38-2.2, U5.C1 (CLKIN)
unnamed: D3X.C, R76X.2
unnamed: R29-2.2, U5.G14 (USB_R1)
NOISE_SUP: U5.B8 (GPAIN1); also elsewhere on the board
OD_DRV0: U5.M10 (SD0_CMD/I2S0_FS/GP[1]); also elsewhere on the board
OD_DRV1: U5.J1 (SD0_D0/I2S0_DX/GP[2]); also elsewhere on the board
OD_MODE0: U5.P6 (SD0_D1/I2S0_RX/GP[3]); also elsewhere on the board
OD_MODE1: U5.N13 (SD0_D2/GP[4]); also elsewhere on the board
RTC_CLKOUT2: TP8X.TP, U5.A3 (RTC_CLKOUT)
SPI2_CLK: U5.L3 (LCD_EN_RDB/SPI_CLK); also elsewhere on the board
SPI2_CS0: U5.L1 (LCD_CS0_E0/SPI_CS0); also elsewhere on the board
SPI2_CS1: U5.M2 (LCD_CS1_E1/SPI_CS1); also elsewhere on the board
SPI2_CS2: TP26X.TP, U5.N2 (LCD_RW_WRB/SPI_CS2)
SPI2_CS3: TP27X.TP, U5.M5 (LCD_RS/SPI_CS3)
SPI2_RX: U5.N4 (LCD_D[0]/SPI_RX); also elsewhere on the board
SPI2_TX: U5.K1 (LCD_D[1]/SPI_TX); also elsewhere on the board
TARGET_PWR_GOOD: U5.D2 (RESETN); also elsewhere on the board
TCK: U5.N3 (TCK); also elsewhere on the board
TDO: R66X.1; also elsewhere on the board
TDO1: U5.K2 (TDI); also elsewhere on the board
TDO2: R66X.2, U5.N1 (TDO)
TMS: U5.N6 (TMS); also elsewhere on the board
TRSTN: U5.P4 (TRST); also elsewhere on the board
TUNER: U5.A8 (GPAIN0); also elsewhere on the board
UART2_CTS: TP23X.TP, U5.P12 (LCD_D[13]/UART_CTS/GP[29]/I2S3_FS)
UART2_RX: TP24X.TP, U5.P13 (LCD_D[14]/UART_RXD/GP[30]/I2S3_RX)
UART2_TX: TP25X.TP, U5.M11 (LCD_D[15]/UART_TXD/GP[31]/I2S3_DX)
USB2_CLK_12MHZ: R55-2.1; also elsewhere on the board
USB2_D_N: J1-2.D-, U5.J14 (USB_DM)
USB2_D_P: J1-2.D+, U5.H14 (USB_DP)
USB2_VDDOSC: C6-2.1, C66-2.1, C77-2.1, FB7-2.2, U5.E13 (USB_VDDOSC)
USB2_VSSOSC: R54-2.2, U5.D12 (USB_VSSOSC)
USB2_VSSREF: R29-2.1, U5.F12 (USB_VSSREF)
USB_XI2: R55-2.2, R56-2.2, U5.E14 (USB_MXI)
VBUS2_C5535: C24-2.1, C25-2.1, D2-2.C, J1-2.VBUS, R18-2.2, U5.L14 (USB_VBUS); also elsewhere on the board
VCC_1V3: C83-2.1, C84-2.1, U5.B4 (CVDDRTC), U5.B5 (CVDDRTC1); also elsewhere on the board
VCC_3V3_USB: FB7-2.1; also elsewhere on the board
VDD_IO2: C82-2.1, R13-2.2, R14-2.2, R37-2.2, R41-2.2, U5.C3 (DVDDRTC); also elsewhere on the board
VSS2RTC: C90-2.1, C91-2.1, U5.C5 (VSSRTC)
WAKEUP2: R59-2.2, U5.A5 (WAKEUP)
XF2: R105X.2, U5.J3 (XF)

Notes on the sheet:
To Interrupt0 on DSP1
Rezzonics
DSP-2 Controller SPI (LCD), GPAIN (VR), GPIO (Switches), INT, JTAG, I2C, USB

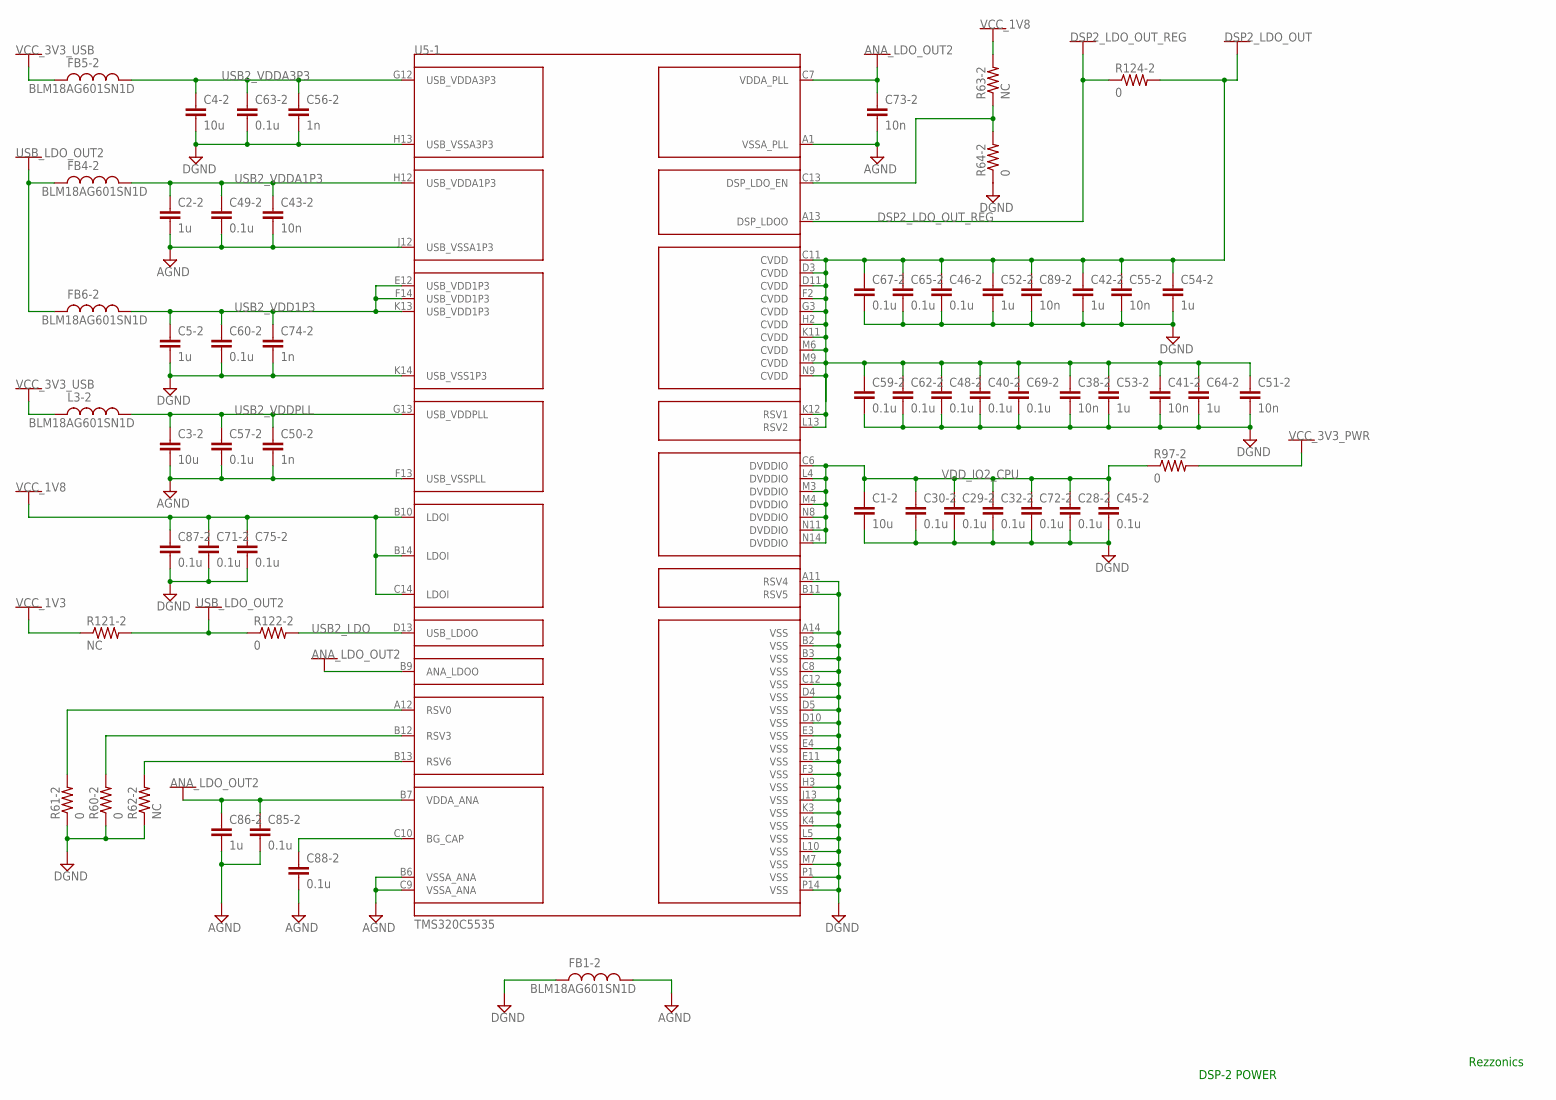
[picture p64: schematic DMFX-1 v1.2.sch, sheet 9]

Parts:
C1-2, C3-2, C4-2: 10u; C0603K; MPN GRM188R61C106MA73D
C2-2, C5-2: 1u; C0402K; MPN GRM155R70J105KA12D
C28-2, C29-2, C30-2, C32-2, C40-2, C45-2, C46-2, C48-2, C49-2, C57-2, C59-2, C60-2, C62-2, C63-2, C65-2, C67-2, C69-2, C71-2, C72-2, C75-2, C85-2, C87-2, C88-2: 0.1u; 0402; MPN GRM155R71C104JA88D
C38-2, C41-2, C43-2, C51-2, C55-2, C73-2: 10n; 0402; MPN GRM155R71E103KA01D
C42-2, C52-2, C53-2, C54-2, C64-2, C86-2: 1u; 0402; MPN GRM155R70J105KA12D
C50-2, C56-2: 1n; 0402; MPN GRM155R71H102JA01J
C74-2: 1n; C0402K; MPN GRM155R71H102JA01J
C89-2: 10n; C0402K; MPN GRM155R71E103KA01D
FB1-2, FB4-2, FB5-2, FB6-2: BLM18AG601SN1D; 0603; MPN BLM18AG601SN1D
L3-2: BLM18AG601SN1D; 0603; MPN BLM18AG601SN1D
R60-2, R61-2, R64-2: 0; 0402-RES; MPN ERJ-2GE0R00X
R62-2, R63-2: NC; 0402-RES; MPN *
R97-2, R122-2, R124-2: 0; 0805; MPN ERJ-6GEY0R00V
R121-2: NC; 0805; MPN *
U5: TMS320C5535; PBGA144; MPN TMS320C5535AZHH10

Connections:
AGND: C2-2.2, C3-2.2, C43-2.2, C49-2.2, C50-2.2, C57-2.2, C73-2.2, C85-2.2, C86-2.2, C88-2.2, FB1-2.2, U5.A1 (VSSA_PLL), U5.B6 (VSSA_ANA), U5.C9 (VSSA_ANA), U5.F13 (USB_VSSPLL), U5.J12 (USB_VSSA1P3); also elsewhere on the board
ANA_LDO_OUT2: C73-2.1, C85-2.1, C86-2.1, U5.B7 (VDDA_ANA), U5.B9 (ANA_LDOO), U5.C7 (VDDA_PLL); also elsewhere on the board
DGND: C1-2.2, C4-2.2, C5-2.2, C28-2.2, C29-2.2, C30-2.2, C32-2.2, C38-2.2, C40-2.2, C41-2.2, C42-2.2, C45-2.2, C46-2.2, C48-2.2, C51-2.2, C52-2.2, C53-2.2, C54-2.2, C55-2.2, C56-2.2, C59-2.2, C60-2.2, C62-2.2, C63-2.2, C64-2.2, C65-2.2, C67-2.2, C69-2.2, C71-2.2, C72-2.2, C74-2.2, C75-2.2, C87-2.2, C89-2.2, FB1-2.1, R60-2.1, R61-2.1, R62-2.1, R64-2.1, U5.A11 (RSV4), U5.A14 (VSS), U5.B2 (VSS), U5.B3 (VSS), U5.B11 (RSV5), U5.C8 (VSS), U5.C12 (VSS), U5.D4 (VSS), U5.D5 (VSS), U5.D10 (VSS), U5.E3 (VSS), U5.E4 (VSS), U5.E11 (VSS), U5.F3 (VSS), U5.H3 (VSS), U5.H13 (USB_VSSA3P3), U5.J13 (VSS), U5.K3 (VSS), U5.K4 (VSS), U5.K14 (USB_VSS1P3), U5.L5 (VSS), U5.L10 (VSS), U5.M7 (VSS), U5.P1 (VSS), U5.P14 (VSS); also elsewhere on the board
DSP2_LDO_OUT: C38-2.1, C40-2.1, C41-2.1, C42-2.1, C46-2.1, C48-2.1, C51-2.1, C52-2.1, C53-2.1, C54-2.1, C55-2.1, C59-2.1, C62-2.1, C64-2.1, C65-2.1, C67-2.1, C69-2.1, C89-2.1, R124-2.2, U5.C11 (CVDD), U5.D3 (CVDD), U5.D11 (CVDD), U5.F2 (CVDD), U5.G3 (CVDD), U5.H2 (CVDD), U5.K11 (CVDD), U5.K12 (RSV1), U5.L13 (RSV2), U5.M6 (CVDD), U5.M9 (CVDD), U5.N9 (CVDD)
DSP2_LDO_OUT_REG: R124-2.1, U5.A13 (DSP_LDOO)
unnamed: R61-2.2, U5.A12 (RSV0)
unnamed: R60-2.2, U5.B12 (RSV3)
unnamed: R62-2.2, U5.B13 (RSV6)
unnamed: C88-2.1, U5.C10 (BG_CAP)
unnamed: R63-2.1, R64-2.2, U5.C13 (DSP_LDO_EN)
USB2_LDO: R122-2.2, U5.D13 (USB_LDOO)
USB2_VDD1P3: C5-2.1, C60-2.1, C74-2.1, FB6-2.2, U5.E12 (USB_VDD1P3), U5.F14 (USB_VDD1P3), U5.K13 (USB_VDD1P3)
USB2_VDDA1P3: C2-2.1, C43-2.1, C49-2.1, FB4-2.2, U5.H12 (USB_VDDA1P3)
USB2_VDDA3P3: C4-2.1, C56-2.1, C63-2.1, FB5-2.2, U5.G12 (USB_VDDA3P3)
USB2_VDDPLL: C3-2.1, C50-2.1, C57-2.1, L3-2.2, U5.G13 (USB_VDDPLL)
USB_LDO_OUT2: FB4-2.1, FB6-2.1, R121-2.2, R122-2.1
VCC_1V3: R121-2.1; also elsewhere on the board
VCC_1V8: C71-2.1, C75-2.1, C87-2.1, R63-2.2, U5.B10 (LDOI), U5.B14 (LDOI), U5.C14 (LDOI); also elsewhere on the board
VCC_3V3_PWR: R97-2.2; also elsewhere on the board
VCC_3V3_USB: FB5-2.1, L3-2.1; also elsewhere on the board
VDD_IO2_CPU: C1-2.1, C28-2.1, C29-2.1, C30-2.1, C32-2.1, C45-2.1, C72-2.1, R97-2.1, U5.C6 (DVDDIO), U5.L4 (DVDDIO), U5.M3 (DVDDIO), U5.M4 (DVDDIO), U5.N8 (DVDDIO), U5.N11 (DVDDIO), U5.N14 (DVDDIO)

Notes on the sheet:
DSP-2 POWER
Rezzonics
