DMFX-1/Hardware/DMFX-1/DMFX-1 v1.2.brd

## EAGLE design DMFX-1/DMFX-1 v1.2.brd (continued)

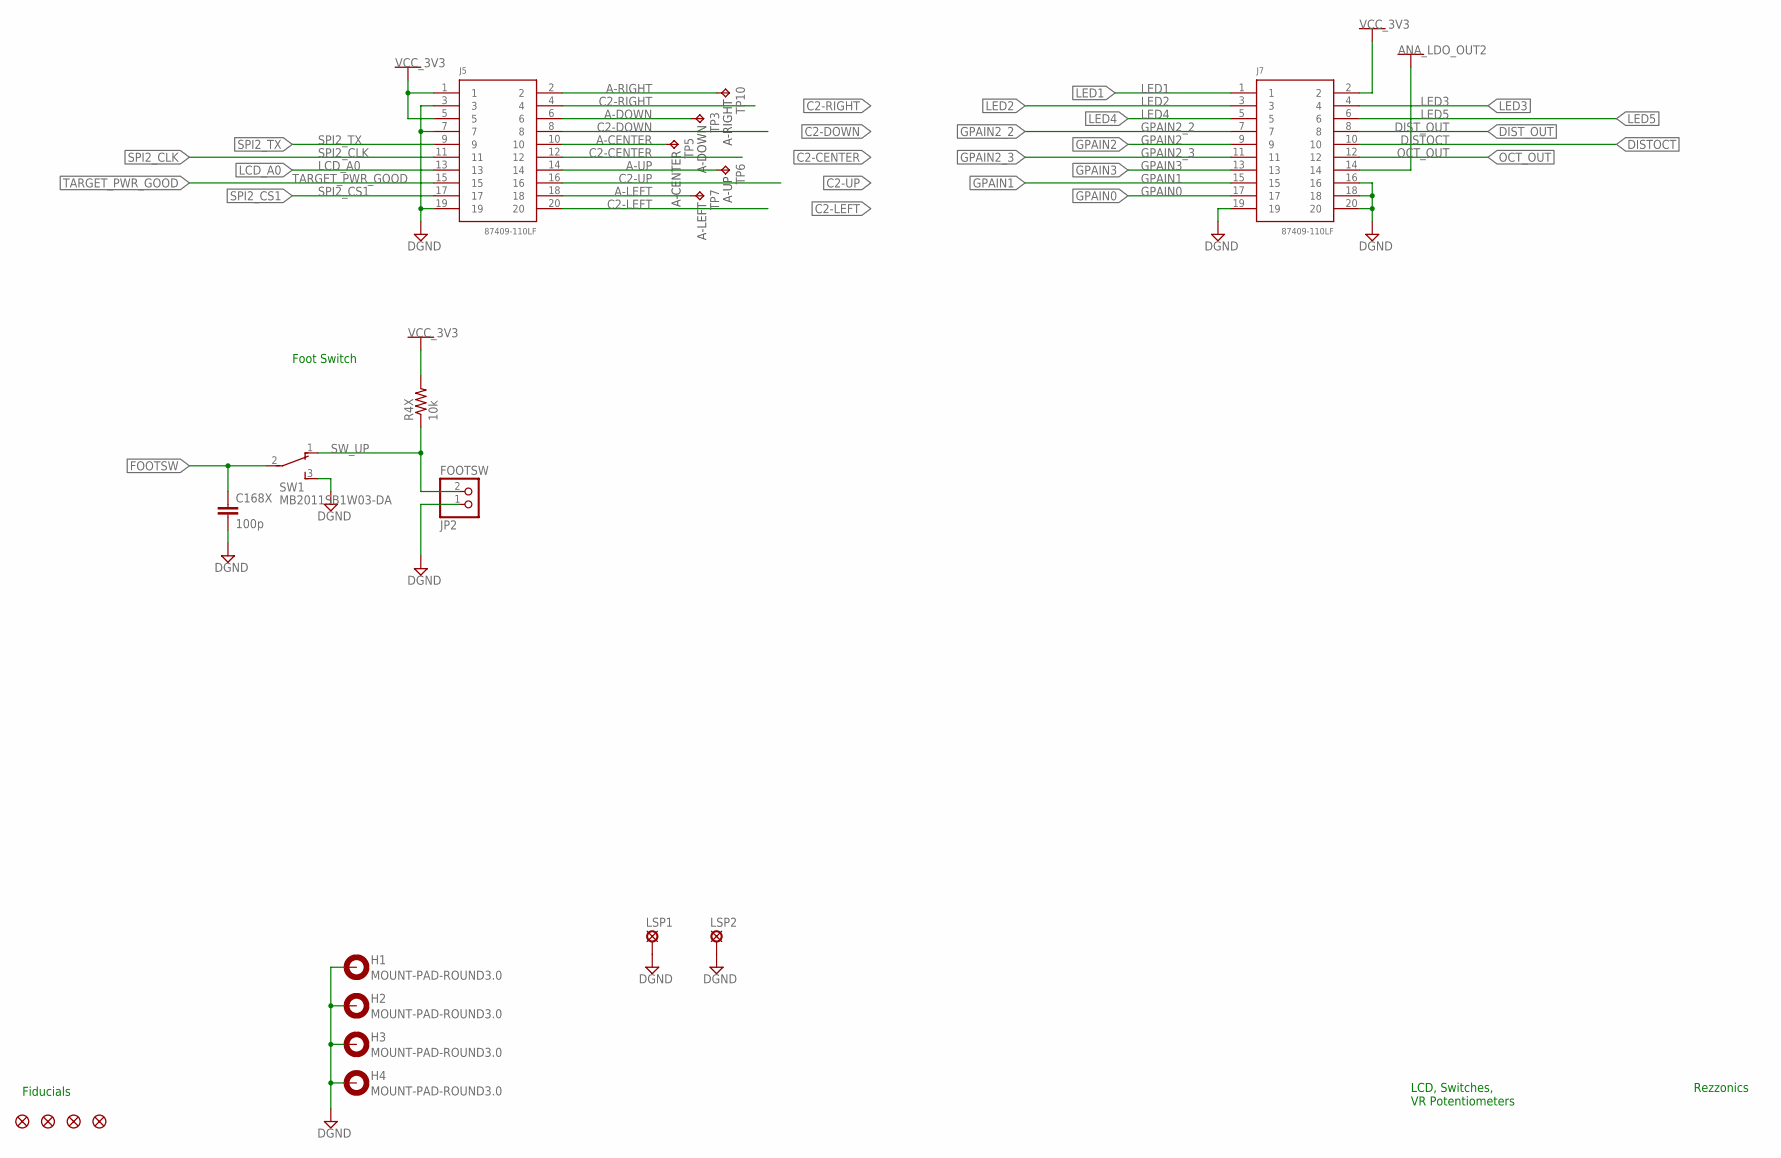
[picture p65: schematic DMFX-1 v1.2.sch, sheet 10]

Parts:
C168X: 100p; C0402K; MPN GRM1555C1H101FA01J
H1, H2, H3, H4: MOUNT-PAD-ROUND3.0; 3,0-PAD; MPN *
J5, J7: 87409-110LF; MPN 87409-110LF
JP2: FOOTSW; 1X02; MPN *
JP3, JP6, JP7, JP8: FIDUCIAL1X2.5; FIDUCIAL-1X2.5; MPN *
LSP1, LSP2: LSP13; MPN *
R4X: 10k; 0402-RES; MPN ERJ-2RKF1002X
SW1: MB2011SB1W03-DA; MB2011; MPN MB2011SB1W03-DA
TP3, TP5, TP6, TP7, TP10: TPTP12R; TP12R; MPN *

Connections:
A-CENTER: J5.10, TP5.TP
A-DOWN: J5.6, TP3.TP
A-LEFT: J5.18, TP7.TP
A-RIGHT: J5.2, TP10.TP
A-UP: J5.14, TP6.TP
ANA_LDO_OUT2: J7.14; also elsewhere on the board
C2-CENTER: J5.12; also elsewhere on the board
C2-DOWN: J5.8; also elsewhere on the board
C2-LEFT: J5.20; also elsewhere on the board
C2-RIGHT: J5.4; also elsewhere on the board
C2-UP: J5.16; also elsewhere on the board
DGND: C168X.2, H1.B3,0, H2.B3,0, H3.B3,0, H4.B3,0, J5.3, J5.7, J5.19, J7.16, J7.18, J7.19, J7.20, JP2.1, LSP1.MP, LSP2.MP, SW1.3 (S); also elsewhere on the board
DISTOCT: J7.10; also elsewhere on the board
DIST_OUT: J7.8; also elsewhere on the board
FOOTSW: C168X.1, SW1.2; also elsewhere on the board
GPAIN0: J7.17; also elsewhere on the board
GPAIN1: J7.15; also elsewhere on the board
GPAIN2: J7.9; also elsewhere on the board
GPAIN2_2: J7.7; also elsewhere on the board
GPAIN2_3: J7.11; also elsewhere on the board
GPAIN3: J7.13; also elsewhere on the board
LCD_A0: J5.13; also elsewhere on the board
LED1: J7.1; also elsewhere on the board
LED2: J7.3; also elsewhere on the board
LED3: J7.4; also elsewhere on the board
LED4: J7.5; also elsewhere on the board
LED5: J7.6; also elsewhere on the board
OCT_OUT: J7.12; also elsewhere on the board
SPI2_CLK: J5.11; also elsewhere on the board
SPI2_CS1: J5.17; also elsewhere on the board
SPI2_TX: J5.9; also elsewhere on the board
SW_UP: JP2.2, R4X.1, SW1.1 (O)
TARGET_PWR_GOOD: J5.15; also elsewhere on the board
VCC_3V3: J5.1, J5.5, J7.2, R4X.2; also elsewhere on the board

Notes on the sheet:
Rezzonics
LCD, Switches, VR Potentiometers
Fiducials
Foot Switch

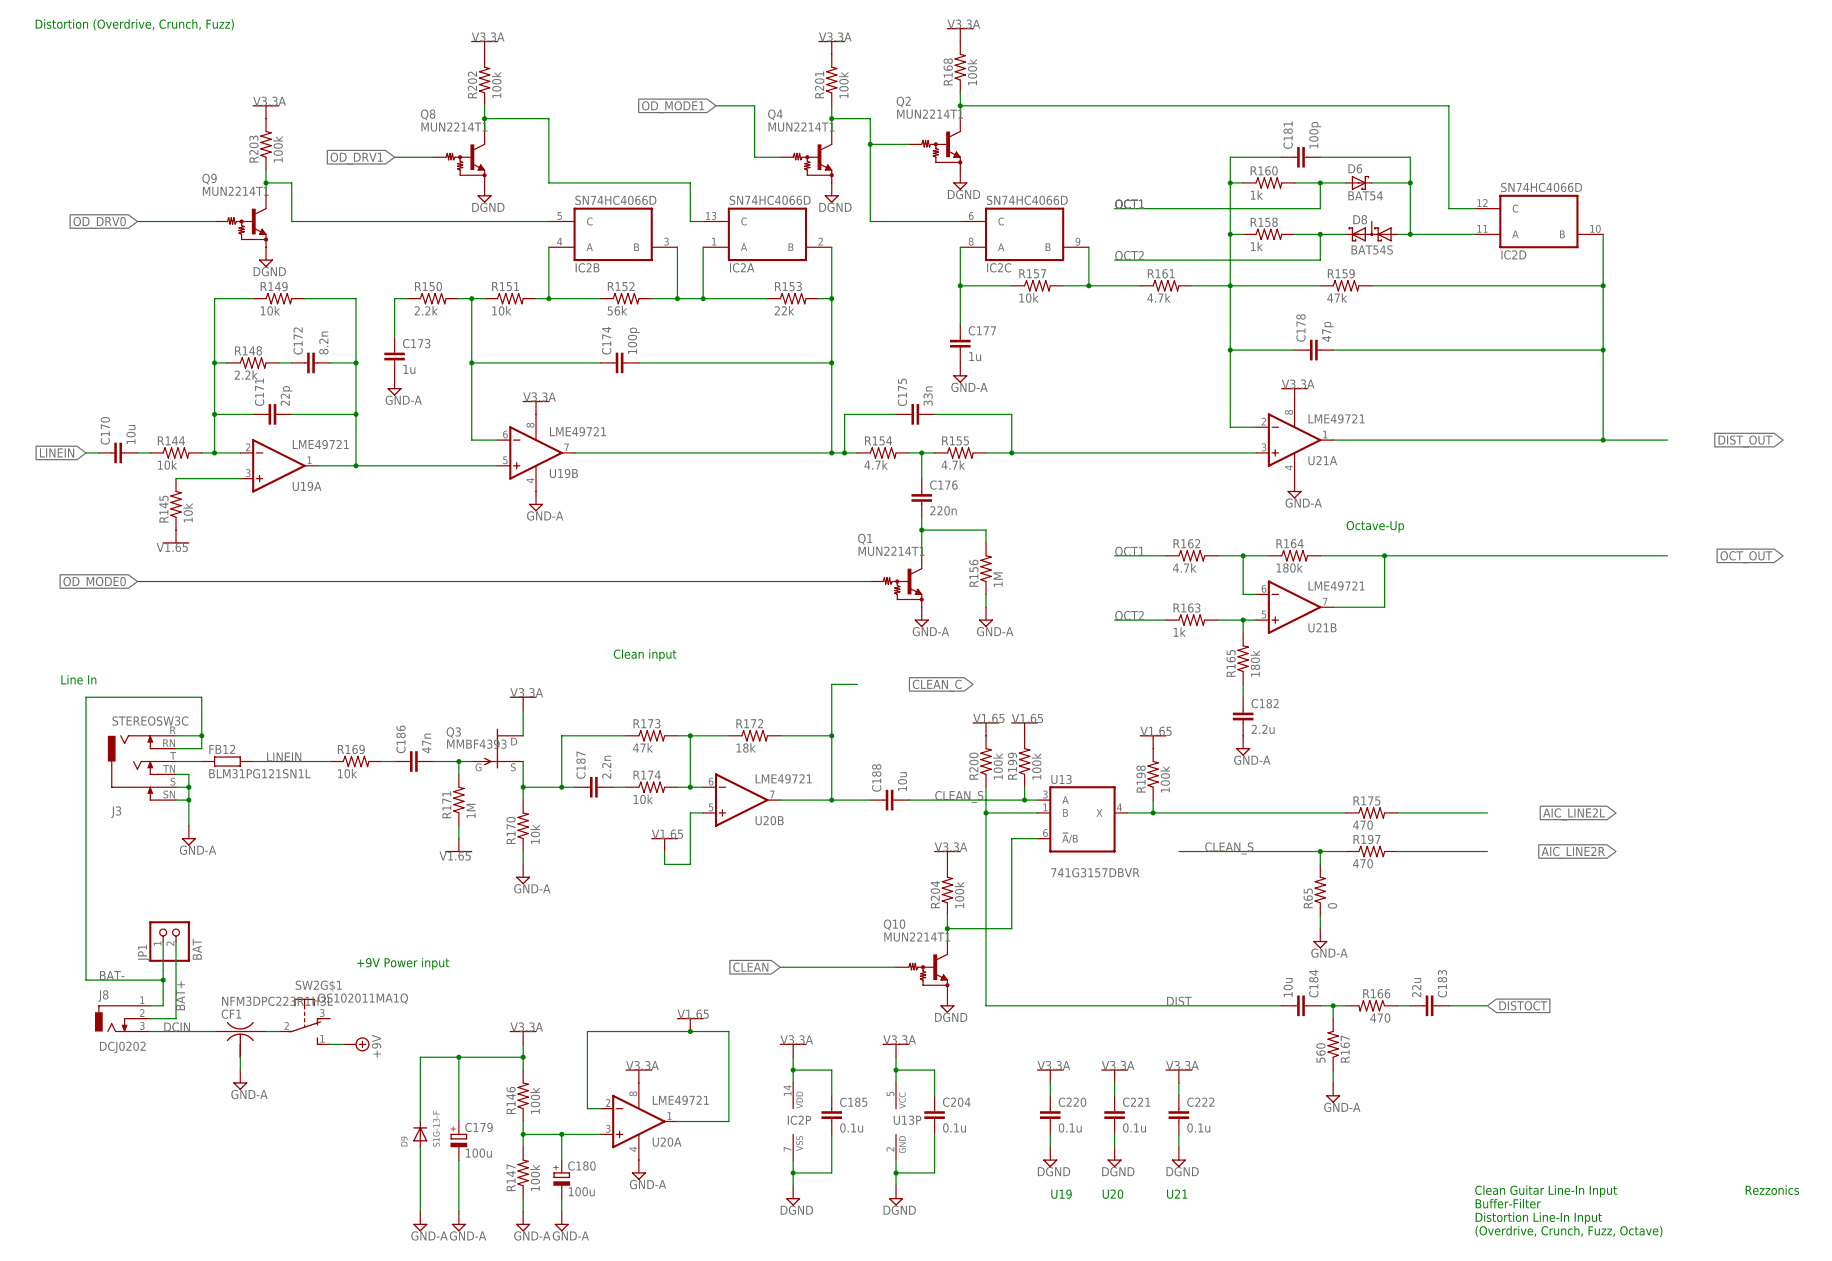
[picture p66: schematic DMFX-1 v1.2.sch, sheet 11]

Parts:
C170, C184, C188: 10u; C0805K; MPN GRM21BR71A106KA73L
C171: 22p; 0402-CAP; MPN GRM1555C2A220JA01D
C172: 8.2n; 0402-CAP; MPN GRM155R71H822KA88D
C173, C177: 1u; 0402-CAP; MPN GRM155R70J105KA12D
C174, C181: 100p; 0402-CAP; MPN GRM1555C1H101FA01J
C175: 33n; 0402-CAP; MPN GRM155R71E333KA88J
C176: 220n; 0402-CAP; MPN GRM155R71C224KA12D
C178: 47p; 0402-CAP; MPN GRM1555C1H470FA01D
C179, C180: 100u; PANASONIC_D; MPN AVE107M25X16T-F
C182: 2.2u; 0402-CAP; MPN GRM155R60J225ME15D
C183: 22u; C1206K; MPN GRM31CR71A226KE15L
C185, C204, C220, C221, C222: 0.1u; C0402K; MPN GRM155R71C104JA88D
C186: 47n; 0402-CAP; MPN GRM155R71H473KE14D
C187: 2.2n; 0402-CAP; MPN GRM155R71H222JA01J
CF1: NFM3DPC223R1H3L; NFM3DC; MPN NFM3DPC223R1H3L
D6: BAT54; SOT23; MPN BAT54LT1G
D8: BAT54S; SOT23; MPN BAT54SLT1G
D9: S1G-13-F; SMADIODE; MPN S1G-13-F
FB12: BLM31PG121SN1L; R1206; MPN BLM31PG121SN1L
IC2: SN74HC4066D; SO14; MPN SN74HC4066DR
J3: STEREOSW3C; NEUTRIK-NMJ6HCD2; MPN NMJ6HCD2
J8: DCJ0202; MPN PJ-202A
JP1: BAT; 1X02; MPN 929834-01-02-RK
Q1, Q2, Q4, Q8, Q9, Q10: MUN2214T1; SC59-BEC; MPN MUN2214T1G
Q3: MMBF4393; SOT23; MPN MMBF4393
R65: 0; 0402-RES; MPN ERJ-2GE0R00X
R144, R145, R149, R157, R169, R170, R174: 10k; 0402-RES; MPN ERJ-2RKF1002X
R146, R147, R168, R198, R199, R200, R201, R202, R203, R204: 100k; 0402-RES; MPN ERJ-2RKF1003X
R148, R150: 2.2k; 0402-RES; MPN ERJ-2RKF2201X
R151: 10k; 0402-RES; MPN ERJ-2RKF3302X
R152: 56k; 0402-RES; MPN ERJ-2RKF1803X
R153: 22k; 0402-RES; MPN ERJ-2RKF5602X
R154, R155, R161, R162: 4.7k; 0402-RES; MPN ERJ-2RKF4701X
R156, R171: 1M; 0402-RES; MPN ERJ-2RKF1004X
R158, R160, R163: 1k; 0402-RES; MPN ERJ-2RKF1001X
R159, R173: 47k; 0402-RES; MPN ERJ-2RKF4702X
R164, R165: 180k; 0402-RES; MPN ERJ-2RKF1803X
R166, R175: 470; 0402-RES; MPN ERJ-2RKF4700X
R167: 560; 0402-RES; MPN ERJ-2RKF5600X
R172: 18k; 0402-RES; MPN ERJ-2RKF1802X
R197: 470; 0402-RES; MPN ERJ-2GE0R00X
SW2: OS102011MA1Q; MPN OS102011MA1QN1
U13: 741G3157DBVR; DBV_R-PDSO-G6; MPN SN74LVC1G3157DBVR
U19, U20, U21: LME49721; SO08; MPN LME49721MAX/NOPB

Connections:
AIC_LINE2L: R175.2; also elsewhere on the board
AIC_LINE2R: R197.2; also elsewhere on the board
BAT+: J8.2, JP1.2
BAT-: J3.R, J3.RN, J8.1, JP1.1
CLEAN: Q10.B; also elsewhere on the board
CLEAN_C: C188.1, R172.2, U20.7 (OUT); also elsewhere on the board
CLEAN_S: C188.2, R65.2, R197.1, R199.1, U13.3 (A)
DCIN: CF1.1, J8.3
DGND: C185.2, C204.2, C220.2, C221.2, C222.2, IC2.7 (VSS), Q2.E, Q4.E, Q8.E, Q9.E, Q10.E, U13.2 (GND); also elsewhere on the board
DIST: C184.2, R200.1, U13.1 (B)
DISTOCT: C183.1; also elsewhere on the board
DIST_OUT: C178.2, IC2.10 (B), R159.2, U21.1 (OUT); also elsewhere on the board
GND-A: C173.2, C177.2, C179.-, C180.-, C182.2, CF1.2@1 (2), D9.A, J3.S, J3.SN, J3.TN, Q1.E, R65.1, R147.1, R156.1, R167.1, R170.1, U19.4 (V-), U20.4 (V-), U21.4 (V-); also elsewhere on the board
LINEIN: C170.1, FB12.2, R169.1
unnamed: C170.2, R144.1
unnamed: C171.1, R144.2, R148.1, R149.1, U19.2 (-IN)
unnamed: R145.2, U19.3 (+IN)
unnamed: C186.1, R169.2
unnamed: C172.1, R148.2
unnamed: C171.2, C172.2, R149.2, U19.1 (OUT), U19.5 (+IN)
unnamed: C173.1, R150.1
unnamed: C174.1, R150.2, R151.1, U19.6 (-IN)
unnamed: C174.2, C175.1, IC2.2 (B), R153.2, R154.1, U19.7 (OUT)
unnamed: IC2.1 (A), IC2.3 (B), R152.2, R153.1
unnamed: IC2.4 (A), R151.2, R152.1
unnamed: C176.1, R154.2, R155.1
unnamed: C175.2, R155.2, U21.3 (+IN)
unnamed: C176.2, Q1.C, R156.2
unnamed: C177.1, IC2.8 (A), R157.1
unnamed: C178.1, C181.1, R158.1, R159.1, R160.1, R161.2, U21.2 (-IN)
unnamed: R163.2, R165.2, U21.5 (+IN)
unnamed: C182.1, R165.1
unnamed: IC2.9 (B), R157.2, R161.1
unnamed: C181.2, D6.3 (C), D8.1 (A1), IC2.11 (A)
unnamed: R162.2, R164.1, U21.6 (-IN)
unnamed: C183.2, R166.1
unnamed: C184.1, R166.2, R167.2
unnamed: FB12.1, J3.T
unnamed: IC2.12 (C), Q2.C, R168.1
unnamed: C180.+, R146.1, R147.2, U20.3 (+IN)
unnamed: C186.2, Q3.3 (G), R171.2
unnamed: IC2.5 (C), Q9.C, R203.1
unnamed: C187.2, R174.1
unnamed: R172.1, R173.2, R174.2, U20.6 (-IN)
unnamed: C187.1, Q3.2 (S), R170.2, R173.1
unnamed: CF1.3, SW2.2
unnamed: IC2.13 (C), Q8.C, R202.1
unnamed: R175.1, R198.1, U13.4 (X)
unnamed: IC2.6 (C), Q2.B, Q4.C, R201.1
unnamed: Q10.C, R204.1, U13.6 (!A!/B)
OCT1: D6.1 (A), R160.2, R162.1
OCT2: D8.2 (C2), R158.2, R163.1
OCT_OUT: R164.2, U21.7 (OUT); also elsewhere on the board
OD_DRV0: Q9.B; also elsewhere on the board
OD_DRV1: Q8.B; also elsewhere on the board
OD_MODE0: Q1.B; also elsewhere on the board
OD_MODE1: Q4.B; also elsewhere on the board
V1.65: R145.1, R171.1, R198.2, R199.2, R200.2, U20.1 (OUT), U20.2 (-IN), U20.5 (+IN); also elsewhere on the board
V3.3A: C179.+, C185.1, C204.1, C220.1, C221.1, C222.1, D9.C, IC2.14 (VDD), Q3.1 (D), R146.2, R168.2, R201.2, R202.2, R203.2, R204.2, U13.5 (VCC), U19.8 (V+), U20.8 (V+), U21.8 (V+); also elsewhere on the board
V3.3AA: SW2.1 (S); also elsewhere on the board

Notes on the sheet:
Line In
Distortion (Overdrive, Crunch, Fuzz)
Clean input
+9V Power input
Octave-Up
Rezzonics
Clean Guitar Line-In Input Buffer-Filter Distortion Line-In Input (Overdrive, Crunch, Fuzz, Octave)
U19
U20
U21

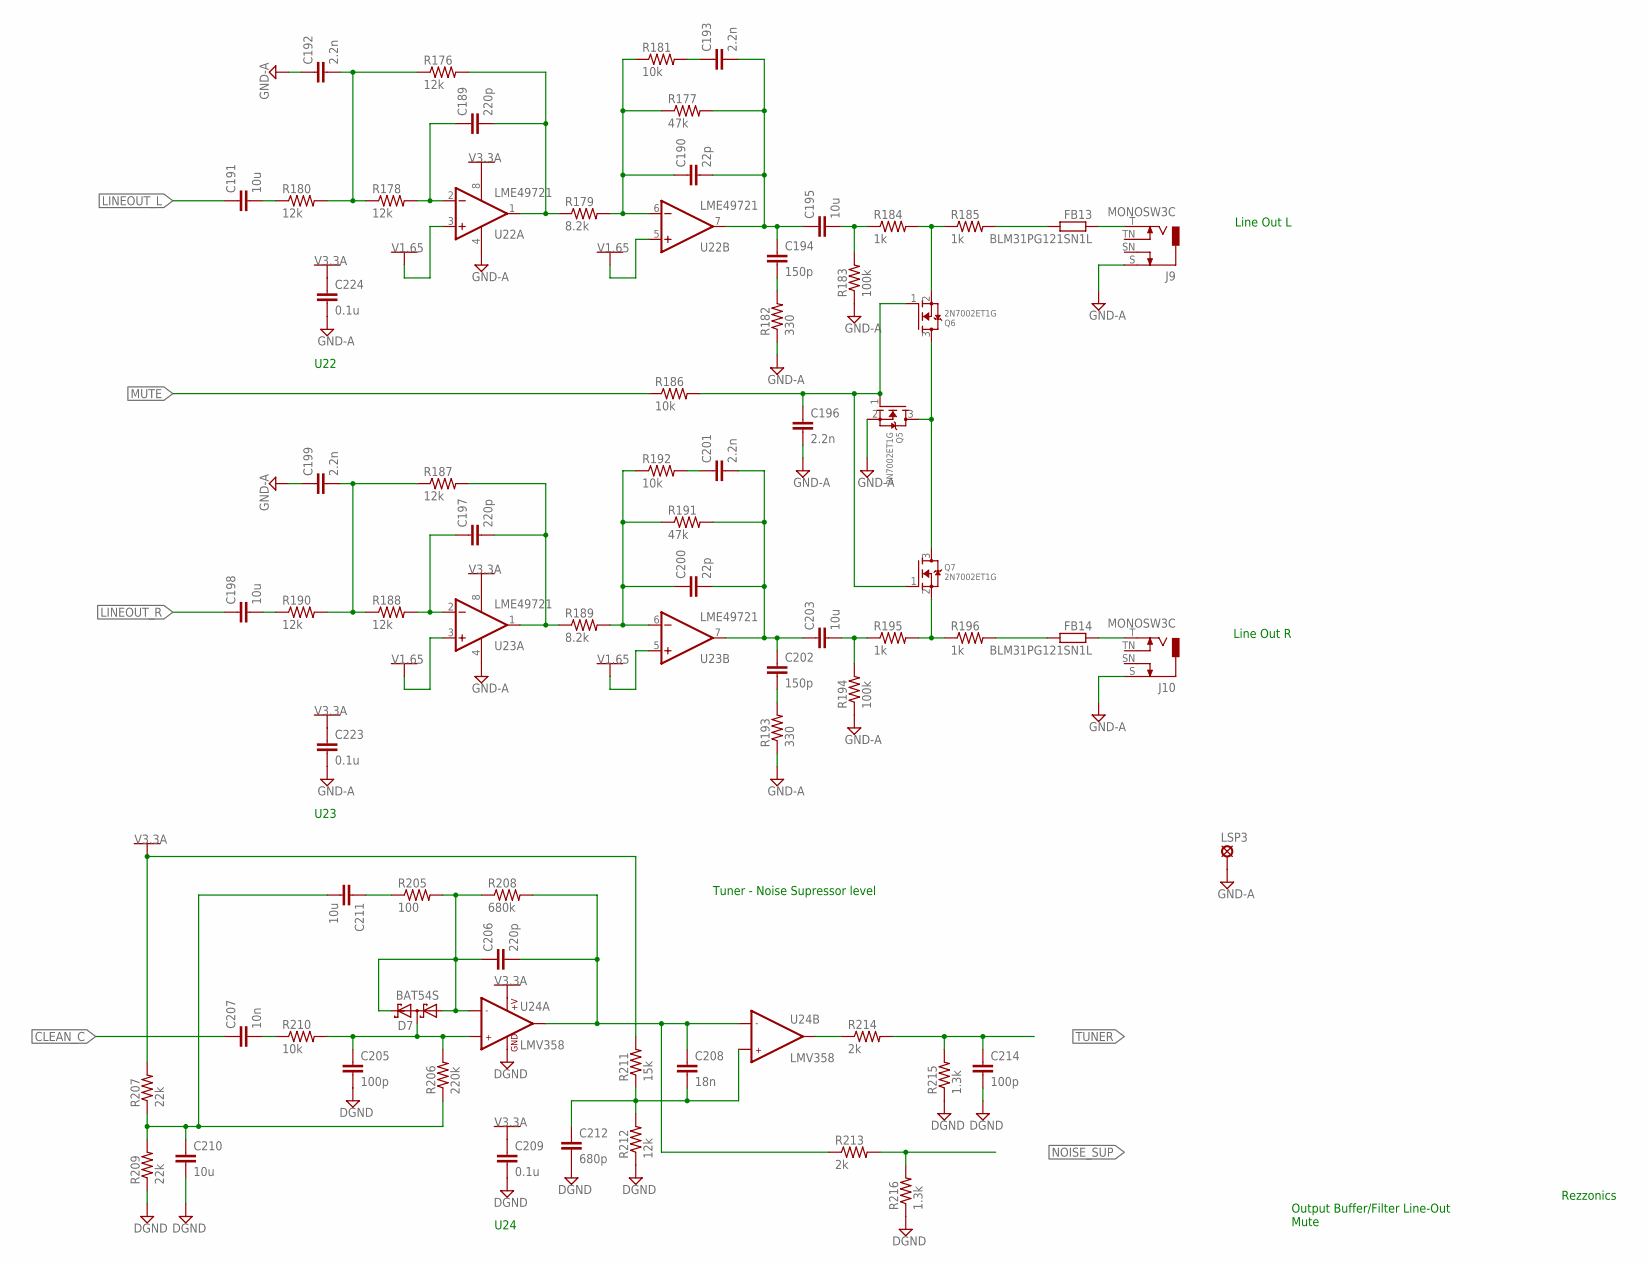
[picture p67: schematic DMFX-1 v1.2.sch, sheet 12]

Parts:
C189, C197, C206: 220p; 0402-CAP; MPN GRM1555C1H221FA01D
C190, C200: 22p; 0402-CAP; MPN GRM1555C2A220JA01D
C191, C195, C198, C203, C210, C211: 10u; C0805K; MPN GRM21BR71A106KA73L
C192, C193, C196, C199, C201: 2.2n; 0402-CAP; MPN GRM155R71H222JA01J
C194, C202: 150p; 0402-CAP; MPN GRM1555C1H151GA01D
C205, C214: 100p; 0402-CAP; MPN GRM1555C1H101FA01J
C207: 10n; 0402-CAP; MPN GRM155R71E103KA01D
C208: 18n; 0402-CAP; MPN GRM155R71H183KA12D
C209, C223, C224: 0.1u; 0402-CAP; MPN GRM155R71C104JA88D
C212: 680p; 0402-CAP; MPN GRM155R72A681KA01D
D7: BAT54S; SOT23; MPN BAT54SLT1G
FB13, FB14: BLM31PG121SN1L; R1206; MPN BLM31PG121SN1L
J9, J10: MONOSW3C; NEUTRIK-NMJ4HCD2; MPN NMJ4HCD2
LSP3: LSP13; MPN *
Q5, Q6, Q7: 2N7002ET1G; SOT23; MPN 2N7002ET1G
R176, R178, R180, R187, R188, R190, R212: 12k; 0402-RES; MPN ERJ-2RKF1202X
R177, R191: 47k; 0402-RES; MPN ERJ-2RKF4702X
R179, R189: 8.2k; 0402-RES; MPN ERJ-2RKF8201X
R181, R186, R192, R210: 10k; 0402-RES; MPN ERJ-2RKF1002X
R182, R193: 330; 0402-RES; MPN ERJ-2RKF3300X
R183, R194: 100k; 0402-RES; MPN ERJ-2RKF1003X
R184, R185, R195, R196: 1k; 0402-RES; MPN ERJ-2RKF1001X
R205: 100; 0402-RES; MPN ERJ-2RKF1000X
R206: 220k; 0402-RES; MPN ERJ-2RKF2203X
R207, R209: 22k; 0402-RES; MPN ERJ-2RKF2202X
R208: 680k; 0402-RES; MPN ERJ-2RKF6803X
R211: 15k; 0402-RES; MPN ERJ-2RKF1502X
R213, R214: 2k; 0402-RES; MPN ERJ-2RKF2001X
R215, R216: 1.3k; 0402-RES; MPN ERJ-2RKF1301X
U22, U23: LME49721; SO08; MPN LME49721MAX/NOPB
U24: LMV358; SO08; MPN LMV358IDR

Connections:
CLEAN_C: C207.1; also elsewhere on the board
DGND: C205.2, C209.2, C210.2, C212.2, C214.2, R209.1, R212.1, R215.1, R216.1, U24.4 (GND); also elsewhere on the board
GND-A: C192.1, C196.2, C199.1, C223.2, C224.2, J9.S, J10.S, LSP3.MP, Q5.2 (S), R182.1, R183.1, R193.1, R194.1, U22.4 (V-), U23.4 (V-); also elsewhere on the board
LINEOUT_L: C191.1; also elsewhere on the board
LINEOUT_R: C198.1; also elsewhere on the board
MUTE: R186.1; also elsewhere on the board
unnamed: C206.1, D7.1 (A1), D7.2 (C2), R205.2, R208.1, U24.2 (-IN1)
unnamed: C190.1, R177.1, R179.2, R181.1, U22.6 (-IN)
unnamed: C192.2, R176.1, R178.1, R180.2
unnamed: C190.2, C193.2, C194.1, C195.1, R177.2, U22.7 (OUT)
unnamed: C189.2, R176.2, R179.1, U22.1 (OUT)
unnamed: C193.1, R181.2
unnamed: C191.2, R180.1
unnamed: C189.1, R178.2, U22.2 (-IN)
unnamed: C194.2, R182.2
unnamed: Q5.3 (D), Q6.3 (D), Q7.3 (D)
unnamed: C195.2, R183.2, R184.1
unnamed: Q6.2 (S), R184.2, R185.1
unnamed: FB13.1, J9.T
unnamed: C196.1, Q5.1 (G), Q6.1 (G), Q7.1 (G), R186.2
unnamed: FB13.2, R185.2
unnamed: C199.2, R187.1, R188.1, R190.2
unnamed: C197.2, R187.2, R189.1, U23.1 (OUT)
unnamed: C198.2, R190.1
unnamed: C197.1, R188.2, U23.2 (-IN)
unnamed: C200.1, R189.2, R191.1, R192.1, U23.6 (-IN)
unnamed: C200.2, C201.2, C202.1, C203.1, R191.2, U23.7 (OUT)
unnamed: C201.1, R192.2
unnamed: C202.2, R193.2
unnamed: C203.2, R194.2, R195.1
unnamed: Q7.2 (S), R195.2, R196.1
unnamed: FB14.1, J10.T
unnamed: FB14.2, R196.2
unnamed: C206.2, C208.1, R208.2, R213.1, U24.1 (OUT1), U24.6 (-IN2)
unnamed: C210.1, C211.2, R206.1, R207.1, R209.2
unnamed: C207.2, R210.1
unnamed: C205.1, D7.3 (C1A2), R206.2, R210.2, U24.3 (+IN1)
unnamed: C211.1, R205.1
unnamed: C208.2, C212.1, R211.1, R212.2, U24.5 (+IN2)
unnamed: R214.1, U24.7 (OUT2)
NOISE_SUP: R213.2, R216.2; also elsewhere on the board
TUNER: C214.1, R214.2, R215.2; also elsewhere on the board
V1.65: U22.3 (+IN), U22.5 (+IN), U23.3 (+IN), U23.5 (+IN); also elsewhere on the board
V3.3A: C209.1, C223.1, C224.1, R207.2, R211.2, U22.8 (V+), U23.8 (V+), U24.8 (+V); also elsewhere on the board

Notes on the sheet:
Line Out L
Line Out R
Rezzonics
Output Buffer/Filter Line-Out Mute
Tuner - Noise Supressor level
U24
U23
U22

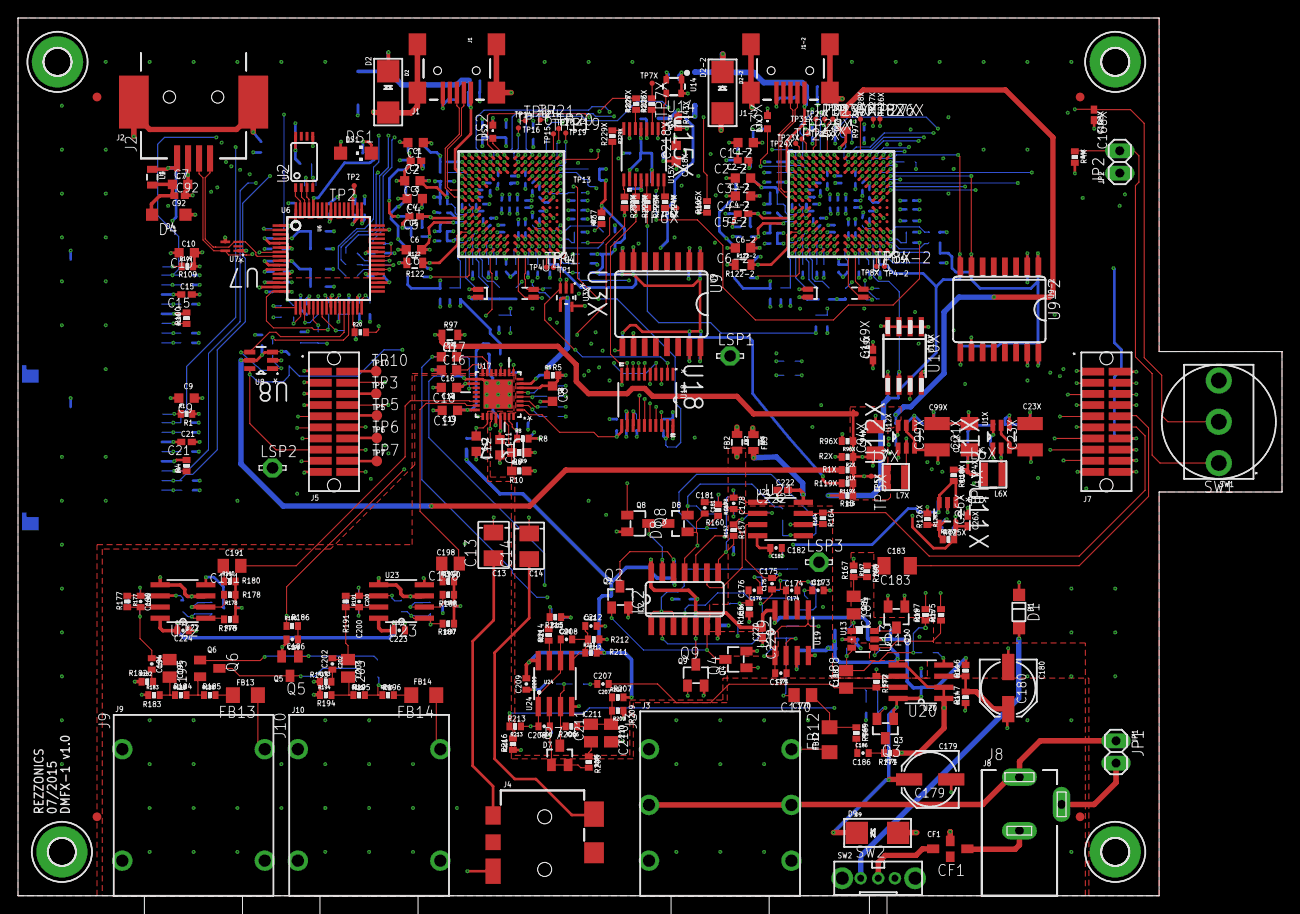
[picture p68: board DMFX-1 v1.2.brd from above]

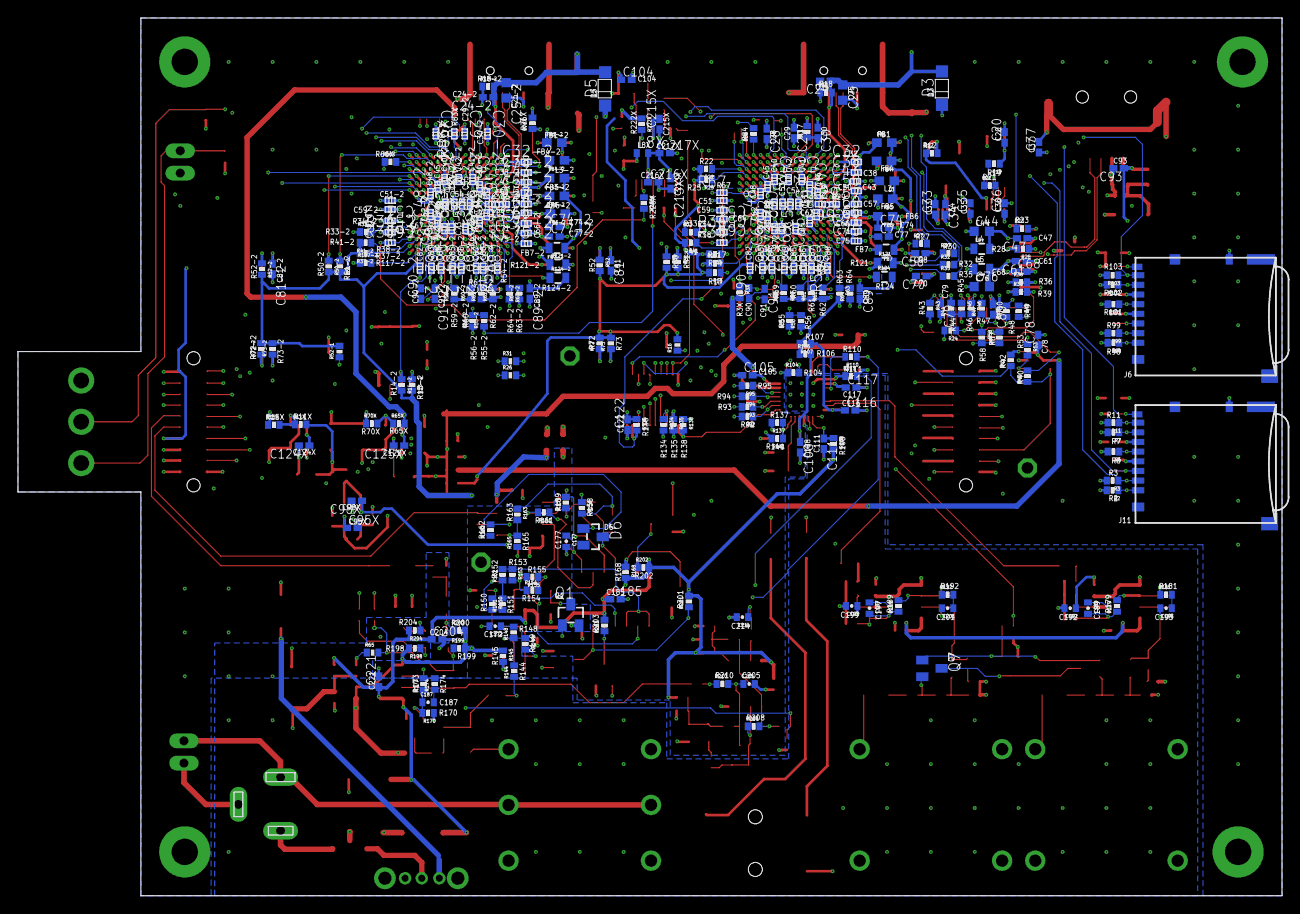
[picture p69: board DMFX-1 v1.2.brd from below]

Board: 6 copper layers, 144.0 x 100.0 mm, 570 parts (320 on the bottom side), 361 nets.
